kpezeshki/esp32-s31-sdr/em/lines/Z0_REPORT.md

# RF trace Z0 vs coplanar ground gap (Sonnet)

| case | Z0 (ohm) | loss @ 6 GHz (dB/mm) |
|---|---|---|
| w0.19_ginf | 50.8 | 0.028 |
| w0.19_g0.4 | 50.7 | 0.028 |
| w0.19_g0.3 | 50.6 | 0.028 |
| w0.19_g0.2 | 50.4 | 0.028 |
| w0.17_g0.2 | 57.6 | 0.041 |
| w0.16_g0.2 | 57.6 | 0.041 |
| w0.19_g0.15 | 49.8 | 0.028 |
| w0.17_g0.15 | 57.1 | 0.040 |
| w0.16_g0.15 | 57.1 | 0.040 |
