kpezeshki/esp32-s31-sdr/analysis/export/cascade_tables.md

# Cascade tables (auto-generated by analysis/cascade.py)

Assumptions: kT = -174.0 dBm/Hz, capture BW = 40 MHz complex, 8-bit I/Q, ESP32 NF = 5.0 dB.  
Pout columns = signal level at the *output* of each stage for the given antenna power (small-signal, ignores compression).  
'Noise out' = thermal + added noise density at each node.  ESP32 row = level at the ESP32 RF pin (before its internal gain).

## Summary

| Case | Gain to ESP32 pin | NF | IIP3 in | P1dB in | Noise dBm/40MHz | MDS 1 kHz | ADC clip @ant. | SFDR 10 kHz |
|---|---|---|---|---|---|---|---|---|
| LB 100 MHz | +12.2 | 2.46 | 1.7 | -9.1 | -95.5 | -141.5 | -52 |  89 |
| LB 1090 MHz | +6.2 | 4.46 | 7.7 | -3.1 | -93.5 | -139.5 | -50 |  91 |
| LB 1600 MHz | +2.9 | 6.44 | 11.0 | 0.2 | -91.5 | -137.6 | -48 |  92 |
| HB 3500 MHz | +3.7 | 6.34 | 4.5 | -5.6 | -91.6 | -137.7 | -48 |  88 |
| HB 5800 MHz | -1.5 | 10.20 | 5.7 | -5.0 | -87.8 | -133.8 | -44 |  86 |
| LB 1090 MHz + optional IF LNA | +20.2 | 3.72 | 2.7 | -7.6 | -94.3 | -140.3 | -50 |  89 |
| HB 5800 MHz + optional IF LNA | +12.5 | 8.94 | 4.8 | -5.0 | -89.0 | -135.1 | -45 |  87 |
| LB 100 MHz + gain block | +28.2 | 1.56 |  -14.6 |  -25.1 | -96.4 | -142.4 | -53 |  79 |
| LB 1090 MHz + gain block | +21.7 | 1.73 | -8.2 |  -18.6 | -96.2 | -142.3 | -52 |  83 |
| LB 1600 MHz + gain block | +18.1 | 2.02 | -4.7 |  -15.0 | -96.0 | -142.0 | -52 |  85 |
| HB 3500 MHz + gain block | +17.5 | 2.94 | -8.2 |  -19.4 | -95.0 | -141.1 | -51 |  82 |
| HB 5800 MHz + gain block | +10.6 | 4.46 | -5.9 |  -17.1 | -93.5 | -139.5 | -50 |  82 |
| Native ESP32 path 2441 MHz | -0.7 | 5.70 |  --  |  --  | -92.3 | -138.3 | -48 |  --  |

## Node tables

### LB 100 MHz

| # | Stage | G | NF | IIP3 (stage) | Cum G | Cum NF | Cum IIP3 (in-ref) | Noise out dBm/Hz | Noise out dBm/40MHz | Pout @ Pin=-100 | Pout @ Pin=-60 | Pout @ Pin=-30 |
|---|---|---|---|---|---|---|---|---|---|---|---|---|
| 1 | SMA + ESD + trace | -0.3 | 0.3 |  --  | -0.3 | 0.30 |  --  | -174.0 | -98.0 | -100.3 | -60.3 | -30.3 |
| 2 | SPDT_in (band select) | -0.4 | 0.4 | 60.0 | -0.7 | 0.70 | 60.3 | -174.0 | -98.0 | -100.7 | -60.7 | -30.7 |
| 3 | LNA_LB (SPF5189Z-cl.) | +23.0 | 0.8 | 15.5 | +22.3 | 1.50 | 16.2 | -150.2 | -74.2 | -77.7 | -37.7 | -7.7 |
| 4 | Post-LNA LPF 1.75G | -0.8 | 0.8 |  --  | +21.5 | 1.50 | 16.2 | -151.0 | -75.0 | -78.5 | -38.5 | -8.5 |
| 5 | SPDT_out | -0.4 | 0.4 | 60.0 | +21.1 | 1.51 | 16.2 | -151.4 | -75.4 | -78.9 | -38.9 | -8.9 |
| 6 | Input balun 1:2 | -1.0 | 1.0 |  --  | +20.1 | 1.51 | 16.2 | -152.4 | -76.4 | -79.9 | -39.9 | -9.9 |
| 7 | RFFC507x mixer + 4:1 balun | -5.0 | 13.0 | 22.0 | +15.1 | 2.05 | 1.7 | -156.9 | -80.8 | -84.9 | -44.9 | -14.9 |
| 8 | IF SAW/BAW 2.44G | -2.5 | 2.5 | 45.0 | +12.6 | 2.11 | 1.7 | -159.3 | -83.3 | -87.4 | -47.4 | -17.4 |
| 9 | 0R tee + ESP32 match | -0.4 | 0.4 |  --  | +12.2 | 2.12 | 1.7 | -159.7 | -83.7 | -87.8 | -47.8 | -17.8 |
| 10 | ESP32-S31 RX | +0.0 | 5.0 |  --  | +12.2 | 2.46 | 1.7 | -159.3 | -83.3 | -87.8 | -47.8 | -17.8 |

Gain to ESP32 pin **+12.2 dB**, system NF (incl. ESP32 5 dB) **2.46 dB**, front-end input IIP3 **+1.7 dBm**, first-stage input P1dB **-9.1 dBm** (analog, excl. ESP32/ADC).  
Noise floor at antenna: -171.5 dBm/Hz = -95.5 dBm in 40 MHz; MDS(1 kHz, SNR 0 dB) -141.5 dBm; 8-bit ADC instantaneous DR ~44 dB in 40 MHz -> in-band clip ~**-52 dBm** at the antenna (ESP32 gain set so noise sits 6 dB over quantization); SFDR(analog, 10 kHz) 89 dB.

### LB 1090 MHz

| # | Stage | G | NF | IIP3 (stage) | Cum G | Cum NF | Cum IIP3 (in-ref) | Noise out dBm/Hz | Noise out dBm/40MHz | Pout @ Pin=-100 | Pout @ Pin=-60 | Pout @ Pin=-30 |
|---|---|---|---|---|---|---|---|---|---|---|---|---|
| 1 | SMA + ESD + trace | -0.3 | 0.3 |  --  | -0.3 | 0.30 |  --  | -174.0 | -98.0 | -100.3 | -60.3 | -30.3 |
| 2 | SPDT_in (band select) | -0.4 | 0.4 | 60.0 | -0.7 | 0.70 | 60.3 | -174.0 | -98.0 | -100.7 | -60.7 | -30.7 |
| 3 | LNA_LB (SPF5189Z-cl.) | +17.4 | 0.8 | 21.1 | +16.7 | 1.48 | 21.8 | -155.8 | -79.8 | -83.3 | -43.3 | -13.3 |
| 4 | Post-LNA LPF 1.75G | -1.2 | 1.2 |  --  | +15.5 | 1.51 | 21.8 | -157.0 | -81.0 | -84.5 | -44.5 | -14.5 |
| 5 | SPDT_out | -0.4 | 0.4 | 60.0 | +15.1 | 1.51 | 21.8 | -157.4 | -81.4 | -84.9 | -44.9 | -14.9 |
| 6 | Input balun 1:2 | -1.0 | 1.0 |  --  | +14.1 | 1.54 | 21.8 | -158.4 | -82.3 | -85.9 | -45.9 | -15.9 |
| 7 | RFFC507x mixer + 4:1 balun | -5.0 | 13.0 | 22.0 | +9.1 | 3.35 | 7.7 | -161.5 | -85.5 | -90.9 | -50.9 | -20.9 |
| 8 | IF SAW/BAW 2.44G | -2.5 | 2.5 | 45.0 | +6.6 | 3.53 | 7.7 | -163.9 | -87.8 | -93.4 | -53.4 | -23.4 |
| 9 | 0R tee + ESP32 match | -0.4 | 0.4 |  --  | +6.2 | 3.57 | 7.7 | -164.2 | -88.2 | -93.8 | -53.8 | -23.8 |
| 10 | ESP32-S31 RX | +0.0 | 5.0 |  --  | +6.2 | 4.46 | 7.7 | -163.3 | -87.3 | -93.8 | -53.8 | -23.8 |

Gain to ESP32 pin **+6.2 dB**, system NF (incl. ESP32 5 dB) **4.46 dB**, front-end input IIP3 **+7.7 dBm**, first-stage input P1dB **-3.1 dBm** (analog, excl. ESP32/ADC).  
Noise floor at antenna: -169.5 dBm/Hz = -93.5 dBm in 40 MHz; MDS(1 kHz, SNR 0 dB) -139.5 dBm; 8-bit ADC instantaneous DR ~44 dB in 40 MHz -> in-band clip ~**-50 dBm** at the antenna (ESP32 gain set so noise sits 6 dB over quantization); SFDR(analog, 10 kHz) 91 dB.

### LB 1600 MHz

| # | Stage | G | NF | IIP3 (stage) | Cum G | Cum NF | Cum IIP3 (in-ref) | Noise out dBm/Hz | Noise out dBm/40MHz | Pout @ Pin=-100 | Pout @ Pin=-60 | Pout @ Pin=-30 |
|---|---|---|---|---|---|---|---|---|---|---|---|---|
| 1 | SMA + ESD + trace | -0.3 | 0.3 |  --  | -0.3 | 0.30 |  --  | -174.0 | -98.0 | -100.3 | -60.3 | -30.3 |
| 2 | SPDT_in (band select) | -0.4 | 0.4 | 60.0 | -0.7 | 0.70 | 60.3 | -174.0 | -98.0 | -100.7 | -60.7 | -30.7 |
| 3 | LNA_LB (SPF5189Z-cl.) | +14.4 | 0.8 | 24.1 | +13.7 | 1.46 | 24.8 | -158.9 | -82.8 | -86.3 | -46.3 | -16.3 |
| 4 | Post-LNA LPF 1.75G | -1.5 | 1.5 |  --  | +12.2 | 1.51 | 24.8 | -160.3 | -84.3 | -87.8 | -47.8 | -17.8 |
| 5 | SPDT_out | -0.4 | 0.4 | 60.0 | +11.8 | 1.53 | 24.8 | -160.7 | -84.7 | -88.2 | -48.2 | -18.2 |
| 6 | Input balun 1:2 | -1.0 | 1.0 |  --  | +10.8 | 1.58 | 24.8 | -161.7 | -85.6 | -89.2 | -49.2 | -19.2 |
| 7 | RFFC507x mixer + 4:1 balun | -5.0 | 13.0 | 22.0 | +5.8 | 4.82 | 11.1 | -163.4 | -87.4 | -94.2 | -54.2 | -24.2 |
| 8 | IF SAW/BAW 2.44G | -2.5 | 2.5 | 45.0 | +3.3 | 5.10 | 11.0 | -165.6 | -89.6 | -96.7 | -56.7 | -26.7 |
| 9 | 0R tee + ESP32 match | -0.4 | 0.4 |  --  | +2.9 | 5.16 | 11.0 | -166.0 | -90.0 | -97.1 | -57.1 | -27.1 |
| 10 | ESP32-S31 RX | +0.0 | 5.0 |  --  | +2.9 | 6.44 | 11.0 | -164.7 | -88.7 | -97.1 | -57.1 | -27.1 |

Gain to ESP32 pin **+2.9 dB**, system NF (incl. ESP32 5 dB) **6.44 dB**, front-end input IIP3 **+11.0 dBm**, first-stage input P1dB **+0.2 dBm** (analog, excl. ESP32/ADC).  
Noise floor at antenna: -167.6 dBm/Hz = -91.5 dBm in 40 MHz; MDS(1 kHz, SNR 0 dB) -137.6 dBm; 8-bit ADC instantaneous DR ~44 dB in 40 MHz -> in-band clip ~**-48 dBm** at the antenna (ESP32 gain set so noise sits 6 dB over quantization); SFDR(analog, 10 kHz) 92 dB.

### HB 3500 MHz

| # | Stage | G | NF | IIP3 (stage) | Cum G | Cum NF | Cum IIP3 (in-ref) | Noise out dBm/Hz | Noise out dBm/40MHz | Pout @ Pin=-100 | Pout @ Pin=-60 | Pout @ Pin=-30 |
|---|---|---|---|---|---|---|---|---|---|---|---|---|
| 1 | SMA + ESD + trace | -0.4 | 0.4 |  --  | -0.4 | 0.43 |  --  | -174.0 | -98.0 | -100.4 | -60.4 | -30.4 |
| 2 | SPDT_in (band select) | -0.7 | 0.7 | 60.0 | -1.1 | 1.08 | 60.4 | -174.0 | -98.0 | -101.1 | -61.1 | -31.1 |
| 3 | Pre-LNA HPF 2nd order | -0.3 | 0.3 |  --  | -1.4 | 1.38 | 60.4 | -174.0 | -98.0 | -101.4 | -61.4 | -31.4 |
| 4 | LNA_HB (0.5-6G MMIC) | +17.5 | 1.2 | 7.5 | +16.1 | 2.55 | 8.9 | -155.3 | -79.3 | -83.9 | -43.9 | -13.9 |
| 5 | Post-LNA HPF 2.95G | -1.3 | 1.3 |  --  | +14.9 | 2.57 | 8.9 | -156.6 | -80.6 | -85.2 | -45.1 | -15.1 |
| 6 | SPDT_out | -0.7 | 0.7 | 60.0 | +14.2 | 2.58 | 8.9 | -157.2 | -81.2 | -85.8 | -45.8 | -15.8 |
| 7 | Input balun 1:2 | -1.3 | 1.3 |  --  | +12.9 | 2.61 | 8.9 | -158.5 | -82.5 | -87.1 | -47.1 | -17.1 |
| 8 | RFFC507x mixer + 4:1 balun | -6.3 | 14.3 | 19.3 | +6.6 | 5.00 | 4.5 | -162.4 | -86.4 | -93.4 | -53.4 | -23.4 |
| 9 | IF SAW/BAW 2.44G | -2.5 | 2.5 | 45.0 | +4.1 | 5.23 | 4.5 | -164.7 | -88.7 | -95.9 | -55.9 | -25.9 |
| 10 | 0R tee + ESP32 match | -0.4 | 0.4 |  --  | +3.7 | 5.28 | 4.5 | -165.1 | -89.0 | -96.3 | -56.3 | -26.3 |
| 11 | ESP32-S31 RX | +0.0 | 5.0 |  --  | +3.7 | 6.34 | 4.5 | -164.0 | -88.0 | -96.3 | -56.3 | -26.3 |

Gain to ESP32 pin **+3.7 dB**, system NF (incl. ESP32 5 dB) **6.34 dB**, front-end input IIP3 **+4.5 dBm**, first-stage input P1dB **-5.6 dBm** (analog, excl. ESP32/ADC).  
Noise floor at antenna: -167.7 dBm/Hz = -91.6 dBm in 40 MHz; MDS(1 kHz, SNR 0 dB) -137.7 dBm; 8-bit ADC instantaneous DR ~44 dB in 40 MHz -> in-band clip ~**-48 dBm** at the antenna (ESP32 gain set so noise sits 6 dB over quantization); SFDR(analog, 10 kHz) 88 dB.

### HB 5800 MHz

| # | Stage | G | NF | IIP3 (stage) | Cum G | Cum NF | Cum IIP3 (in-ref) | Noise out dBm/Hz | Noise out dBm/40MHz | Pout @ Pin=-100 | Pout @ Pin=-60 | Pout @ Pin=-30 |
|---|---|---|---|---|---|---|---|---|---|---|---|---|
| 1 | SMA + ESD + trace | -0.6 | 0.6 |  --  | -0.6 | 0.59 |  --  | -174.0 | -98.0 | -100.6 | -60.6 | -30.6 |
| 2 | SPDT_in (band select) | -0.9 | 0.9 | 60.0 | -1.5 | 1.47 | 60.6 | -174.0 | -98.0 | -101.5 | -61.5 | -31.5 |
| 3 | Pre-LNA HPF 2nd order | -0.3 | 0.3 |  --  | -1.8 | 1.77 | 60.6 | -174.0 | -98.0 | -101.8 | -61.8 | -31.8 |
| 4 | LNA_HB (0.5-6G MMIC) | +15.2 | 1.5 | 9.8 | +13.4 | 3.24 | 11.6 | -157.3 | -81.3 | -86.6 | -46.6 | -16.6 |
| 5 | Post-LNA HPF 2.95G | -1.6 | 1.6 |  --  | +11.9 | 3.28 | 11.6 | -158.9 | -82.8 | -88.1 | -48.1 | -18.1 |
| 6 | SPDT_out | -0.9 | 0.9 | 60.0 | +11.0 | 3.31 | 11.6 | -159.7 | -83.7 | -89.0 | -49.0 | -19.0 |
| 7 | Input balun 1:2 | -1.8 | 1.8 |  --  | +9.2 | 3.39 | 11.6 | -161.4 | -85.4 | -90.8 | -50.8 | -20.8 |
| 8 | RFFC507x mixer + 4:1 balun | -7.9 | 15.9 | 16.3 | +1.4 | 8.25 | 5.7 | -164.4 | -88.4 | -98.6 | -58.6 | -28.6 |
| 9 | IF SAW/BAW 2.44G | -2.5 | 2.5 | 45.0 | -1.1 | 8.61 | 5.7 | -166.5 | -90.5 | -101.1 | -61.1 | -31.1 |
| 10 | 0R tee + ESP32 match | -0.4 | 0.4 |  --  | -1.5 | 8.68 | 5.7 | -166.9 | -90.8 | -101.5 | -61.5 | -31.5 |
| 11 | ESP32-S31 RX | +0.0 | 5.0 |  --  | -1.5 | 10.20 | 5.7 | -165.3 | -89.3 | -101.5 | -61.5 | -31.5 |

Gain to ESP32 pin **-1.5 dB**, system NF (incl. ESP32 5 dB) **10.20 dB**, front-end input IIP3 **+5.7 dBm**, first-stage input P1dB **-5.0 dBm** (analog, excl. ESP32/ADC).  
Noise floor at antenna: -163.8 dBm/Hz = -87.8 dBm in 40 MHz; MDS(1 kHz, SNR 0 dB) -133.8 dBm; 8-bit ADC instantaneous DR ~44 dB in 40 MHz -> in-band clip ~**-44 dBm** at the antenna (ESP32 gain set so noise sits 6 dB over quantization); SFDR(analog, 10 kHz) 86 dB.

### LB 1090 MHz + optional IF LNA

| # | Stage | G | NF | IIP3 (stage) | Cum G | Cum NF | Cum IIP3 (in-ref) | Noise out dBm/Hz | Noise out dBm/40MHz | Pout @ Pin=-100 | Pout @ Pin=-60 | Pout @ Pin=-30 |
|---|---|---|---|---|---|---|---|---|---|---|---|---|
| 1 | SMA + ESD + trace | -0.3 | 0.3 |  --  | -0.3 | 0.30 |  --  | -174.0 | -98.0 | -100.3 | -60.3 | -30.3 |
| 2 | SPDT_in (band select) | -0.4 | 0.4 | 60.0 | -0.7 | 0.70 | 60.3 | -174.0 | -98.0 | -100.7 | -60.7 | -30.7 |
| 3 | LNA_LB (SPF5189Z-cl.) | +17.4 | 0.8 | 21.1 | +16.7 | 1.48 | 21.8 | -155.8 | -79.8 | -83.3 | -43.3 | -13.3 |
| 4 | Post-LNA LPF 1.75G | -1.2 | 1.2 |  --  | +15.5 | 1.51 | 21.8 | -157.0 | -81.0 | -84.5 | -44.5 | -14.5 |
| 5 | SPDT_out | -0.4 | 0.4 | 60.0 | +15.1 | 1.51 | 21.8 | -157.4 | -81.4 | -84.9 | -44.9 | -14.9 |
| 6 | Input balun 1:2 | -1.0 | 1.0 |  --  | +14.1 | 1.54 | 21.8 | -158.4 | -82.3 | -85.9 | -45.9 | -15.9 |
| 7 | RFFC507x mixer + 4:1 balun | -5.0 | 13.0 | 22.0 | +9.1 | 3.35 | 7.7 | -161.5 | -85.5 | -90.9 | -50.9 | -20.9 |
| 8 | IF SAW/BAW 2.44G | -2.5 | 2.5 | 45.0 | +6.6 | 3.53 | 7.7 | -163.9 | -87.8 | -93.4 | -53.4 | -23.4 |
| 9 | IF LNA 2.4G (opt.) | +14.0 | 1.3 | 11.0 | +20.6 | 3.68 | 2.7 | -149.7 | -73.7 | -79.4 | -39.4 | -9.4 |
| 10 | 0R tee + ESP32 match | -0.4 | 0.4 |  --  | +20.2 | 3.68 | 2.7 | -150.1 | -74.1 | -79.8 | -39.8 | -9.8 |
| 11 | ESP32-S31 RX | +0.0 | 5.0 |  --  | +20.2 | 3.72 | 2.7 | -150.1 | -74.1 | -79.8 | -39.8 | -9.8 |

Gain to ESP32 pin **+20.2 dB**, system NF (incl. ESP32 5 dB) **3.72 dB**, front-end input IIP3 **+2.7 dBm**, first-stage input P1dB **-7.6 dBm** (analog, excl. ESP32/ADC).  
Noise floor at antenna: -170.3 dBm/Hz = -94.3 dBm in 40 MHz; MDS(1 kHz, SNR 0 dB) -140.3 dBm; 8-bit ADC instantaneous DR ~44 dB in 40 MHz -> in-band clip ~**-50 dBm** at the antenna (ESP32 gain set so noise sits 6 dB over quantization); SFDR(analog, 10 kHz) 89 dB.

### HB 5800 MHz + optional IF LNA

| # | Stage | G | NF | IIP3 (stage) | Cum G | Cum NF | Cum IIP3 (in-ref) | Noise out dBm/Hz | Noise out dBm/40MHz | Pout @ Pin=-100 | Pout @ Pin=-60 | Pout @ Pin=-30 |
|---|---|---|---|---|---|---|---|---|---|---|---|---|
| 1 | SMA + ESD + trace | -0.6 | 0.6 |  --  | -0.6 | 0.59 |  --  | -174.0 | -98.0 | -100.6 | -60.6 | -30.6 |
| 2 | SPDT_in (band select) | -0.9 | 0.9 | 60.0 | -1.5 | 1.47 | 60.6 | -174.0 | -98.0 | -101.5 | -61.5 | -31.5 |
| 3 | Pre-LNA HPF 2nd order | -0.3 | 0.3 |  --  | -1.8 | 1.77 | 60.6 | -174.0 | -98.0 | -101.8 | -61.8 | -31.8 |
| 4 | LNA_HB (0.5-6G MMIC) | +15.2 | 1.5 | 9.8 | +13.4 | 3.24 | 11.6 | -157.3 | -81.3 | -86.6 | -46.6 | -16.6 |
| 5 | Post-LNA HPF 2.95G | -1.6 | 1.6 |  --  | +11.9 | 3.28 | 11.6 | -158.9 | -82.8 | -88.1 | -48.1 | -18.1 |
| 6 | SPDT_out | -0.9 | 0.9 | 60.0 | +11.0 | 3.31 | 11.6 | -159.7 | -83.7 | -89.0 | -49.0 | -19.0 |
| 7 | Input balun 1:2 | -1.8 | 1.8 |  --  | +9.2 | 3.39 | 11.6 | -161.4 | -85.4 | -90.8 | -50.8 | -20.8 |
| 8 | RFFC507x mixer + 4:1 balun | -7.9 | 15.9 | 16.3 | +1.4 | 8.25 | 5.7 | -164.4 | -88.4 | -98.6 | -58.6 | -28.6 |
| 9 | IF SAW/BAW 2.44G | -2.5 | 2.5 | 45.0 | -1.1 | 8.61 | 5.7 | -166.5 | -90.5 | -101.1 | -61.1 | -31.1 |
| 10 | IF LNA 2.4G (opt.) | +14.0 | 1.3 | 11.0 | +12.9 | 8.87 | 4.8 | -152.3 | -76.3 | -87.1 | -47.1 | -17.1 |
| 11 | 0R tee + ESP32 match | -0.4 | 0.4 |  --  | +12.5 | 8.87 | 4.8 | -152.7 | -76.7 | -87.5 | -47.5 | -17.5 |
| 12 | ESP32-S31 RX | +0.0 | 5.0 |  --  | +12.5 | 8.94 | 4.8 | -152.6 | -76.6 | -87.5 | -47.5 | -17.5 |

Gain to ESP32 pin **+12.5 dB**, system NF (incl. ESP32 5 dB) **8.94 dB**, front-end input IIP3 **+4.8 dBm**, first-stage input P1dB **-5.0 dBm** (analog, excl. ESP32/ADC).  
Noise floor at antenna: -165.1 dBm/Hz = -89.0 dBm in 40 MHz; MDS(1 kHz, SNR 0 dB) -135.1 dBm; 8-bit ADC instantaneous DR ~44 dB in 40 MHz -> in-band clip ~**-45 dBm** at the antenna (ESP32 gain set so noise sits 6 dB over quantization); SFDR(analog, 10 kHz) 87 dB.

### LB 100 MHz + gain block

| # | Stage | G | NF | IIP3 (stage) | Cum G | Cum NF | Cum IIP3 (in-ref) | Noise out dBm/Hz | Noise out dBm/40MHz | Pout @ Pin=-100 | Pout @ Pin=-60 | Pout @ Pin=-30 |
|---|---|---|---|---|---|---|---|---|---|---|---|---|
| 1 | SMA + ESD + trace | -0.3 | 0.3 |  --  | -0.3 | 0.30 |  --  | -174.0 | -98.0 | -100.3 | -60.3 | -30.3 |
| 2 | SPDT_in (band select) | -0.4 | 0.4 | 60.0 | -0.7 | 0.70 | 60.3 | -174.0 | -98.0 | -100.7 | -60.7 | -30.7 |
| 3 | LNA_LB (SPF5189Z-cl.) | +23.0 | 0.8 | 15.5 | +22.3 | 1.50 | 16.2 | -150.2 | -74.2 | -77.7 | -37.7 | -7.7 |
| 4 | Post-LNA LPF 1.75G | -0.8 | 0.8 |  --  | +21.5 | 1.50 | 16.2 | -151.0 | -75.0 | -78.5 | -38.5 | -8.5 |
| 5 | SPDT_out | -0.4 | 0.4 | 60.0 | +21.1 | 1.51 | 16.2 | -151.4 | -75.4 | -78.9 | -38.9 | -8.9 |
| 6 | Gain block (opt.) | +16.0 | 3.0 | 16.0 | +37.1 | 1.53 | -5.1 | -135.4 | -59.3 | -62.9 | -22.9 | 7.1 |
| 7 | Input balun 1:2 | -1.0 | 1.0 |  --  | +36.1 | 1.53 | -5.1 | -136.4 | -60.3 | -63.9 | -23.9 | 6.1 |
| 8 | RFFC507x mixer + 4:1 balun | -5.0 | 13.0 | 22.0 | +31.1 | 1.54 |  -14.6 | -141.4 | -65.3 | -68.9 | -28.9 | 1.1 |
| 9 | IF SAW/BAW 2.44G | -2.5 | 2.5 | 45.0 | +28.6 | 1.55 |  -14.6 | -143.9 | -67.8 | -71.4 | -31.4 | -1.4 |
| 10 | 0R tee + ESP32 match | -0.4 | 0.4 |  --  | +28.2 | 1.55 |  -14.6 | -144.3 | -68.2 | -71.8 | -31.8 | -1.8 |
| 11 | ESP32-S31 RX | +0.0 | 5.0 |  --  | +28.2 | 1.56 |  -14.6 | -144.2 | -68.2 | -71.8 | -31.8 | -1.8 |

Gain to ESP32 pin **+28.2 dB**, system NF (incl. ESP32 5 dB) **1.56 dB**, front-end input IIP3 **-14.6 dBm**, first-stage input P1dB **-25.1 dBm** (analog, excl. ESP32/ADC).  
Noise floor at antenna: -172.4 dBm/Hz = -96.4 dBm in 40 MHz; MDS(1 kHz, SNR 0 dB) -142.4 dBm; 8-bit ADC instantaneous DR ~44 dB in 40 MHz -> in-band clip ~**-53 dBm** at the antenna (ESP32 gain set so noise sits 6 dB over quantization); SFDR(analog, 10 kHz) 79 dB.

### LB 1090 MHz + gain block

| # | Stage | G | NF | IIP3 (stage) | Cum G | Cum NF | Cum IIP3 (in-ref) | Noise out dBm/Hz | Noise out dBm/40MHz | Pout @ Pin=-100 | Pout @ Pin=-60 | Pout @ Pin=-30 |
|---|---|---|---|---|---|---|---|---|---|---|---|---|
| 1 | SMA + ESD + trace | -0.3 | 0.3 |  --  | -0.3 | 0.30 |  --  | -174.0 | -98.0 | -100.3 | -60.3 | -30.3 |
| 2 | SPDT_in (band select) | -0.4 | 0.4 | 60.0 | -0.7 | 0.70 | 60.3 | -174.0 | -98.0 | -100.7 | -60.7 | -30.7 |
| 3 | LNA_LB (SPF5189Z-cl.) | +17.4 | 0.8 | 21.1 | +16.7 | 1.48 | 21.8 | -155.8 | -79.8 | -83.3 | -43.3 | -13.3 |
| 4 | Post-LNA LPF 1.75G | -1.2 | 1.2 |  --  | +15.5 | 1.51 | 21.8 | -157.0 | -81.0 | -84.5 | -44.5 | -14.5 |
| 5 | SPDT_out | -0.4 | 0.4 | 60.0 | +15.1 | 1.51 | 21.8 | -157.4 | -81.4 | -84.9 | -44.9 | -14.9 |
| 6 | Gain block (opt.) | +15.5 | 3.3 | 15.5 | +30.6 | 1.62 | 0.3 | -141.8 | -65.8 | -69.4 | -29.4 | 0.6 |
| 7 | Input balun 1:2 | -1.0 | 1.0 |  --  | +29.6 | 1.62 | 0.3 | -142.8 | -66.8 | -70.4 | -30.4 | -0.4 |
| 8 | RFFC507x mixer + 4:1 balun | -5.0 | 13.0 | 22.0 | +24.6 | 1.68 | -8.2 | -147.7 | -71.7 | -75.4 | -35.4 | -5.4 |
| 9 | IF SAW/BAW 2.44G | -2.5 | 2.5 | 45.0 | +22.1 | 1.69 | -8.2 | -150.2 | -74.2 | -77.9 | -37.9 | -7.9 |
| 10 | 0R tee + ESP32 match | -0.4 | 0.4 |  --  | +21.7 | 1.69 | -8.2 | -150.6 | -74.6 | -78.3 | -38.3 | -8.3 |
| 11 | ESP32-S31 RX | +0.0 | 5.0 |  --  | +21.7 | 1.73 | -8.2 | -150.6 | -74.6 | -78.3 | -38.3 | -8.3 |

Gain to ESP32 pin **+21.7 dB**, system NF (incl. ESP32 5 dB) **1.73 dB**, front-end input IIP3 **-8.2 dBm**, first-stage input P1dB **-18.6 dBm** (analog, excl. ESP32/ADC).  
Noise floor at antenna: -172.3 dBm/Hz = -96.2 dBm in 40 MHz; MDS(1 kHz, SNR 0 dB) -142.3 dBm; 8-bit ADC instantaneous DR ~44 dB in 40 MHz -> in-band clip ~**-52 dBm** at the antenna (ESP32 gain set so noise sits 6 dB over quantization); SFDR(analog, 10 kHz) 83 dB.

### LB 1600 MHz + gain block

| # | Stage | G | NF | IIP3 (stage) | Cum G | Cum NF | Cum IIP3 (in-ref) | Noise out dBm/Hz | Noise out dBm/40MHz | Pout @ Pin=-100 | Pout @ Pin=-60 | Pout @ Pin=-30 |
|---|---|---|---|---|---|---|---|---|---|---|---|---|
| 1 | SMA + ESD + trace | -0.3 | 0.3 |  --  | -0.3 | 0.30 |  --  | -174.0 | -98.0 | -100.3 | -60.3 | -30.3 |
| 2 | SPDT_in (band select) | -0.4 | 0.4 | 60.0 | -0.7 | 0.70 | 60.3 | -174.0 | -98.0 | -100.7 | -60.7 | -30.7 |
| 3 | LNA_LB (SPF5189Z-cl.) | +14.4 | 0.8 | 24.1 | +13.7 | 1.46 | 24.8 | -158.9 | -82.8 | -86.3 | -46.3 | -16.3 |
| 4 | Post-LNA LPF 1.75G | -1.5 | 1.5 |  --  | +12.2 | 1.51 | 24.8 | -160.3 | -84.3 | -87.8 | -47.8 | -17.8 |
| 5 | SPDT_out | -0.4 | 0.4 | 60.0 | +11.8 | 1.53 | 24.8 | -160.7 | -84.7 | -88.2 | -48.2 | -18.2 |
| 6 | Gain block (opt.) | +15.2 | 3.4 | 15.2 | +27.0 | 1.76 | 3.4 | -145.3 | -69.2 | -73.0 | -33.0 | -3.0 |
| 7 | Input balun 1:2 | -1.0 | 1.0 |  --  | +26.0 | 1.77 | 3.4 | -146.3 | -70.2 | -74.0 | -34.0 | -4.0 |
| 8 | RFFC507x mixer + 4:1 balun | -5.0 | 13.0 | 22.0 | +21.0 | 1.90 | -4.7 | -151.1 | -75.1 | -79.0 | -39.0 | -9.0 |
| 9 | IF SAW/BAW 2.44G | -2.5 | 2.5 | 45.0 | +18.5 | 1.92 | -4.7 | -153.6 | -77.6 | -81.5 | -41.5 | -11.5 |
| 10 | 0R tee + ESP32 match | -0.4 | 0.4 |  --  | +18.1 | 1.92 | -4.7 | -154.0 | -78.0 | -81.9 | -41.9 | -11.9 |
| 11 | ESP32-S31 RX | +0.0 | 5.0 |  --  | +18.1 | 2.02 | -4.7 | -153.9 | -77.9 | -81.9 | -41.9 | -11.9 |

Gain to ESP32 pin **+18.1 dB**, system NF (incl. ESP32 5 dB) **2.02 dB**, front-end input IIP3 **-4.7 dBm**, first-stage input P1dB **-15.0 dBm** (analog, excl. ESP32/ADC).  
Noise floor at antenna: -172.0 dBm/Hz = -96.0 dBm in 40 MHz; MDS(1 kHz, SNR 0 dB) -142.0 dBm; 8-bit ADC instantaneous DR ~44 dB in 40 MHz -> in-band clip ~**-52 dBm** at the antenna (ESP32 gain set so noise sits 6 dB over quantization); SFDR(analog, 10 kHz) 85 dB.

### HB 3500 MHz + gain block

| # | Stage | G | NF | IIP3 (stage) | Cum G | Cum NF | Cum IIP3 (in-ref) | Noise out dBm/Hz | Noise out dBm/40MHz | Pout @ Pin=-100 | Pout @ Pin=-60 | Pout @ Pin=-30 |
|---|---|---|---|---|---|---|---|---|---|---|---|---|
| 1 | SMA + ESD + trace | -0.4 | 0.4 |  --  | -0.4 | 0.43 |  --  | -174.0 | -98.0 | -100.4 | -60.4 | -30.4 |
| 2 | SPDT_in (band select) | -0.7 | 0.7 | 60.0 | -1.1 | 1.08 | 60.4 | -174.0 | -98.0 | -101.1 | -61.1 | -31.1 |
| 3 | Pre-LNA HPF 2nd order | -0.3 | 0.3 |  --  | -1.4 | 1.38 | 60.4 | -174.0 | -98.0 | -101.4 | -61.4 | -31.4 |
| 4 | LNA_HB (0.5-6G MMIC) | +17.5 | 1.2 | 7.5 | +16.1 | 2.55 | 8.9 | -155.3 | -79.3 | -83.9 | -43.9 | -13.9 |
| 5 | Post-LNA HPF 2.95G | -1.3 | 1.3 |  --  | +14.9 | 2.57 | 8.9 | -156.6 | -80.6 | -85.2 | -45.1 | -15.1 |
| 6 | SPDT_out | -0.7 | 0.7 | 60.0 | +14.2 | 2.58 | 8.9 | -157.2 | -81.2 | -85.8 | -45.8 | -15.8 |
| 7 | Gain block (opt.) | +13.9 | 3.9 | 14.2 | +28.1 | 2.71 | -0.5 | -143.2 | -67.2 | -71.9 | -31.9 | -1.9 |
| 8 | Input balun 1:2 | -1.3 | 1.3 |  --  | +26.8 | 2.71 | -0.5 | -144.5 | -68.5 | -73.2 | -33.2 | -3.2 |
| 9 | RFFC507x mixer + 4:1 balun | -6.3 | 14.3 | 19.3 | +20.4 | 2.84 | -8.2 | -150.7 | -74.7 | -79.6 | -39.6 | -9.6 |
| 10 | IF SAW/BAW 2.44G | -2.5 | 2.5 | 45.0 | +17.9 | 2.85 | -8.2 | -153.2 | -77.2 | -82.1 | -42.1 | -12.1 |
| 11 | 0R tee + ESP32 match | -0.4 | 0.4 |  --  | +17.5 | 2.86 | -8.2 | -153.6 | -77.6 | -82.5 | -42.5 | -12.5 |
| 12 | ESP32-S31 RX | +0.0 | 5.0 |  --  | +17.5 | 2.94 | -8.2 | -153.5 | -77.5 | -82.5 | -42.5 | -12.5 |

Gain to ESP32 pin **+17.5 dB**, system NF (incl. ESP32 5 dB) **2.94 dB**, front-end input IIP3 **-8.2 dBm**, first-stage input P1dB **-19.4 dBm** (analog, excl. ESP32/ADC).  
Noise floor at antenna: -171.1 dBm/Hz = -95.0 dBm in 40 MHz; MDS(1 kHz, SNR 0 dB) -141.1 dBm; 8-bit ADC instantaneous DR ~44 dB in 40 MHz -> in-band clip ~**-51 dBm** at the antenna (ESP32 gain set so noise sits 6 dB over quantization); SFDR(analog, 10 kHz) 82 dB.

### HB 5800 MHz + gain block

| # | Stage | G | NF | IIP3 (stage) | Cum G | Cum NF | Cum IIP3 (in-ref) | Noise out dBm/Hz | Noise out dBm/40MHz | Pout @ Pin=-100 | Pout @ Pin=-60 | Pout @ Pin=-30 |
|---|---|---|---|---|---|---|---|---|---|---|---|---|
| 1 | SMA + ESD + trace | -0.6 | 0.6 |  --  | -0.6 | 0.59 |  --  | -174.0 | -98.0 | -100.6 | -60.6 | -30.6 |
| 2 | SPDT_in (band select) | -0.9 | 0.9 | 60.0 | -1.5 | 1.47 | 60.6 | -174.0 | -98.0 | -101.5 | -61.5 | -31.5 |
| 3 | Pre-LNA HPF 2nd order | -0.3 | 0.3 |  --  | -1.8 | 1.77 | 60.6 | -174.0 | -98.0 | -101.8 | -61.8 | -31.8 |
| 4 | LNA_HB (0.5-6G MMIC) | +15.2 | 1.5 | 9.8 | +13.4 | 3.24 | 11.6 | -157.3 | -81.3 | -86.6 | -46.6 | -16.6 |
| 5 | Post-LNA HPF 2.95G | -1.6 | 1.6 |  --  | +11.9 | 3.28 | 11.6 | -158.9 | -82.8 | -88.1 | -48.1 | -18.1 |
| 6 | SPDT_out | -0.9 | 0.9 | 60.0 | +11.0 | 3.31 | 11.6 | -159.7 | -83.7 | -89.0 | -49.0 | -19.0 |
| 7 | Gain block (opt.) | +12.2 | 4.5 | 13.1 | +23.1 | 3.59 | 1.7 | -147.3 | -71.3 | -76.9 | -36.9 | -6.9 |
| 8 | Input balun 1:2 | -1.8 | 1.8 |  --  | +21.4 | 3.59 | 1.7 | -149.0 | -73.0 | -78.6 | -38.6 | -8.6 |
| 9 | RFFC507x mixer + 4:1 balun | -7.9 | 15.9 | 16.3 | +13.5 | 4.09 | -5.9 | -156.4 | -80.4 | -86.5 | -46.5 | -16.5 |
| 10 | IF SAW/BAW 2.44G | -2.5 | 2.5 | 45.0 | +11.0 | 4.14 | -5.9 | -158.9 | -82.8 | -89.0 | -49.0 | -19.0 |
| 11 | 0R tee + ESP32 match | -0.4 | 0.4 |  --  | +10.6 | 4.16 | -5.9 | -159.2 | -83.2 | -89.4 | -49.4 | -19.4 |
| 12 | ESP32-S31 RX | +0.0 | 5.0 |  --  | +10.6 | 4.46 | -5.9 | -158.9 | -82.9 | -89.4 | -49.4 | -19.4 |

Gain to ESP32 pin **+10.6 dB**, system NF (incl. ESP32 5 dB) **4.46 dB**, front-end input IIP3 **-5.9 dBm**, first-stage input P1dB **-17.1 dBm** (analog, excl. ESP32/ADC).  
Noise floor at antenna: -169.5 dBm/Hz = -93.5 dBm in 40 MHz; MDS(1 kHz, SNR 0 dB) -139.5 dBm; 8-bit ADC instantaneous DR ~44 dB in 40 MHz -> in-band clip ~**-50 dBm** at the antenna (ESP32 gain set so noise sits 6 dB over quantization); SFDR(analog, 10 kHz) 82 dB.

### Native ESP32 path 2441 MHz

| # | Stage | G | NF | IIP3 (stage) | Cum G | Cum NF | Cum IIP3 (in-ref) | Noise out dBm/Hz | Noise out dBm/40MHz | Pout @ Pin=-100 | Pout @ Pin=-60 | Pout @ Pin=-30 |
|---|---|---|---|---|---|---|---|---|---|---|---|---|
| 1 | SMA + ESD + trace | -0.3 | 0.3 |  --  | -0.3 | 0.30 |  --  | -174.0 | -98.0 | -100.3 | -60.3 | -30.3 |
| 2 | 0R tee + ESP32 match | -0.4 | 0.4 |  --  | -0.7 | 0.70 |  --  | -174.0 | -98.0 | -100.7 | -60.7 | -30.7 |
| 3 | ESP32-S31 RX | +0.0 | 5.0 |  --  | -0.7 | 5.70 |  --  | -169.0 | -93.0 | -100.7 | -60.7 | -30.7 |

Gain to ESP32 pin **-0.7 dB**, system NF (incl. ESP32 5 dB) **5.70 dB**, front-end input IIP3 **+99.0 dBm**, first-stage input P1dB **+99.0 dBm** (analog, excl. ESP32/ADC).  
Noise floor at antenna: -168.3 dBm/Hz = -92.3 dBm in 40 MHz; MDS(1 kHz, SNR 0 dB) -138.3 dBm; 8-bit ADC instantaneous DR ~44 dB in 40 MHz -> in-band clip ~**-48 dBm** at the antenna (ESP32 gain set so noise sits 6 dB over quantization); SFDR(analog, 10 kHz) 99 dB.

## Sensitivity of system NF to the (unknown) ESP32 NF

| ESP32 NF | LB 1090 | LB 1090 +IF LNA | LB 1090 +gain blk | HB 5800 | HB 5800 +IF LNA | HB 5800 +gain blk | Native |
|---|---|---|---|---|---|---|---|
| 3 dB | 4.01 | 3.70 | 1.71 | 9.44 | 8.90 | 4.30 | 3.70 |
| 5 dB | 4.46 | 3.72 | 1.73 | 10.20 | 8.94 | 4.46 | 5.70 |
| 8 dB | 5.50 | 3.77 | 1.80 | 11.75 | 9.04 | 4.87 | 8.70 |
| 10 dB | 6.47 | 3.84 | 1.87 | 13.06 | 9.15 | 5.30 | 10.70 |
