kpezeshki/esp32-s31-sdr/analysis/export/filter_HB_HPF.md

# Filter HB_HPF (auto-generated by analysis/filters.py)

Topology (from LNA side): s:C - p:LCs - s:C - p:LCs - s:C - p:L - s:C  (s = series, p = shunt to ground via 0.25 nH)

Parasitics: L Q=35, Cp=0.07 pF; C ESL=0.30 nH, ESR=0.15 ohm; node pad 0.05 pF (assumptions).

| # | Branch | Element | Continuous | Snapped | **Palette-reduced (build)** |
|---|---|---|---|---|---|
| 1 | 1 series C | C | 1.02 pF | 1 pF | **1.2 pF** |
| 2 | 2 shunt LCs | L | 2.20 nH | 2.2 nH | **2.2 nH** |
| 3 | 2 shunt LCs | C | 2.34 pF | 2.3 pF | **2.3 pF** |
| 4 | 3 series C | C | 0.71 pF | 0.7 pF | **0.7 pF** |
| 5 | 4 shunt LCs | L | 2.68 nH | 2.8 nH | **2.8 nH** |
| 6 | 4 shunt LCs | C | 1.25 pF | 1.2 pF | **1.2 pF** |
| 7 | 5 series C | C | 0.60 pF | 0.6 pF | **0.6 pF** |
| 8 | 6 shunt L | L | 1.64 nH | 1.6 nH | **1.6 nH** |
| 9 | 7 series C | C | 0.74 pF | 0.7 pF | **0.7 pF** |

Unique values (JLC part types): snapped 8, palette-reduced **7**.

| Metric | Continuous | Snapped | Reduced | Reduced, MC 1000 (5th pct worst) |
|---|---|---|---|---|
| IL max 3.10-6.00 GHz (spec <= 1.6) | 1.63 | 1.75 | 1.73 | 2.11 |
| RL min 3.10-6.00 GHz (spec >= 13.0) | 12.99 | 12.70 | 12.52 | 10.91 |
| Rej min 2.40-2.48 GHz (spec >= 47) | 47.08 | 47.99 | 47.10 | 39.08 |
| Rej min 0.03-1.90 GHz (spec >= 52) | 51.98 | 52.41 | 51.27 | 49.94 |
