kpezeshki/esp32-s31-sdr/analysis/export/filter_HB_PRE.md

# Filter HB_PRE (auto-generated by analysis/filters.py)

Topology (from LNA side): s:C - p:L - s:C  (s = series, p = shunt to ground via 0.25 nH)

Parasitics: L Q=35, Cp=0.07 pF; C ESL=0.30 nH, ESR=0.15 ohm; node pad 0.05 pF (assumptions).

| # | Branch | Element | Continuous | Snapped | **Palette-reduced (build)** |
|---|---|---|---|---|---|
| 1 | 1 series C | C | 1.38 pF | 1.4 pF | **1.6 pF** |
| 2 | 2 shunt L | L | 1.97 nH | 2 nH | **2 nH** |
| 3 | 3 series C | C | 1.58 pF | 1.6 pF | **1.6 pF** |

Unique values (JLC part types): snapped 3, palette-reduced **2**.

| Metric | Continuous | Snapped | Reduced | Reduced, MC 1000 (5th pct worst) |
|---|---|---|---|---|
| IL max 3.10-6.00 GHz (spec <= 0.35) | 0.26 | 0.25 | 0.26 | 0.30 |
| RL min 3.10-6.00 GHz (spec >= 15.0) | 18.70 | 19.19 | 18.31 | 16.41 |
| Rej min 0.03-1.00 GHz (spec >= 15) | 17.84 | 17.52 | 16.48 | 15.92 |
