kpezeshki/esp32-s31-sdr/analysis/export/filter_LB_LPF_s1.md

# Filter LB_LPF (auto-generated by analysis/filters.py)

Topology (from LNA side): s:L - p:C - s:L - p:LCs - s:L - p:LCs - s:L  (s = series, p = shunt to ground via 0.25 nH)

Parasitics: L Q=35, Cp=0.07 pF; C ESL=0.30 nH, ESR=0.15 ohm; node pad 0.05 pF (assumptions).

| # | Branch | Element | Continuous | Snapped | **Palette-reduced (build)** |
|---|---|---|---|---|---|
| 1 | 1 series L | L | 2.49 nH | 2.3 nH | **3.3 nH** |
| 2 | 2 shunt C | C | 1.64 pF | 1.8 pF | **1.8 pF** |
| 3 | 3 series L | L | 4.97 nH | 5.6 nH | **4.3 nH** |
| 4 | 4 shunt LCs | L | 3.71 nH | 3.3 nH | **3.3 nH** |
| 5 | 4 shunt LCs | C | 1.06 pF | 1.1 pF | **1.1 pF** |
| 6 | 5 series L | L | 5.06 nH | 5.1 nH | **4.3 nH** |
| 7 | 6 shunt LCs | L | 4.35 nH | 4.3 nH | **3.3 nH** |
| 8 | 6 shunt LCs | C | 0.80 pF | 0.8 pF | **1.1 pF** |
| 9 | 7 series L | L | 1.66 nH | 1.7 nH | **2.3 nH** |

Unique values (JLC part types): snapped 9, palette-reduced **5**.

| Metric | Continuous | Snapped | Reduced | Reduced, MC 1000 (5th pct worst) |
|---|---|---|---|---|
| IL max 0.03-1.75 GHz (spec <= 1.0) | 0.99 | 0.92 | 0.96 | 1.05 |
| RL min 0.03-1.75 GHz (spec >= 14.0) | 15.19 | 14.02 | 17.27 | 15.00 |
| Rej min 2.40-2.48 GHz (spec >= 42) | 44.08 | 55.02 | 46.96 | 41.87 |
| Rej min 2.48-4.80 GHz (spec >= 30) | 30.04 | 33.93 | 33.81 | 32.81 |
| Rej min 4.80-7.60 GHz (spec >= 47) | 49.77 | 52.08 | 52.50 | 51.79 |
