kpezeshki/esp32-s31-sdr/analysis/export/filter_MB_HP.md

# Filter MB_HP (auto-generated by analysis/filters.py)

Topology (from LNA side): s:C - p:LCs - s:C - p:LCs - s:C - p:L - s:C  (s = series, p = shunt to ground via 0.25 nH)

Parasitics: L Q=35, Cp=0.07 pF; C ESL=0.30 nH, ESR=0.15 ohm; node pad 0.05 pF (assumptions).

| # | Branch | Element | Continuous | Snapped | **Palette-reduced (build)** |
|---|---|---|---|---|---|
| 1 | 1 series C | C | 1.96 pF | 1.9 pF | **1.7 pF** |
| 2 | 2 shunt LCs | L | 7.26 nH | 7.5 nH | **7.5 nH** |
| 3 | 2 shunt LCs | C | 1.68 pF | 1.7 pF | **1.7 pF** |
| 4 | 3 series C | C | 1.27 pF | 1.2 pF | **1.2 pF** |
| 5 | 4 shunt LCs | L | 10.66 nH | 11 nH | **11 nH** |
| 6 | 4 shunt LCs | C | 0.90 pF | 0.9 pF | **0.9 pF** |
| 7 | 5 series C | C | 0.85 pF | 0.8 pF | **0.9 pF** |
| 8 | 6 shunt L | L | 3.99 nH | 3.9 nH | **3.9 nH** |
| 9 | 7 series C | C | 1.04 pF | 1 pF | **1.2 pF** |

Unique values (JLC part types): snapped 9, palette-reduced **6**.

| Metric | Continuous | Snapped | Reduced | Reduced, MC 1000 (5th pct worst) |
|---|---|---|---|---|
| IL max 1.75-2.50 GHz (spec <= 0.9) | 2.23 | 2.25 | 1.92 | 2.38 |
| RL min 1.75-2.50 GHz (spec >= 15.0) | 14.89 | 14.11 | 12.56 | 11.44 |
| Rej min 0.03-1.55 GHz (spec >= 38) | 33.30 | 27.18 | 24.64 | 16.47 |
