kpezeshki/esp32-s31-sdr/analysis/export/filter_MB_LP.md

# Filter MB_LP (auto-generated by analysis/filters.py)

Topology (from LNA side): s:L - p:LCs - s:L - p:LCs - s:L - p:LCs - s:L  (s = series, p = shunt to ground via 0.25 nH)

Parasitics: L Q=35, Cp=0.07 pF; C ESL=0.30 nH, ESR=0.15 ohm; node pad 0.05 pF (assumptions).

| # | Branch | Element | Continuous | Snapped | **Palette-reduced (build)** |
|---|---|---|---|---|---|
| 1 | 1 series L | L | 4.06 nH | 3.9 nH | **3.3 nH** |
| 2 | 2 shunt LCs | L | 1.02 nH | 1.1 nH | **1.1 nH** |
| 3 | 2 shunt LCs | C | 1.36 pF | 1.4 pF | **1.4 pF** |
| 4 | 3 series L | L | 5.13 nH | 5.1 nH | **4.7 nH** |
| 5 | 4 shunt LCs | L | 4.35 nH | 4.7 nH | **3.9 nH** |
| 6 | 4 shunt LCs | C | 0.83 pF | 0.8 pF | **0.9 pF** |
| 7 | 5 series L | L | 4.34 nH | 4.7 nH | **4.7 nH** |
| 8 | 6 shunt LCs | L | 3.28 nH | 3.3 nH | **3.3 nH** |
| 9 | 6 shunt LCs | C | 0.91 pF | 0.9 pF | **0.9 pF** |
| 10 | 7 series L | L | 3.03 nH | 3.6 nH | **3.3 nH** |

Unique values (JLC part types): snapped 9, palette-reduced **6**.

| Metric | Continuous | Snapped | Reduced | Reduced, MC 1000 (5th pct worst) |
|---|---|---|---|---|
| IL max 1.00-2.15 GHz (spec <= 1.0) | 3.88 | 5.73 | 4.12 | 6.94 |
| RL min 1.00-2.15 GHz (spec >= 15.0) | 13.75 | 9.14 | 13.92 | 7.15 |
| Rej min 2.40-2.48 GHz (spec >= 48) | 44.27 | 45.49 | 42.46 | 33.19 |
| Rej min 2.70-3.15 GHz (spec >= 48) | 47.29 | 50.37 | 49.88 | 46.76 |
| Rej min 3.15-4.60 GHz (spec >= 43) | 41.80 | 41.39 | 39.96 | 38.92 |
| Rej min 4.60-7.00 GHz (spec >= 33) | 41.02 | 40.83 | 39.31 | 38.38 |
