kpezeshki/esp32-s31-sdr/docs/report/index.html

# ESP32-S31 SDR: two-board design report

Receive-only SDR: wideband front end, RFFC5072 mixer, 2.44 GHz IF into the ESP32-S31 raw I/Q stream over gigabit Ethernet. Status 2026-11-11: both boards placed, routed and DRC-clean to JLC basic 4-layer rules, with fab outputs generated. Not ordered, because of stock.

Noise figure, low band

1.4–2.1 dB

50–1750 MHz

Noise figure, mid band

2.5–3.1 dB

1750–2150 MHz

Noise figure, high band

2.2–3.0 dB

3.1–6 GHz

Instantaneous DR

≈44 dB

40 MHz, 8-bit ADC limited

Cost per system @5

$87.35

A $17.08 + B $63.27 + ship

Cost per system @10

$67.65

A $14.50 + B $49.65 + ship

## Architecture

Board B (RF): SMA ─ ESD ─ SP3T ─┬─ LB: PSA4-5043+ ─ LPF 1.75 GHz ─┐ ├─ MB: PSA4-5043+ ─ BPF 1.75–2.15 ─┤─ SP3T ─ GVA-62+ ─ balun ─ RFFC5072 ─ 2.44 GHz SAW ─ 3 dB pad ─ U.FL └─ HB: HPF ─ QPL9503 ─ HPF 3.1 GHz ┘ (40 MHz TCXO ref; LO 290 MHz–4.2 GHz) Board A (base): U.FL ─ ESP32-S31-WROOM-1U (raw I/Q, 40 MS/s) ─ RGMII ─ YT8531 ─ RJ45 (GbE); USB-C power; 2×10 header → Board B control + 5 V

Tuning: LB 50–1750 MHz (LO = IF+RF), MB 1750–2150 MHz (LO = IF−RF), HB 3.1–6 GHz (LO = RF−IF), plus native ESP32 2.15–2.8 GHz on Board A alone (antenna on the module's U.FL). There is a gap at 2.8–3.1 GHz. The IF is 61 × 40 MHz, which parks the reference harmonic on the DC spike.

## Boards

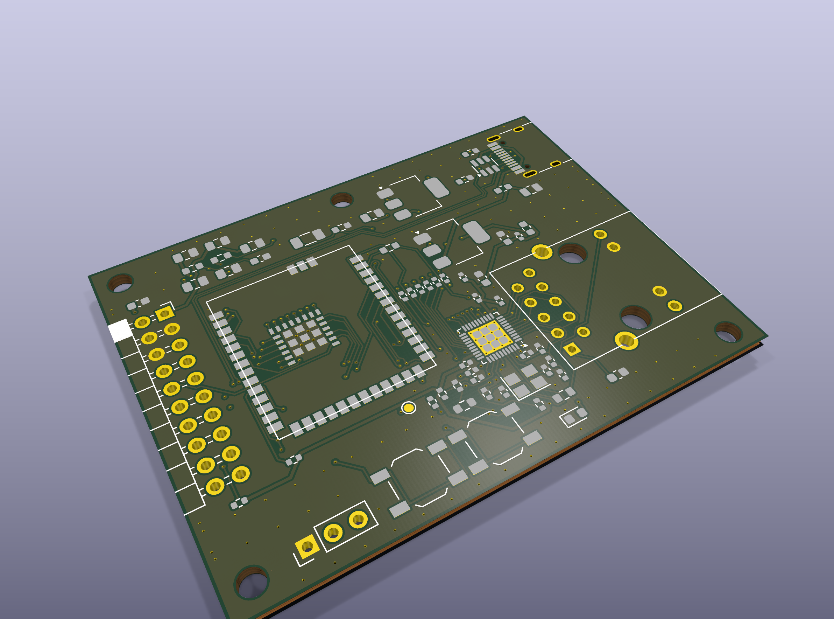
[picture p1: docs/report/img/a_render_iso.png]
Board A 3D render


Board A, base board, 62×46 mm. WROOM-1U (left), YT8531 PHY + magjack (right), USB-C (top right), 2×10 socket to Board B (left edge). 67 parts, all assembled in house (stencil + hotplate for module/PHY). The 3D models aren't installed, so parts show as pads.

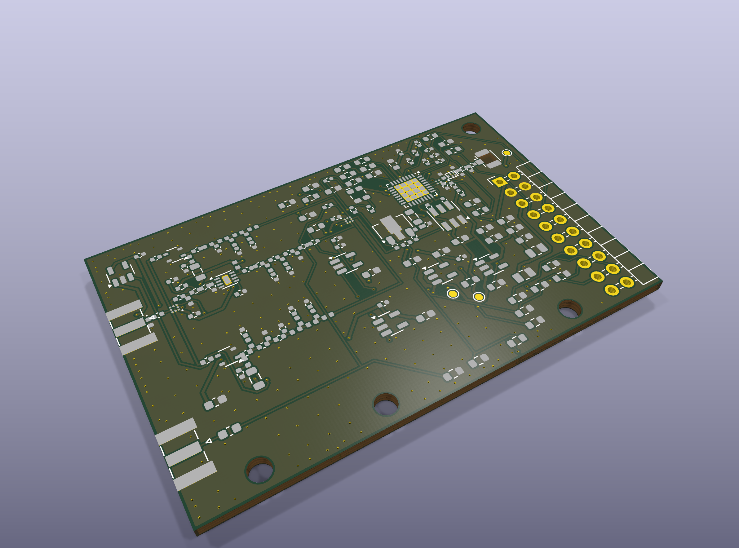
[picture p2: docs/report/img/b_render_iso.png]
Board B 3D render


Board B, RF front end, 62×40 mm. RF input SMA (left), three band chains + filters (centre/left), RFFC5072 mixer (top right), IF U.FL (right), header to Board A (right edge). 160 parts, 95 placed by JLC.

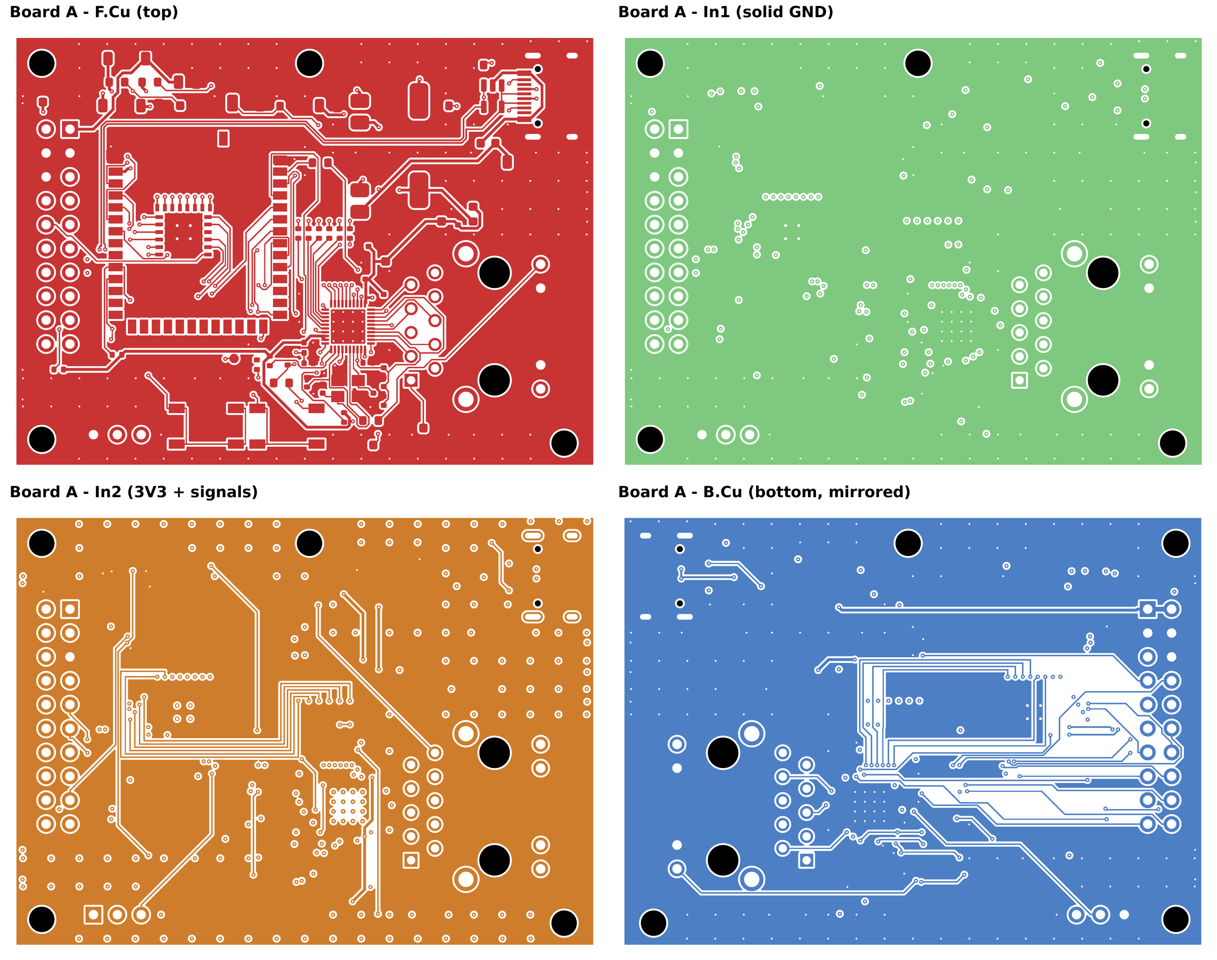
[picture p3: docs/report/img/a_copper_all.png]
Board A copper layers


Board A copper. In1 is solid GND with no routing. RGMII is scripted: TX lanes on B.Cu, RX lanes on In2 (3V3 pour). 127 GND stitching vias.

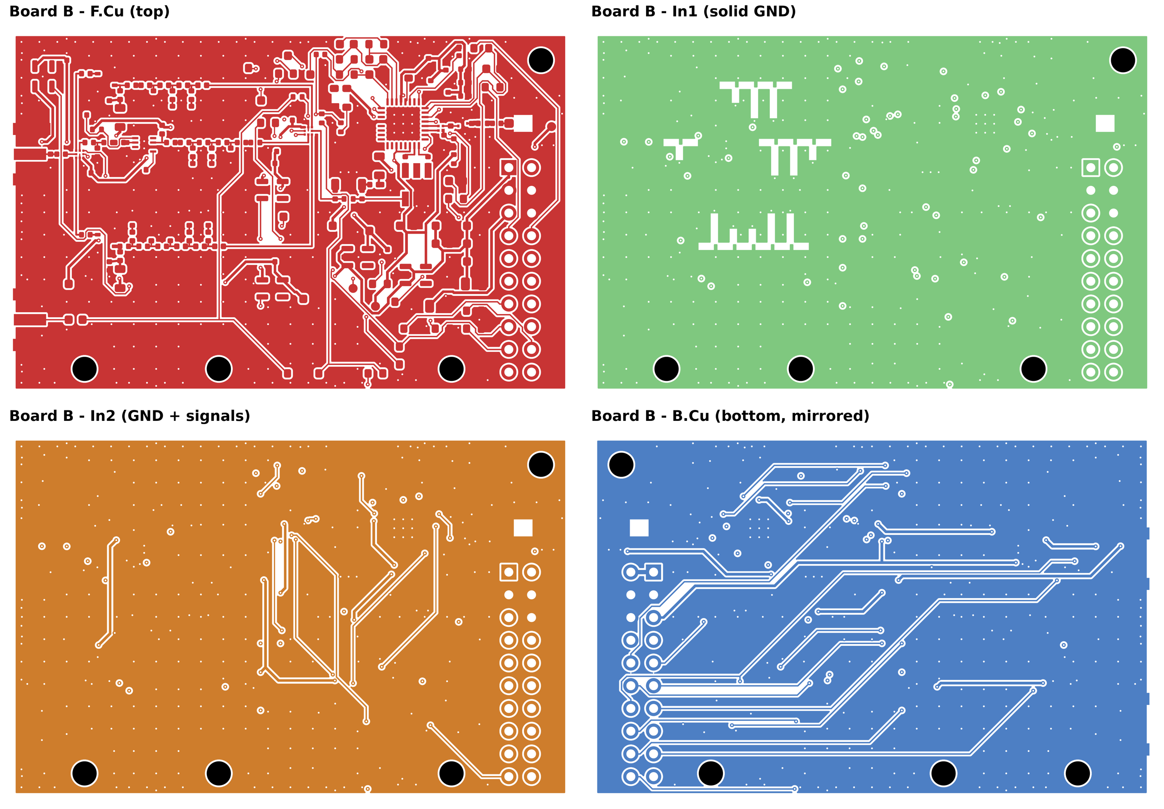
[picture p4: docs/report/img/b_copper_all.png]
Board B copper layers


Board B copper. The RF chain is on F.Cu over solid In1 GND. The white combs on In1 are the EM-designed voids under the filter 0402 pads. 234 stitching vias plus a 2 mm edge fence.

Top / bottom renders

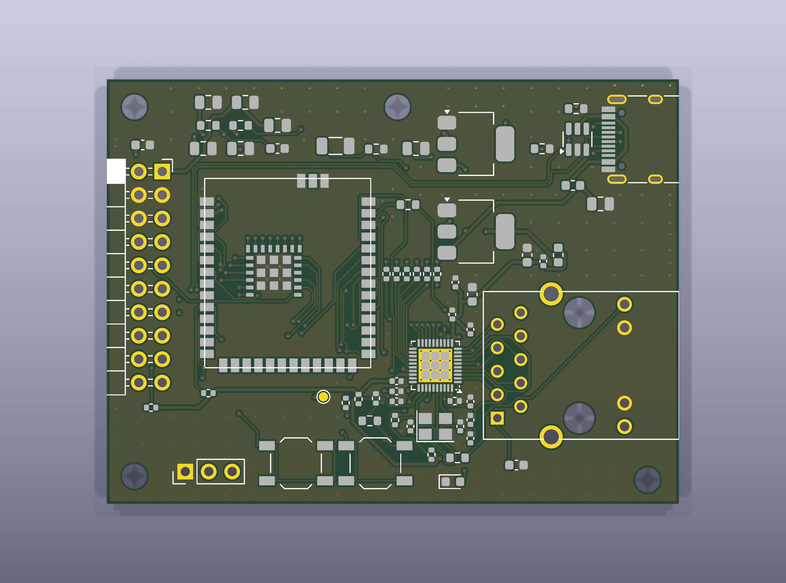
[picture p5: docs/report/img/a_render_top.png]


Board A top

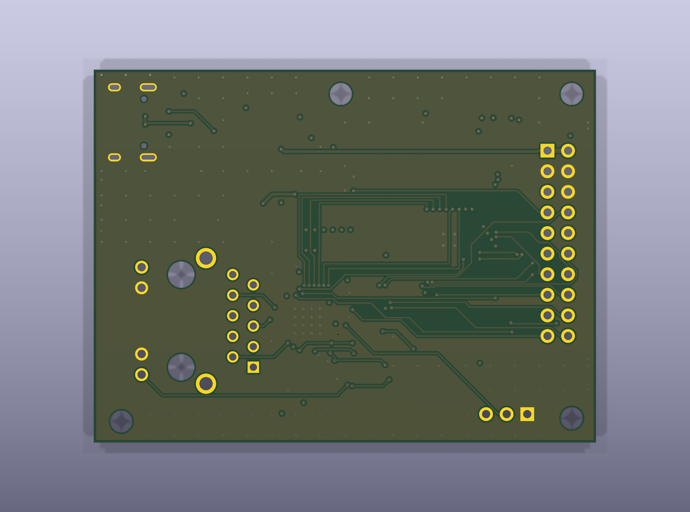
[picture p6: docs/report/img/a_render_bottom.png]


Board A bottom

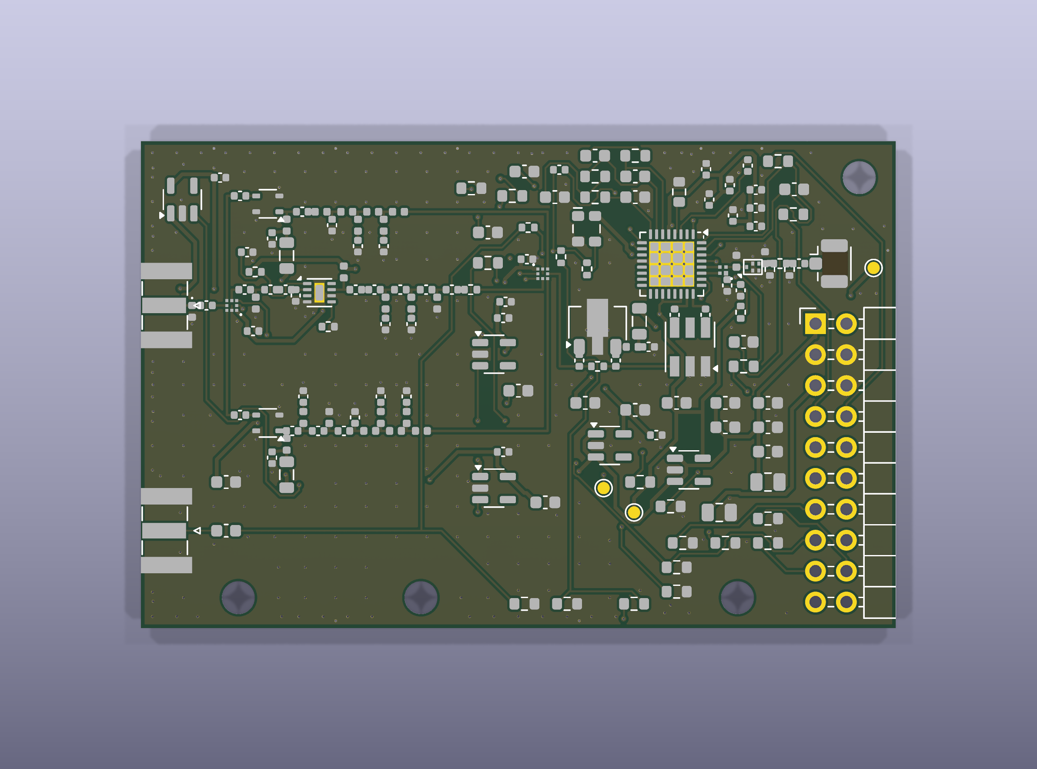
[picture p7: docs/report/img/b_render_top.png]


Board B top

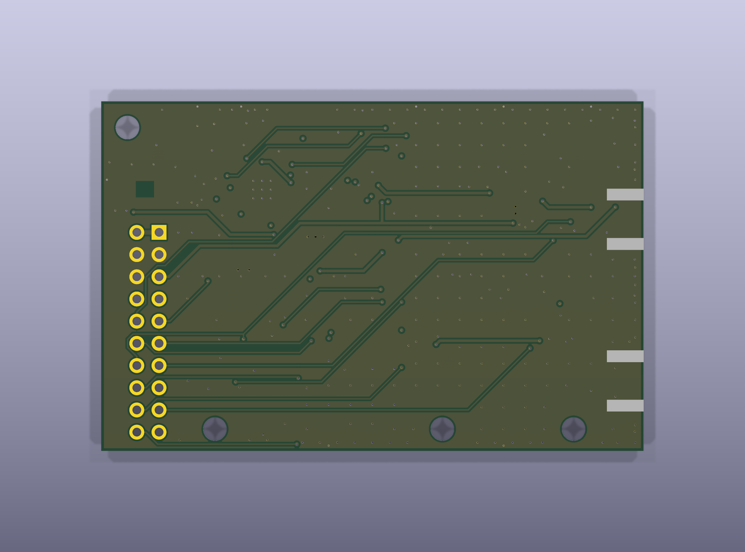
[picture p8: docs/report/img/b_render_bottom.png]


Board B bottom

## Simulated RF performance

### Band filtering

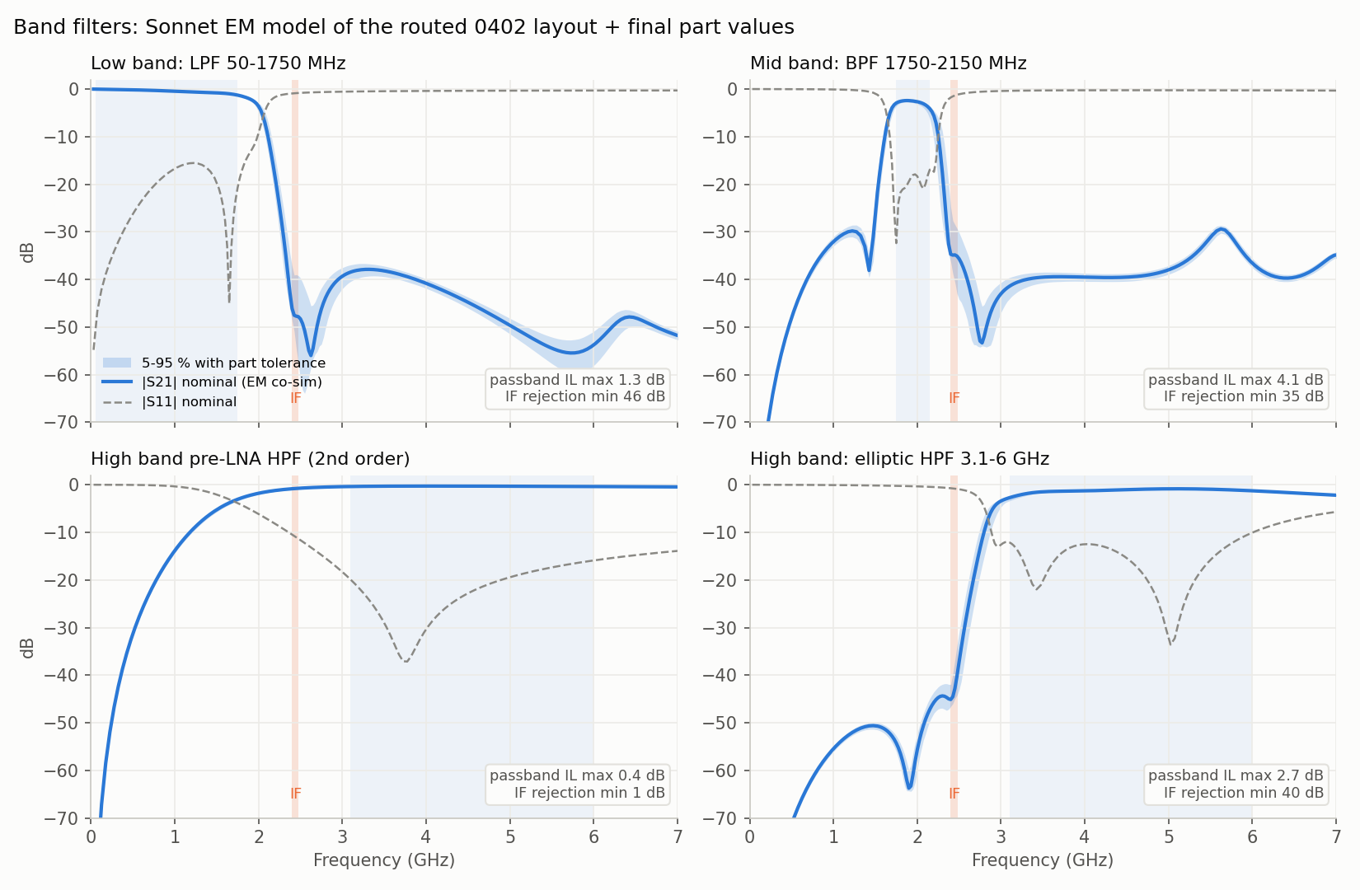
[picture p9: docs/report/img/rf_filters.png]
Filter responses


Sonnet EM model of the as-routed 0402 filter layouts (pads, lines, In1 voids, vias), co-simulated with the final part values and part parasitic models. The shaded band is the 5–95 % spread over 300 Monte-Carlo draws (C ±0.05 pF W-grade, L ±0.1 nH B-grade). The orange stripe is the 2.40–2.48 GHz IF, which every mixer band must reject to stop direct IF feed-through. The 2nd-order HB pre-filter only protects the HB LNA from strong low-band signals; the elliptic HB HPF provides the IF rejection.

Filter | Passband IL max (dB) | IF rejection min (dB)
LB_LPF | 1.3 | 46
MB_BPF2 | 4.1 | 35
HB_PRE | 0.4 | 1
HB_HPF | 2.7 | 40

### Noise figure and gain

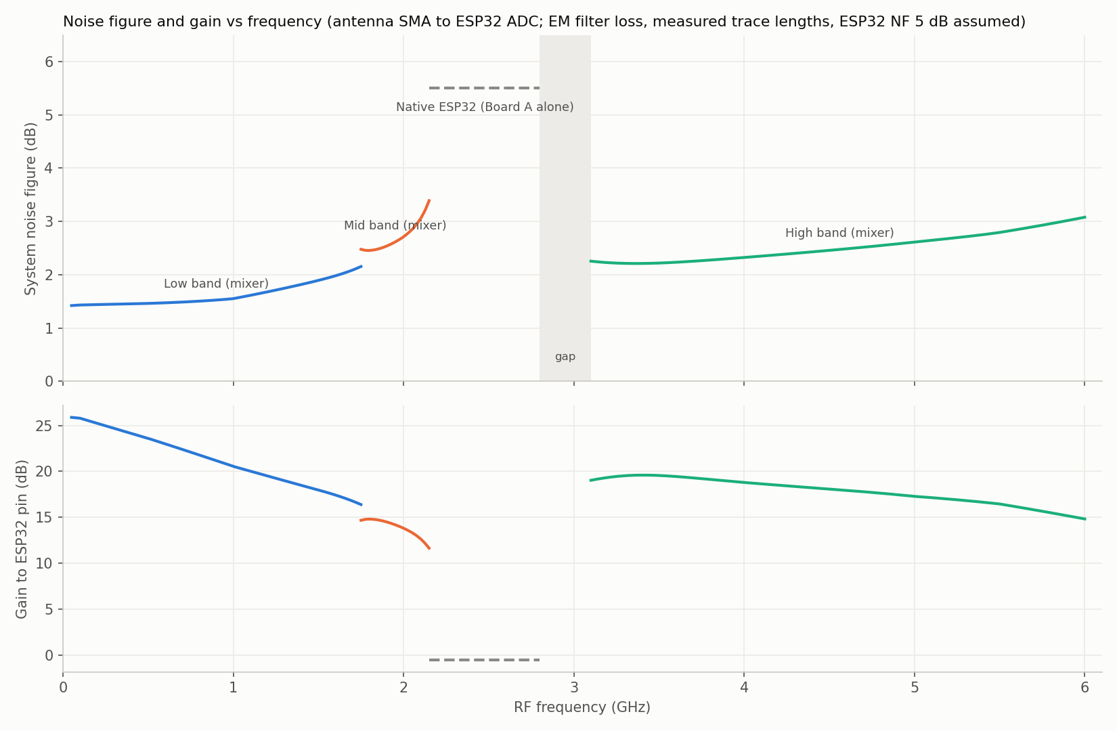
[picture p10: docs/report/img/rf_nf_gain.png]
NF and gain


Cascade from the antenna SMA to the ESP32 ADC. Stage models are datasheet values (SP3T BGS13SN8, PSA4-5043+, QPL9503, GVA-62+, H3-TCM2-63WX+, RFFC5072, SAW). Filter loss comes from the EM co-simulation above. Trace loss uses the measured RF trace lengths on Board B times Sonnet's line loss (0.028 dB/mm at 6 GHz). The IF tail is the 3 dB pad and the U.FL cable. ESP32-S31 NF is assumed to be 5 dB; it isn't published. Pre-LNA trace adds only ~0.15–0.2 dB.

### Dynamic range

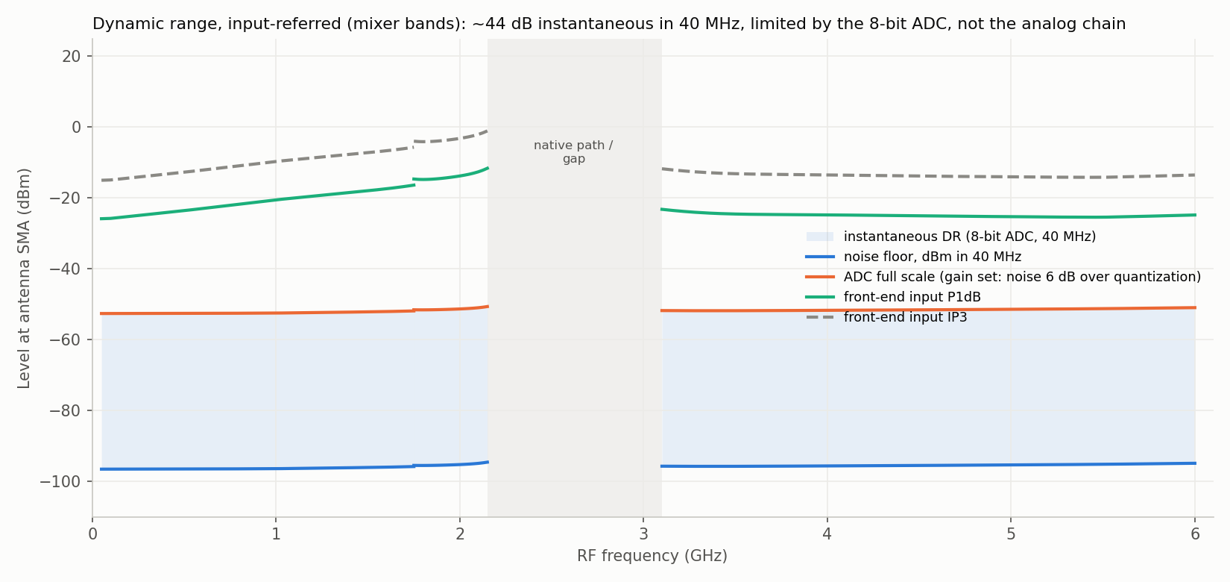
[picture p11: docs/report/img/rf_dynamic_range.png]
Dynamic range


Input-referred levels. With the ESP32 gain set so that analog noise sits 6 dB above the 8-bit quantization floor, full scale is ≈ −52 dBm at the antenna and the instantaneous dynamic range is ≈44 dB in 40 MHz. Narrowband signals gain processing gain on top of that, e.g. +46 dB in 1 kHz. The analog chain compresses ~27 dB above ADC full scale, so lowering the ESP32 gain index trades sensitivity for strong-signal headroom without analog compression. The ESP32's AGC does not protect the ADC, so gain must be set manually.

Point | NF (dB) | Gain (dB) | Noise (dBm/40 MHz) | ADC FS @ant (dBm) | P1dB in (dBm) | IIP3 (dBm)
LB 100 MHz | 1.4 | +25.8 | -96.5 | -52.6 | -25.8 | -14.9
LB 433 MHz | 1.5 | +24.0 | -96.5 | -52.6 | -24.0 | -13.1
LB 1090 MHz | 1.6 | +20.1 | -96.4 | -52.5 | -20.1 | -9.3
LB 1700 MHz | 2.1 | +16.8 | -95.9 | -52.0 | -16.8 | -6.1
MB 1900 MHz | 2.5 | +14.5 | -95.4 | -51.5 | -14.5 | -3.9
MB 2100 MHz | 3.1 | +12.7 | -94.9 | -51.0 | -12.7 | -2.1
NAT 2440 MHz | 5.5 | -0.5 | -92.5 | -48.6 | — | —
HB 3500 MHz | 2.2 | +19.6 | -95.8 | -51.8 | -24.6 | -13.2
HB 5000 MHz | 2.6 | +17.3 | -95.4 | -51.4 | -25.3 | -14.0
HB 5800 MHz | 3.0 | +15.5 | -95.0 | -51.1 | -25.1 | -13.8

Known RF limitations (from the frequency-plan analysis):

- In the HB, 1×3 / 1×5 mixer spurs fall in-band at 15–22 dBc for tuning around 3.5–4.1 GHz and 4.5–5.26 GHz. Software should flag those ranges.
- The MB BPF costs up to 4.1 dB, so the MB is the noisiest mixer band.
- Rates below 40 MS/s decimate without filtering in the current esp-sdr firmware (aliasing).

## Cost per board

Per board | qty 5 | qty 10
A: components (incl. module est.) | $12.48 | $11.70
A: PCB share | $3.00 | $2.00
A: stencil share | $1.60 | $0.80
Board A total | $17.08 | $14.50
B: JLC-placed components | $34.83 | $32.56
B: hand-solder kit | $2.64 | $2.55
B: PCB share | $3.00 | $2.00
B: JLC PCBA fees share | $22.80 | $12.54
Board B total | $63.27 | $49.65
Shipping share (JLC + LCSC) | $7.00 | $3.50
System (A + B) | $87.35 | $67.65

### Largest line items (B)

Ref | Part | $/board | LCSC stock
U3 | RFFC5072 | $14.61 | 66
U23 | QPL9503 | $5.75 | 760
U21,U22 | PSA4-5043+ | $3.82 | 2,755
T1 | H3-TCM2-63WX+ | $3.13 | 1,084
U25 | GVA-62+ | $2.88 | 206
U10,U11,U12,U9 | TPS7A2045PDBVR | $0.93 | 7,264
T2 | BD2425N50200AHF | $0.89 | 25
U20,U24 | BGS13SN8 | $0.60 | 790

### Largest line items (A)

Ref | Part | $/board | LCSC stock
U1 | ESP32-S31-WROOM-1U-N16R16V | $6.00
J201 | RJ45 1000BASE-T magjack, integrated magn | $2.86 | 7,747
U201 | YT8531DC-CA | $1.49 | 3,406
J6 | To RF board | $0.51 | 1,068
C101,C401,C601,C603 | 22uF | $0.42 | 3,790,862
U6,U7 | AMS1117-3.3 | $0.39 | 1,510,584

Prices: JLC/LCSC parts API by LCSC number on 2026-11-11, bought at max(need, first price break). JLC Standard PCBA fees for B: $25.56 setup, $8.21 stencil, $1.53 × 45 part types, X-ray billed per board, per-joint charge. Assumptions: PCB $15 per design per order (5 pcs) or $20 (10 pcs), not yet a live quote; Board A stencil $8; shipping $35 per order; WROOM-1U $6 estimate (not on LCSC, 0 stock). Board B's RFFC5072 alone is $14.61, about 23 % of the board.

### Bill of materials

Board A: in-house kit (31 lines)

Designators | Value / part | LCSC | Qty | Unit @5 | $/board @5 | Note
U1 | ESP32-S31-WROOM-1U-N16R16V | | 1 | $6.00 | $6.00 | estimate (not on LCSC)
C101, C401, C601, C603 | 22uF | C45783 | 4 | $0.11 | $0.42 | basic, stock 3,790,862
C102 | 100nF | C14663 | 1 | $0.01 | $0.01 | basic, stock 35,897,006
C103, C602, C604 | 10uF | C15850 | 3 | $0.03 | $0.09 | basic, stock 8,323,277
R101, R102 | 10k | C25804 | 2 | $0.00 | $0.00 | basic, stock 44,309,927
C104 | 1uF | C15849 | 1 | $0.01 | $0.01 | basic, stock 12,254,842
SW1 | RESET | C318884 | 1 | $0.02 | $0.02 | basic, stock 840,073
SW2 | BOOT | C318884 | 1 | $0.02 | $0.02 | basic, stock 840,073
J5 | UART | C49257 | 1 | $0.03 | $0.03 | extended, stock 255,094
R103 | 1k | C21190 | 1 | $0.00 | $0.00 | basic, stock 26,364,899
D101 | LED | C72043 | 1 | $0.02 | $0.02 | extended, stock 0
TP1 | GPIO60 | | 1
J4 | USB-C | C165948 | 1 | $0.19 | $0.19 | extended, stock 274,363
R401, R402 | 5.1k | C23186 | 2 | $0.00 | $0.00 | basic, stock 19,852,596
U5 | USBLC6-2SC6 | C7519 | 1 | $0.16 | $0.16 | extended, stock 27,239
FB401 | 120R@100MHz | C1015 | 1 | $0.03 | $0.03 | basic, stock 2,325,337
U6, U7 | AMS1117-3.3 | C6186 | 2 | $0.19 | $0.39 | basic, stock 1,510,584
J6 | To RF board | C239361 | 1 | $0.51 | $0.51 | extended, stock 1,068
U201 | YT8531DC-CA | C47544379 | 1 | $1.49 | $1.49 | extended, stock 3,406
Y201 | 25 MHz, CL 12 pF, +/-10 ppm | C9006 | 1 | $0.10 | $0.10 | basic, stock 372,929
C201, C202 | 15 pF 50V C0G | C1548 | 2 | $0.00 | $0.01 | basic, stock 1,114,632
R201 | 2.49k 1% | C25884 | 1 | $0.00 | $0.00 | extended, stock 877,110
C203, C204, C205, C206, C207, C209, C211, C212, C213, C214 | 100 nF 16V | C1525 | 10 | $0.00 | $0.03 | basic, stock 31,644,411
C208, C210 | 10 uF 10V | C19702 | 2 | $0.02 | $0.05 | basic, stock 9,574,828
FB201 | 120 ohm @100 MHz, 2 A | C14709 | 1 | $0.01 | $0.01 | basic, stock 1,816,063
R208, R209, R210, R211, R212, R213 | 33R 1% | C25105 | 6 | $0.00 | $0.01 | basic, stock 3,568,008
R214, R215, R216, R217, R218, R219 | 4.7k 1% | C25900 | 6 | $0.00 | $0.01 | basic, stock 15,123,035
R220, R221 | 330R 1% | C23138 | 2 | $0.00 | $0.00 | basic, stock 2,555,520
C215 | 100 nF 50V | C14663 | 1 | $0.01 | $0.01 | basic, stock 35,897,006
J201 | RJ45 1000BASE-T magjack, integrated magnetics + Bob Smith, G/Y LEDs | C50933 | 1 | $2.86 | $2.86 | extended, stock 7,747
R222 | 0R | C21189 | 1 | $0.00 | $0.00 | basic, stock 18,195,368
Total parts per board (qty 5 build, MOQ-rounded) | | | | | $12.48

Board B: JLC-placed (45 part types)

Designators | Value / part | LCSC | Qty | Unit @5 | $/board @5 | Note
Y1 | TG2520SMN 40MHz | C3007519 | 1 | $0.43 | $0.43 | extended, stock 5,288
C302, C312, C332, C360, C363, C373, C375, C377, C384, C391, C701 | 100nF | C1525 | 11 | $0.00 | $0.03 | basic, stock 31,644,411
R352, R390, R701 | 0 | C17168 | 3 | $0.00 | $0.00 | basic, stock 16,196,988
D301 | KLXES15AAA1 | C2892490 | 1 | $0.02 | $0.02 | extended, stock 74,090
C301, C310, C313, C330, C361, C364, C370, C371 | 1nF | C1523 | 8 | $0.00 | $0.03 | basic, stock 1,987,090
U20, U24 | BGS13SN8 | C3312946 | 2 | $0.30 | $0.60 | extended, stock 790
U21, U22 | PSA4-5043+ | C5240848 | 2 | $1.91 | $3.82 | extended, stock 2,755
L310, L330 | 33nH | C113114 | 2 | $0.04 | $0.09 | extended, stock 61,836
C311, C331, C352, C353, C362, C390 | 100pF | C1546 | 6 | $0.00 | $0.01 | basic, stock 3,516,470
FLB1, FLB4, FMB11, FMB8, L390, L391 | 3.9nH | C98062 | 6 | $0.06 | $0.37 | extended, stock 23,412
FHB1, FHP1, FLB2 | 2.4pF | C88889 | 3 | $0.04 | $0.12 | extended, stock 7,656
FLB3 | 4.7nH | C98064 | 1 | $0.07 | $0.07 | extended, stock 27,856
FLB5, FLB8, FMB3 | 1.1pF | C88879 | 3 | $0.05 | $0.15 | extended, stock 1,314
FLB6, FMB12, FMB14 | 3.3nH | C98061 | 3 | $0.06 | $0.19 | extended, stock 1,453
FLB7 | 2.7nH | C91239 | 1 | $0.04 | $0.04 | extended, stock 35,187
FLB9 | 1nH | C162538 | 1 | $0.03 | $0.03 | extended, stock 9,328
FHP3, FMB1, FMB7 | 1.8pF | C76903 | 3 | $0.08 | $0.24 | extended, stock 16,516
FMB2 | 10nH | C90642 | 1 | $0.05 | $0.05 | extended, stock 88,834
FMB10, FMB4 | 0.5pF | C76912 | 2 | $0.04 | $0.07 | extended, stock 127,537
FMB5 | 5.1nH | C113117 | 1 | $0.04 | $0.04 | extended, stock 8,497
FHB7, FMB13, FMB6 | 0.8pF | C88902 | 3 | $0.04 | $0.12 | extended, stock 212,563
FMB9 | 6.8nH | C82919 | 1 | $0.07 | $0.07 | extended, stock 15,080
FHB2, FHP2 | 2nH | C2986275 | 2 | $0.02 | $0.05 | extended, stock 44,358
C350 | 10pF | C85873 | 1 | $0.04 | $0.04 | extended, stock 11,827
U23 | QPL9503 | C470924 | 1 | $5.75 | $5.75 | extended, stock 760
R350 | 4.7k | C25900 | 1 | $0.00 | $0.00 | basic, stock 15,123,035
L350 | 18nH | C91622 | 1 | $0.05 | $0.05 | extended, stock 45,404
C354 | 1uF | C52923 | 1 | $0.01 | $0.01 | basic, stock 10,790,841
R351 | 22k | C25768 | 1 | $0.00 | $0.00 | basic, stock 926,605
C355 | 5.6pF | C161329 | 1 | $0.13 | $0.13 | extended, stock 55,500
FHB3 | 3pF | C88891 | 1 | $0.02 | $0.02 | extended, stock 208,400
FHB4, FHB9 | 1pF | C72134 | 2 | $0.05 | $0.09 | extended, stock 8,267
FHB5 | 1.5nH | C18221 | 1 | $0.05 | $0.05 | extended, stock 3,564
FHB6 | 4.7pF | C161327 | 1 | $0.02 | $0.02 | extended, stock 71,568
FHB8 | 1.3nH | C91238 | 1 | $0.07 | $0.07 | extended, stock 20,203
U25 | GVA-62+ | C5445184 | 1 | $2.88 | $2.88 | extended, stock 206
L360 | 22nH | C86129 | 1 | $0.05 | $0.05 | extended, stock 36,463
T1 | H3-TCM2-63WX+ | C22383437 | 1 | $3.13 | $3.13 | extended, stock 1,084
U3 | RFFC5072 | C3034742 | 1 | $14.61 | $14.61 | extended, stock 66
C372, C374, C376, C378, C392 | 33pF | C426031 | 5 | $0.02 | $0.08 | extended, stock 21,938
T2 | BD2425N50200AHF | C502748 | 1 | $0.89 | $0.89 | extended, stock 25
U4 | SAFEA2G45MC0F0AR00 | C910550 | 1 | $0.27 | $0.27 | extended, stock 9,378
R393, R395 | 300 | C25102 | 2 | $0.00 | $0.00 | extended, stock 577,032
R394 | 18 | C25113 | 1 | $0.00 | $0.00 | extended, stock 17,528
J8 | U.FL IF out | C5137195 | 1 | $0.04 | $0.04 | extended, stock 759,049
Total parts per board (qty 5 build, MOQ-rounded) | | | | | $34.83

Board B: hand-solder kit (22 lines, 0603+ / SOT / connectors)

Designators | Value / part | LCSC | Qty | Unit @5 | $/board @5 | Note
U10, U11, U12, U9 | TPS7A2045PDBVR | C2873627 | 4 | $0.23 | $0.93 | extended, stock 7,264
C605, C607, C609, C611, C613 | 1uF | C15849 | 5 | $0.01 | $0.06 | basic, stock 12,254,842
C606, C608, C610, C612, C614 | 4.7uF | C19666 | 5 | $0.01 | $0.07 | basic, stock 3,686,320
R601, R602, R603, R610, R611, R612, R613 | 100k | C25803 | 7 | $0.00 | $0.02 | basic, stock 15,423,423
U8 | TPS7A2030PDBVR | C963429 | 1 | $0.24 | $0.24 | extended, stock 17,203
C615 | 22uF | C45783 | 1 | $0.11 | $0.11 | basic, stock 3,790,862
C616 | 10uF | C15850 | 1 | $0.03 | $0.03 | basic, stock 8,323,277
J7 | To base board | C492438 | 1 | $0.18 | $0.18 | extended, stock 41,820
J1 | SMA_MIX | C496550 | 1 | $0.41 | $0.41 | extended, stock 92,770
L311, L331, L361 | 1uH | C440216 | 3 | $0.17 | $0.51 | extended, stock 2,997
R370 | 51k | C23196 | 1 | $0.00 | $0.00 | basic, stock 2,249,253
C380 | 8.2pF | C1685 | 1 | $0.00 | $0.00 | extended, stock 74,159
R380 | 22k | C31850 | 1 | $0.00 | $0.00 | basic, stock 2,571,810
C381 | 180pF | C124184 | 1 | $0.01 | $0.01 | extended, stock 24,227
R381, R382 | 470 | C23179 | 2 | $0.00 | $0.00 | basic, stock 3,792,925
C382, C383 | 330pF | C190577 | 2 | $0.01 | $0.01 | extended, stock 55,267
R383, R384, R385, R386, R387 | 1k | C21190 | 5 | $0.00 | $0.01 | basic, stock 26,364,899
C385, C386, C387, C388, C389 | 33pF | C91368 | 5 | $0.01 | $0.03 | extended, stock 206,901
R388, R389 | 4.7k | C23162 | 2 | $0.00 | $0.01 | basic, stock 15,078,325
TP1 | RFFC_LD | | 1
TP2 | 3V0_RF | | 1
TP3 | VGB | | 1
Total parts per board (qty 5 build, MOQ-rounded) | | | | | $2.64

## Layout and process

- Process (D22): JLC basic 4-layer, JLC04161H-3313 stack, no surcharge items. 0.45/0.2 mm vias, 0.1/0.1 mm track/space, 0.2 mm hole and edge clearance. Verified on the final boards: 0 tracks on In1, no via outside the no-surcharge range.
- RF lines: 0.19 mm microstrip over In1 GND (0.1 mm prepreg) = 50.8 Ω (Sonnet), ≈ ±10 % with JLC tolerance. The RF copper is locked exactly as in the EM model.
- DRC (KiCad, JLC rules): 0 unconnected / shorts / clearance / hole-clearance on both boards. Accepted flags:
  - edge-launch SMA copper at the board edge;
  - courtyard overlaps in the RF ladders at the EM-model spacing;
  - silk.
- Board A:
  - RGMII module-to-PHY lanes are scripted: intra-group skew ≈ 50 ps, far inside RGMII-ID tolerance.
  - The USB 2.0 HS pair is a scripted coupled pair (≈90 Ω) along the board's top edge over solid In1 GND, with DM/DP matched to 0.9 mm.
  - TX 33 Ω resistors were dropped (D21): the reference places them at the MAC, which is impossible under the module.
  - PHY decoupling sits at the pins.
- Board B:
  - The RFFC5072 loop filter is pinned next to the mixer; all LF nets are ≤13 mm on F.Cu.
  - The reference-clock option links sit at the TCXO, so there is no long stub on the 40 MHz reference.
  - Three scripted hand fixes.
- Autorouter: Freerouting, statically audited (not malicious) and run network-isolated in a memory-capped unit.

## Before ordering

1. JLC CPL/DFM preview: check part rotations, and that JLC accepts the 0402 RF ladders at the EM-model pad gaps.
2. Sourcing: WROOM-1U is not on LCSC; RFFC5072 has 66 in stock and the T2 IF balun 25 (as of 2026-11-11). Re-check stock first.
3. Get a live JLC quote with these Gerbers/BOM/CPL to replace the PCB and shipping assumptions.

Resolved since the first version of this report:

- USB HS pair: now a scripted, coupled 0.17/0.11 mm pair (≈90 Ω differential) over solid GND, with DM/DP matched to 0.9 mm (was 13.5 mm skew and 4 vias).
- USB-C pad ties: scripted.
- 40 MHz reference stub: the DNP option links now sit at the TCXO/C384, so REFCLK_RF is 13 mm in total (was 43 mm).
- PHY decoupling: three caps rotated so the supply pads face the PHY pins.

## Files

- claude_out:esp32_sdr/hw/board_a/fab/: Gerbers+drill zip, BOM_A_kit.csv, CPL_A.csv, layer PDFs
- claude_out:esp32_sdr/hw/board_b/fab/: Gerbers+drill zip, BOM_B_JLC.csv, CPL_B_JLC.csv, BOM_B_HAND_LCSC.csv, layer PDFs
- claude_out:esp32_sdr/hw/board_{a,b}/esp32sdr_{a,b}_routed.kicad_pcb: KiCad boards
- claude_out:esp32_sdr/hw/LAYOUT_STATUS_SPLIT.md, DECISIONS.md, em/EM_REPORT.md, SIGNAL_CHAIN_ANALYSIS.md
- claude_out:esp32_sdr/hw/report/: this report's generators (cost_boards.py, rf_perf.py, build_report.py)
