kpezeshki/esp32-s31-sdr/em/filters/FINAL_FILTERS.md

# Final filter values (EM-optimised, joint palette)

Unique values: 19: 0.5pF, 0.8pF, 1pF, 1.1pF, 1.8pF, 2.4pF, 3pF, 4.7pF, 1nH, 1.3nH, 1.5nH, 2nH, 2.7nH, 3.3nH, 3.9nH, 4.7nH, 5.1nH, 6.8nH, 10nH

## LB_LPF
L1=3.9, C2=2.4, L3=4.7, L4=3.9, C5=1.1, L6=3.3, L7=2.7, C8=1.1, L9=1

| Metric | EM nominal | MC median | MC 5th pct worst |
|---|---|---|---|
| IL max 0.03-1.75 GHz (<= 1.0) | 1.28 | 1.29 | 1.36 |
| RL min 0.03-1.75 GHz (>= 14.0) | 15.54 | 15.50 | 14.50 |
| Rej min 2.40-2.48 GHz (>= 42) | 46.08 | 43.18 | 38.22 |
| Rej min 2.48-4.80 GHz (>= 30) | 37.88 | 37.84 | 36.70 |
| Rej min 4.80-7.60 GHz (>= 47) | 47.86 | 47.61 | 46.11 |

## MB_BPF2
C1=1.8, L2=10, C3=1.1, C4=0.5, L5=5.1, C6=0.8, C7=1.8, L8=3.9, L9=6.8, C10=0.5, L11=3.9, L12=3.3, C13=0.8, L14=3.3

| Metric | EM nominal | MC median | MC 5th pct worst |
|---|---|---|---|
| IL max 1.75-2.15 GHz (<= 2.5) | 4.12 | 4.37 | 6.05 |
| RL min 1.75-2.15 GHz (>= 12.0) | 16.94 | 13.64 | 10.36 |
| Rej min 0.03-1.50 GHz (>= 32) | 29.80 | 29.35 | 26.83 |
| Rej min 2.40-2.48 GHz (>= 37) | 34.71 | 31.73 | 25.24 |
| Rej min 2.70-3.15 GHz (>= 42) | 40.94 | 40.84 | 39.22 |
| Rej min 3.15-4.60 GHz (>= 38) | 39.42 | 39.42 | 38.45 |
| Rej min 4.60-7.00 GHz (>= 30) | 29.39 | 29.52 | 28.73 |

## HB_HPF
C1=2.4, L2=2, C3=3, C4=1, L5=1.5, C6=4.7, C7=0.8, L8=1.3, C9=1

| Metric | EM nominal | MC median | MC 5th pct worst |
|---|---|---|---|
| IL max 3.10-6.00 GHz (<= 1.6) | 2.73 | 2.85 | 3.37 |
| RL min 3.10-6.00 GHz (>= 13.0) | 10.26 | 9.85 | 7.85 |
| Rej min 2.40-2.48 GHz (>= 47) | 40.18 | 40.04 | 33.98 |
| Rej min 0.03-1.90 GHz (>= 52) | 50.60 | 50.56 | 49.92 |

## HB_PRE
C1=2.4, L2=2, C3=1.8

| Metric | EM nominal | MC median | MC 5th pct worst |
|---|---|---|---|
| IL max 3.10-6.00 GHz (<= 0.35) | 0.37 | 0.38 | 0.41 |
| RL min 3.10-6.00 GHz (>= 15.0) | 15.97 | 15.97 | 15.30 |
| Rej min 0.03-1.00 GHz (>= 15) | 14.44 | 14.42 | 13.94 |
