kpezeshki/esp32-s31-sdr/analysis/export/auto_filter_HB_HPF.png

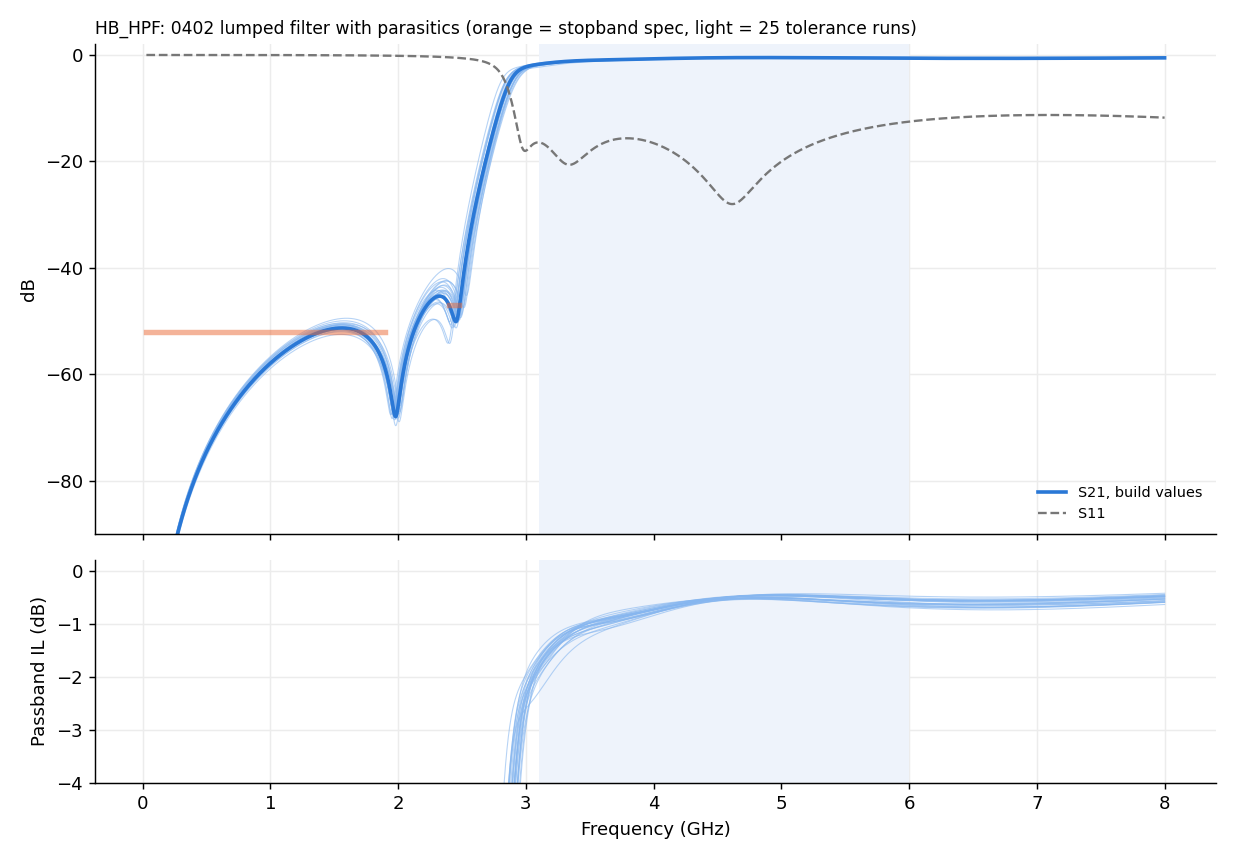
analysis/export/auto_filter_HB_HPF.png
