kpezeshki/esp32-s31-sdr/analysis/export/auto_filter_HB_PRE.png

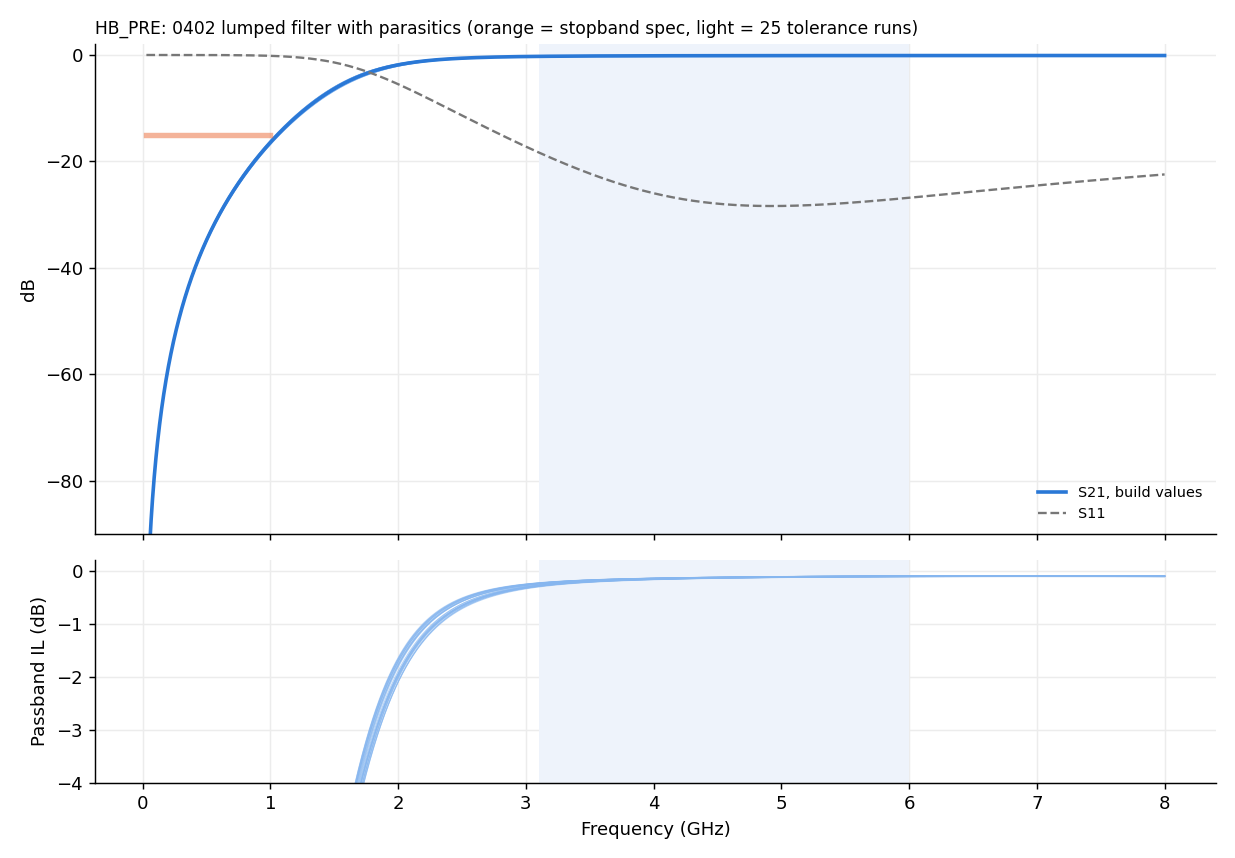
analysis/export/auto_filter_HB_PRE.png
