kpezeshki/esp32-s31-sdr/analysis/export/auto_filter_LB_LPF_s1.png

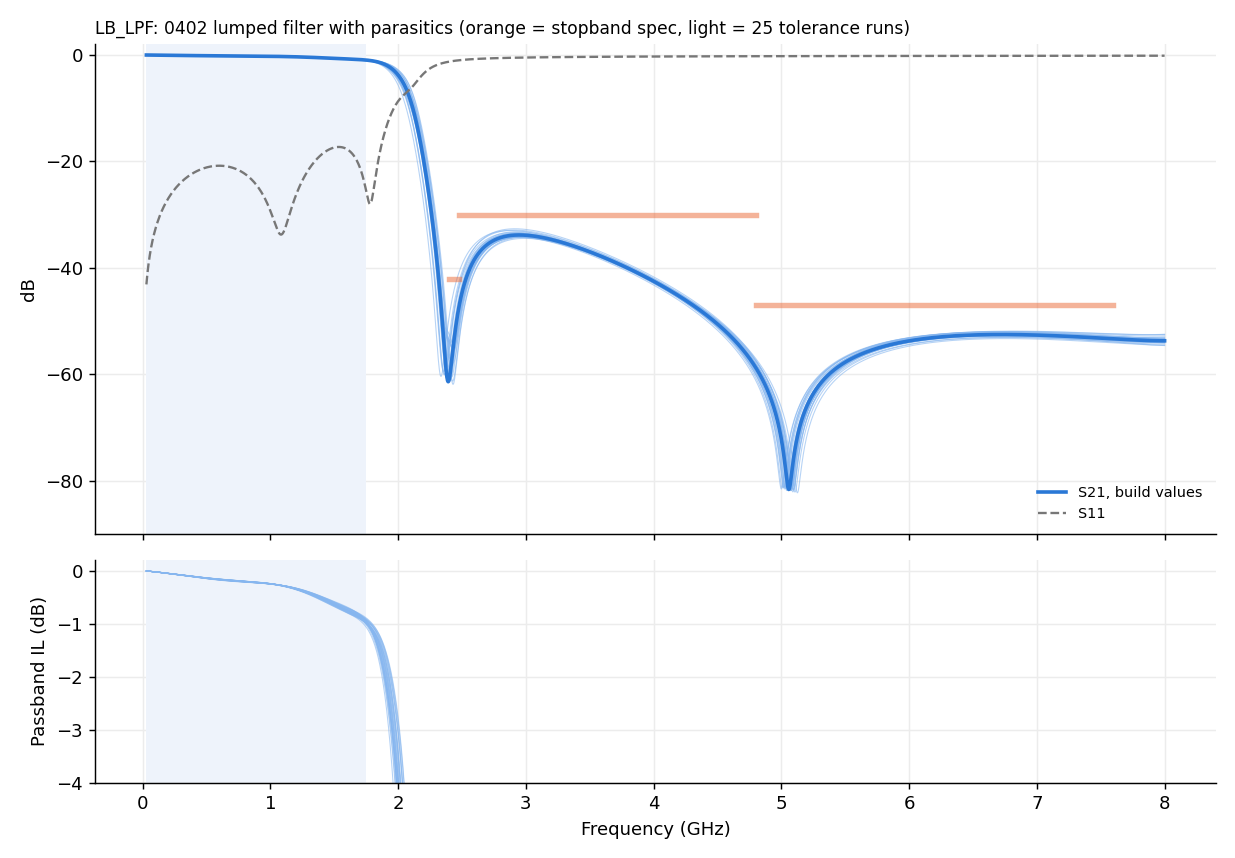
analysis/export/auto_filter_LB_LPF_s1.png
