kpezeshki/esp32-s31-sdr/analysis/export/auto_filter_MB_BPF2_s1.png

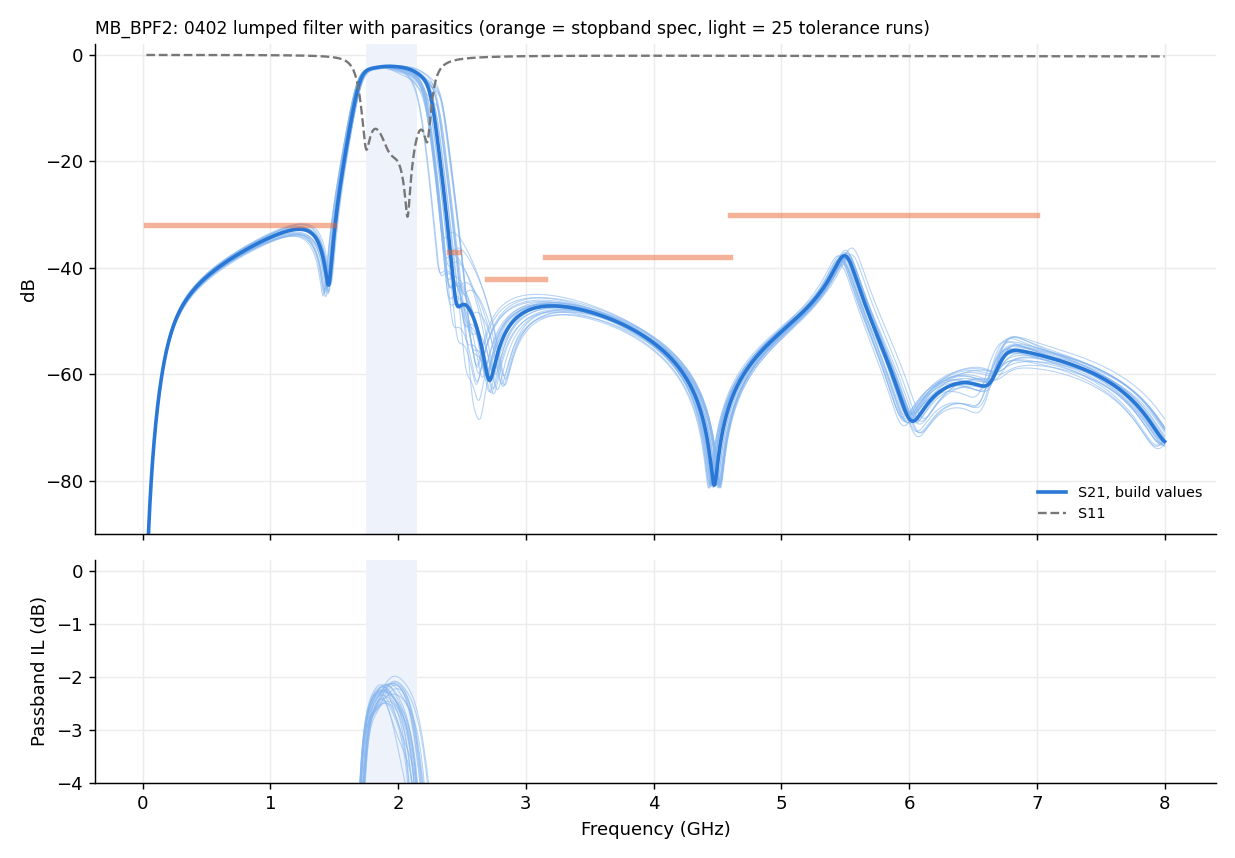
analysis/export/auto_filter_MB_BPF2_s1.png
