kpezeshki/esp32-s31-sdr/analysis/export/auto_filter_MB_HP.png

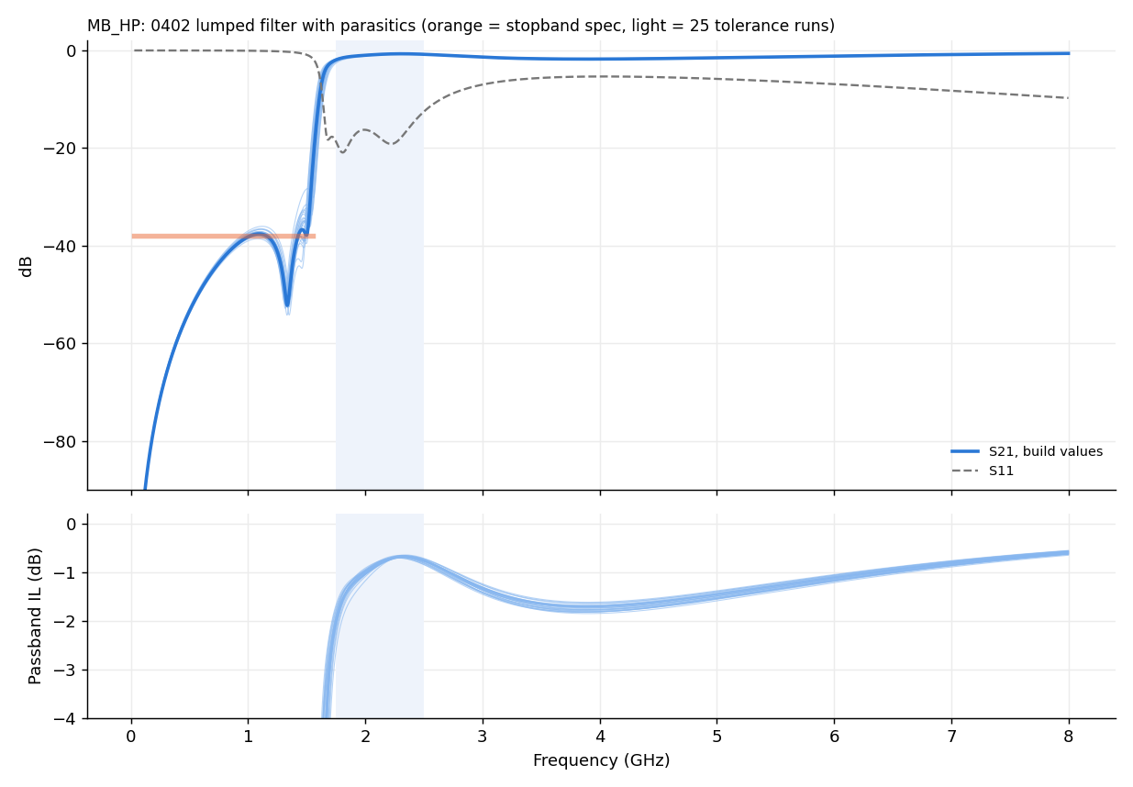
analysis/export/auto_filter_MB_HP.png
