kpezeshki/esp32-s31-sdr/analysis/export/auto_filter_MB_LP.png

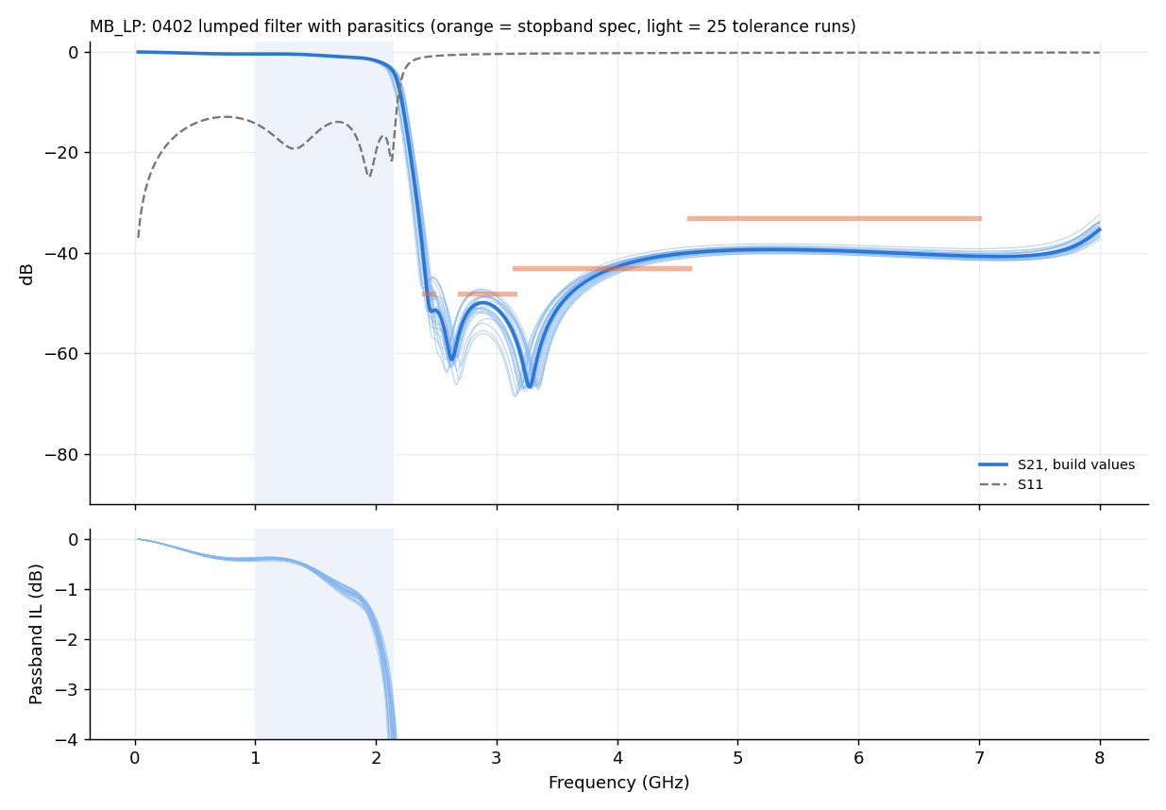
analysis/export/auto_filter_MB_LP.png
