kpezeshki/esp32-s31-sdr/analysis/export/auto_freqplan.png

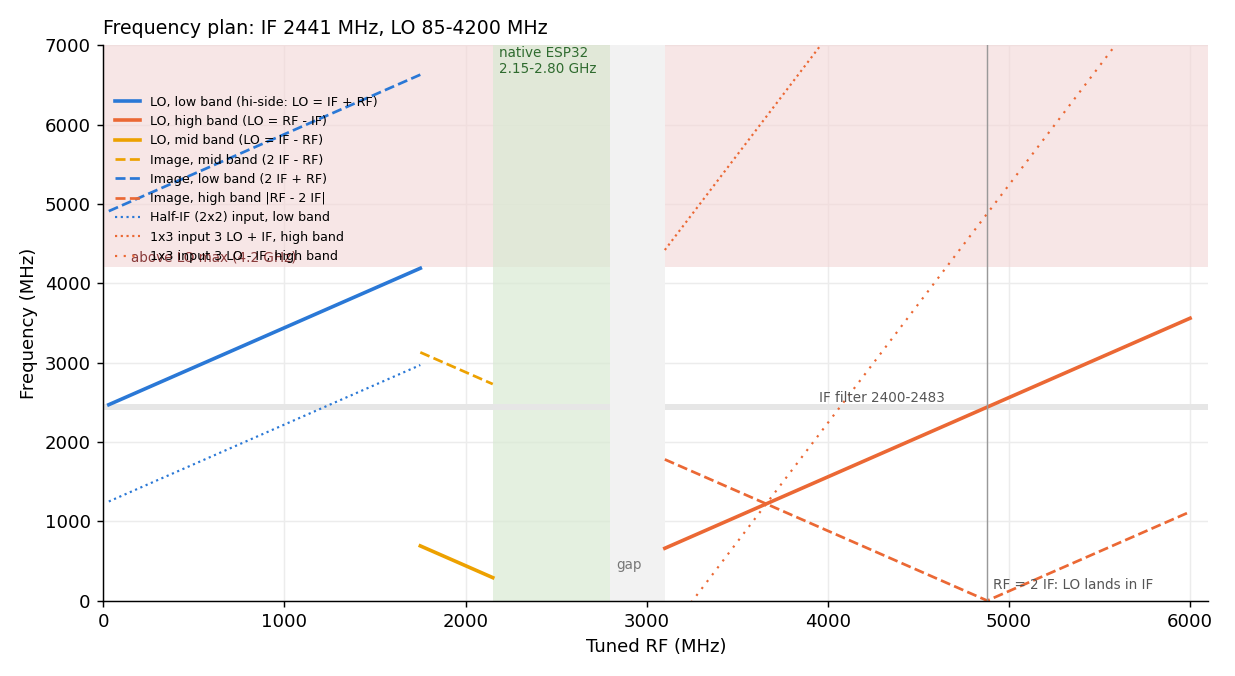
analysis/export/auto_freqplan.png
