kpezeshki/esp32-s31-sdr/analysis/export/auto_if_choice.png

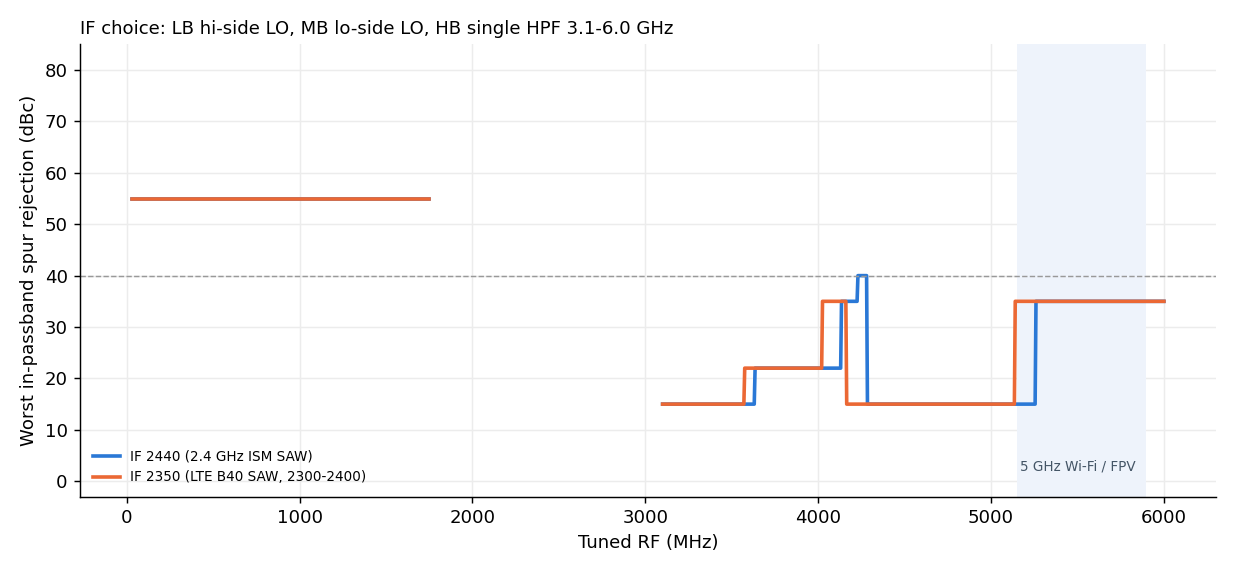
analysis/export/auto_if_choice.png
