kpezeshki/esp32-s31-sdr/analysis/export/auto_levels_hb5800.png

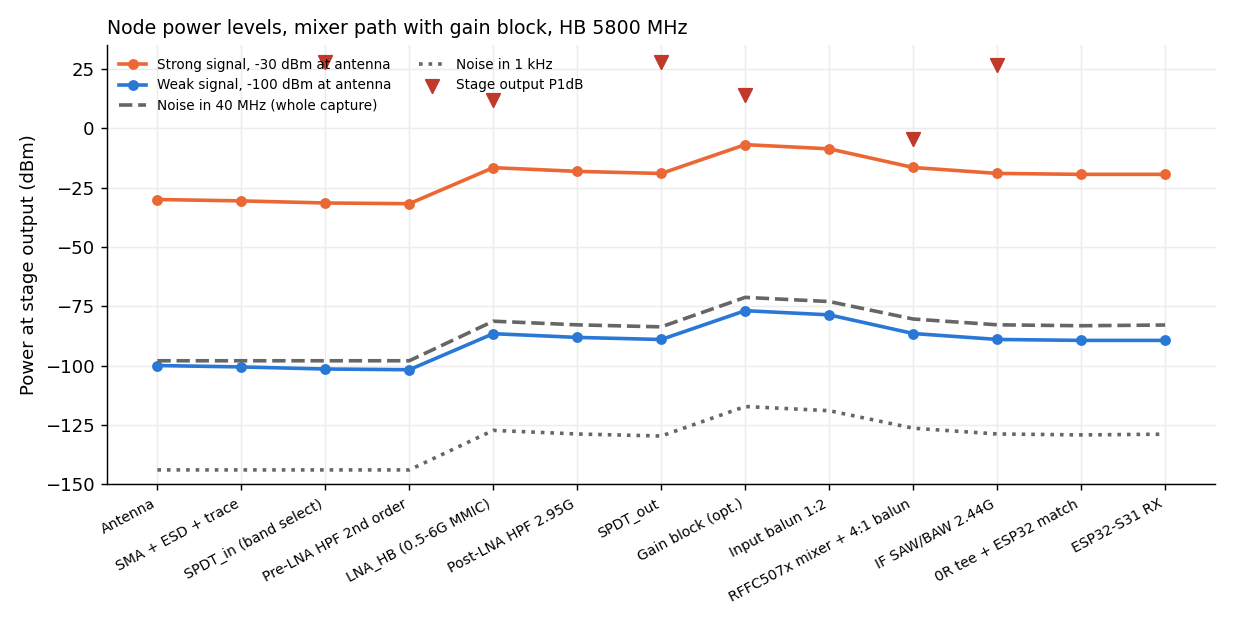
analysis/export/auto_levels_hb5800.png
