kpezeshki/esp32-s31-sdr/analysis/export/auto_levels_lb1090.png

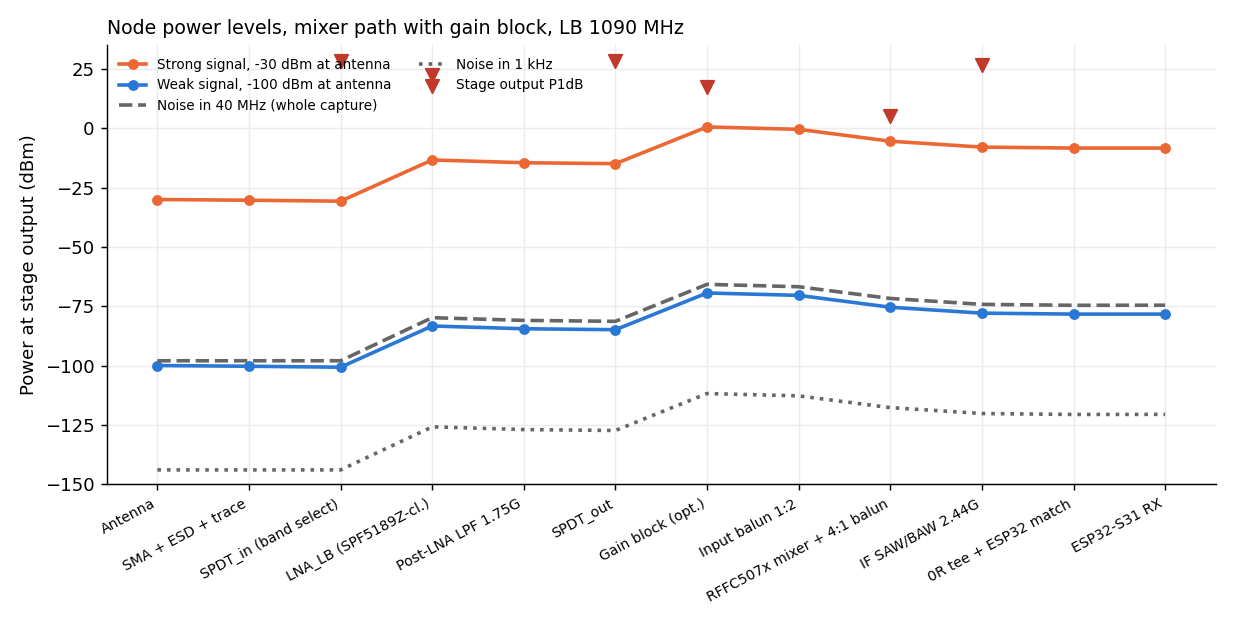
analysis/export/auto_levels_lb1090.png
