kpezeshki/esp32-s31-sdr/analysis/export/auto_nf_contrib.png

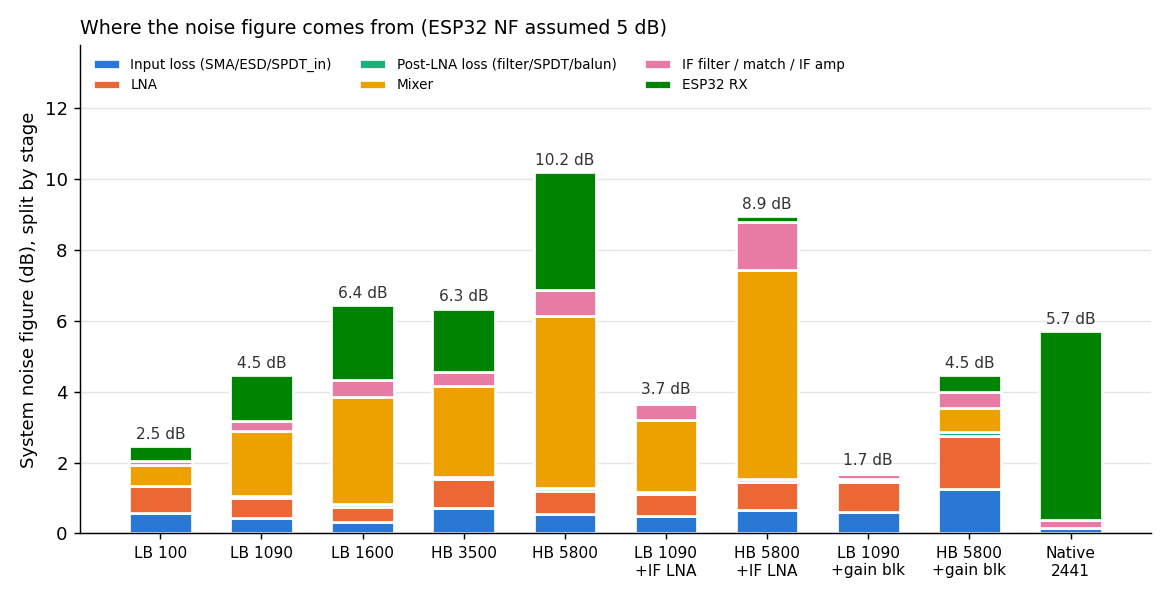
analysis/export/auto_nf_contrib.png
