kpezeshki/esp32-s31-sdr/analysis/export/auto_spurs.png

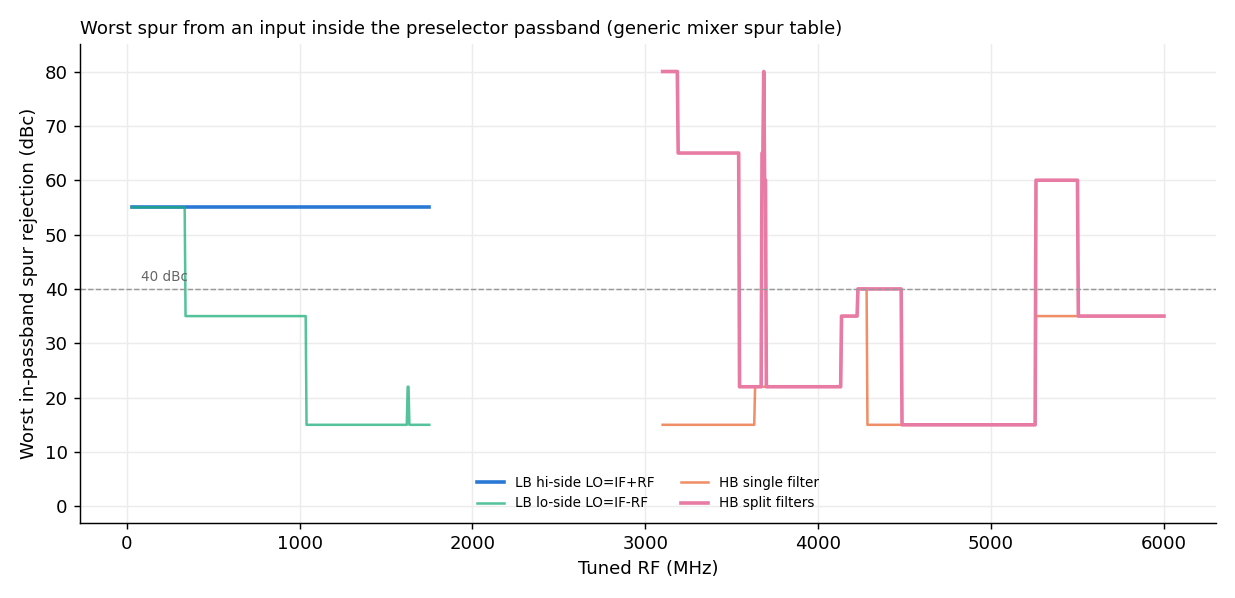
analysis/export/auto_spurs.png
