kpezeshki/esp32-s31-sdr/em/figs/filters_em.png

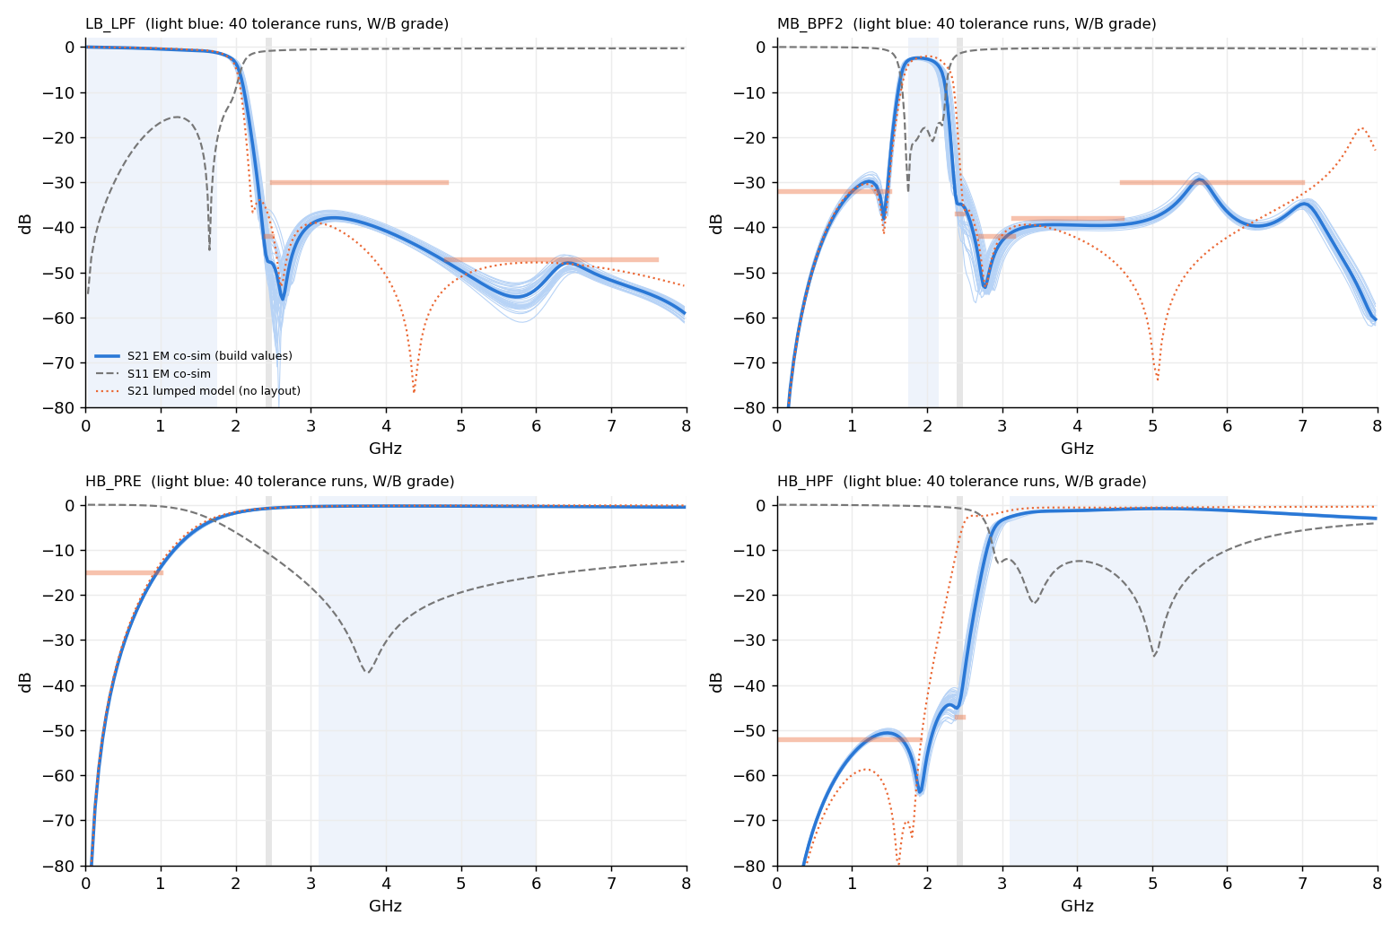
em/figs/filters_em.png
