kpezeshki/esp32-s31-sdr/hw/board_a/esp32sdr_a_routed.png

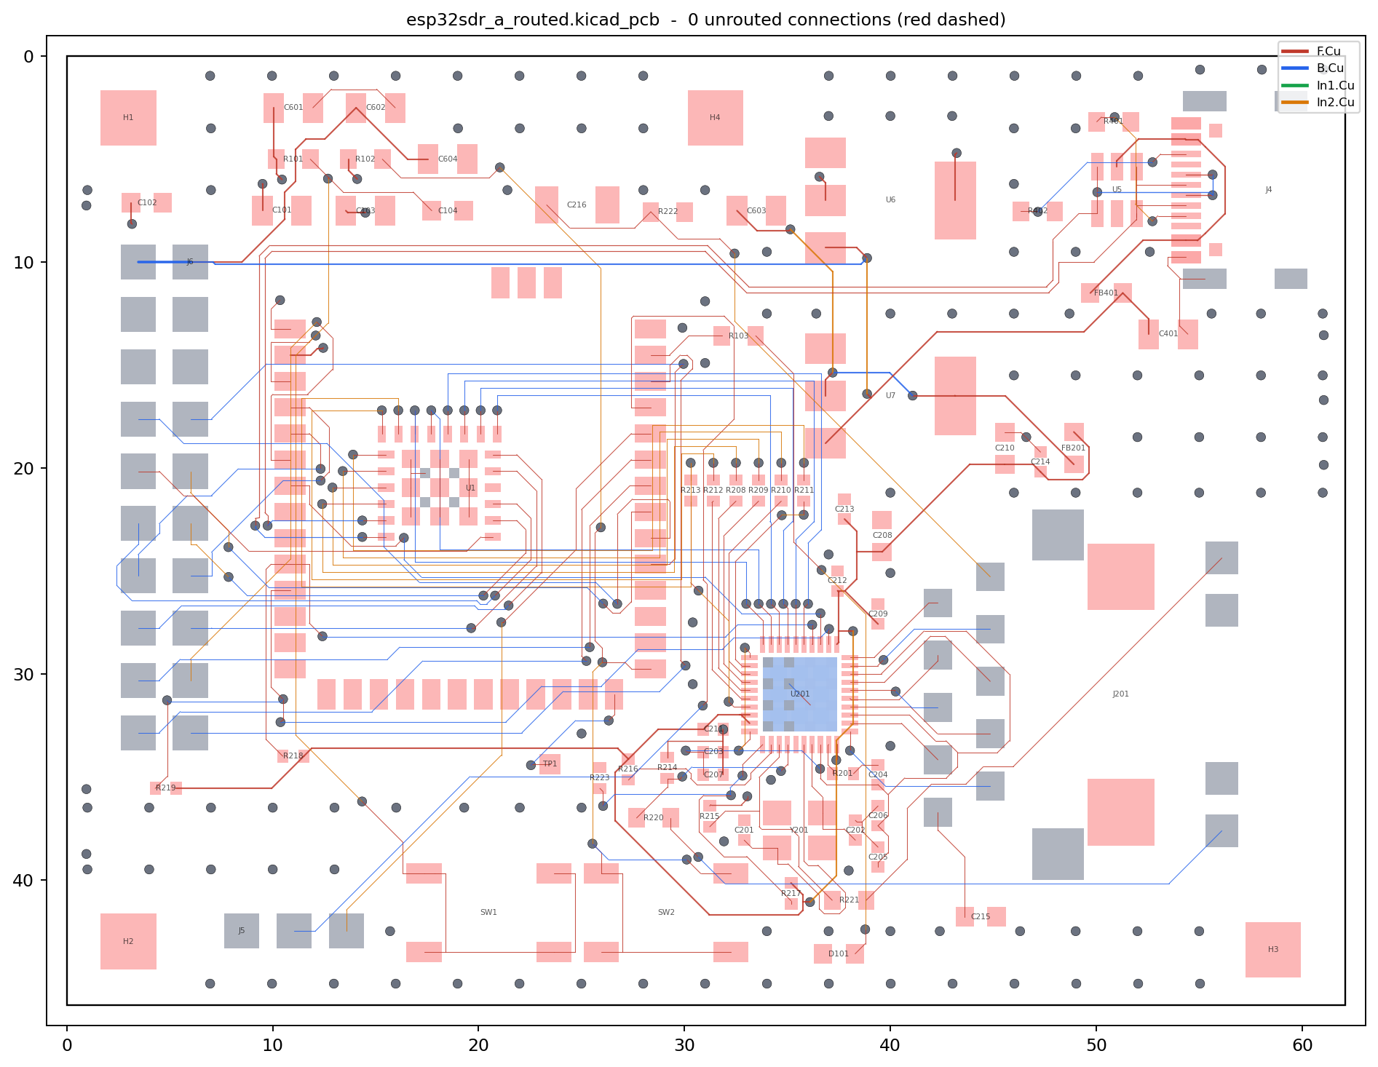
hw/board_a/esp32sdr_a_routed.png
