kpezeshki/esp32-s31-sdr/hw/board_a/place-1.png

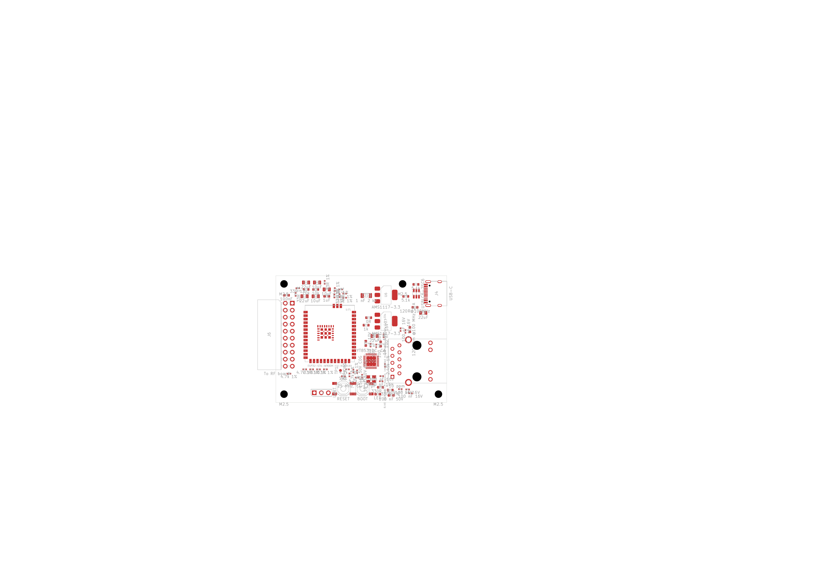
hw/board_a/place-1.png
