kpezeshki/esp32-s31-sdr/hw/board_a/place_view.png

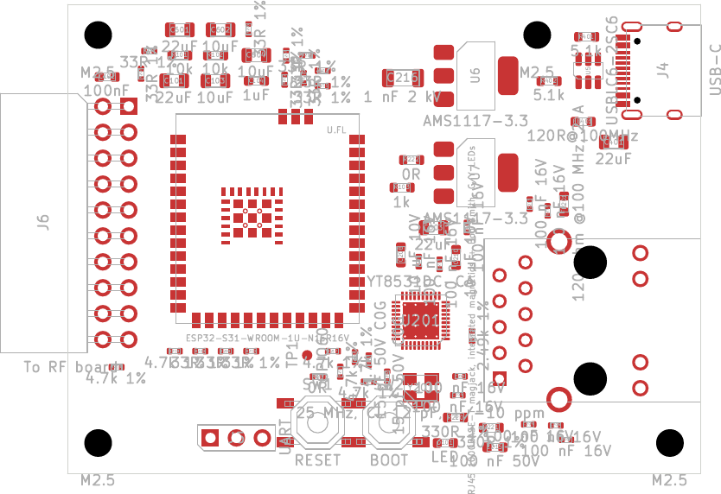
hw/board_a/place_view.png
