kpezeshki/esp32-s31-sdr/hw/board_a/shots/a_copper_B_Cu.png

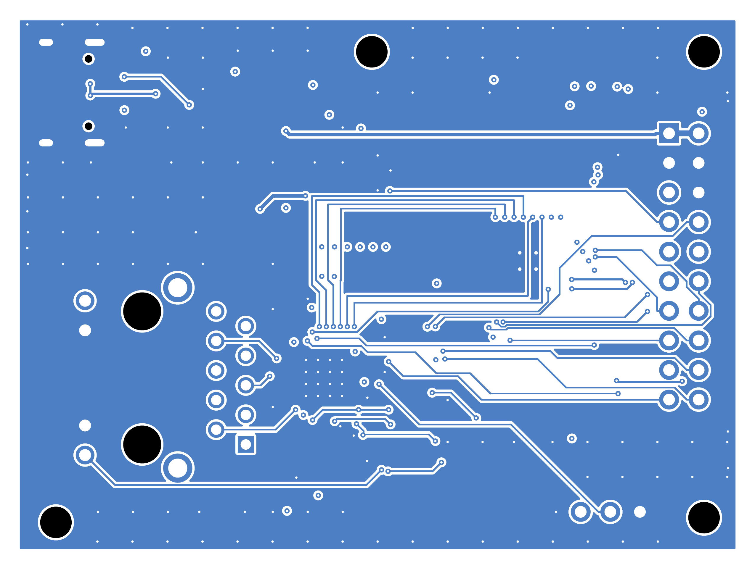
hw/board_a/shots/a_copper_B_Cu.png
