kpezeshki/esp32-s31-sdr/hw/board_a/shots/a_copper_F_Cu.png

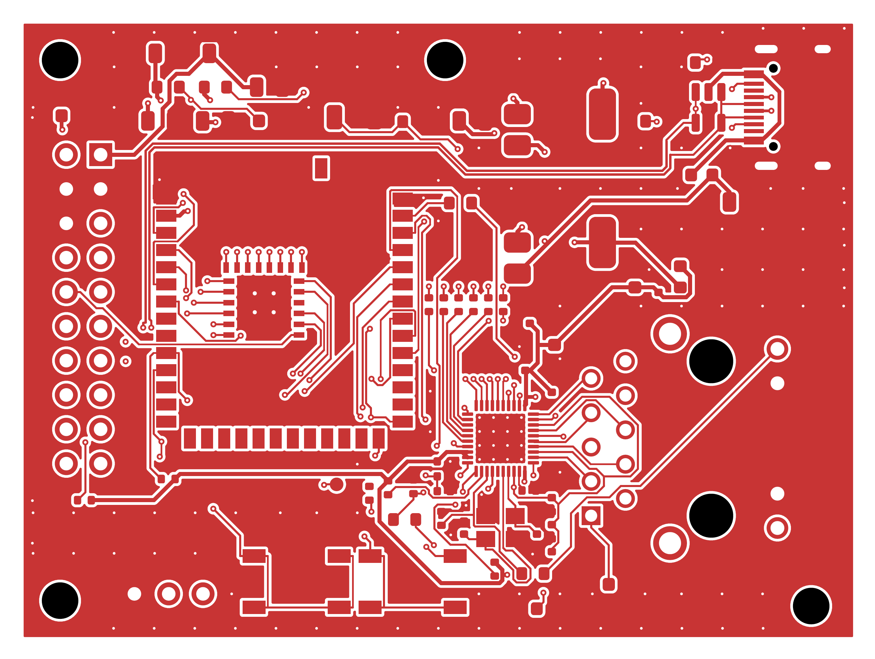
hw/board_a/shots/a_copper_F_Cu.png
