kpezeshki/esp32-s31-sdr/hw/board_b/esp32sdr_b_routed.png

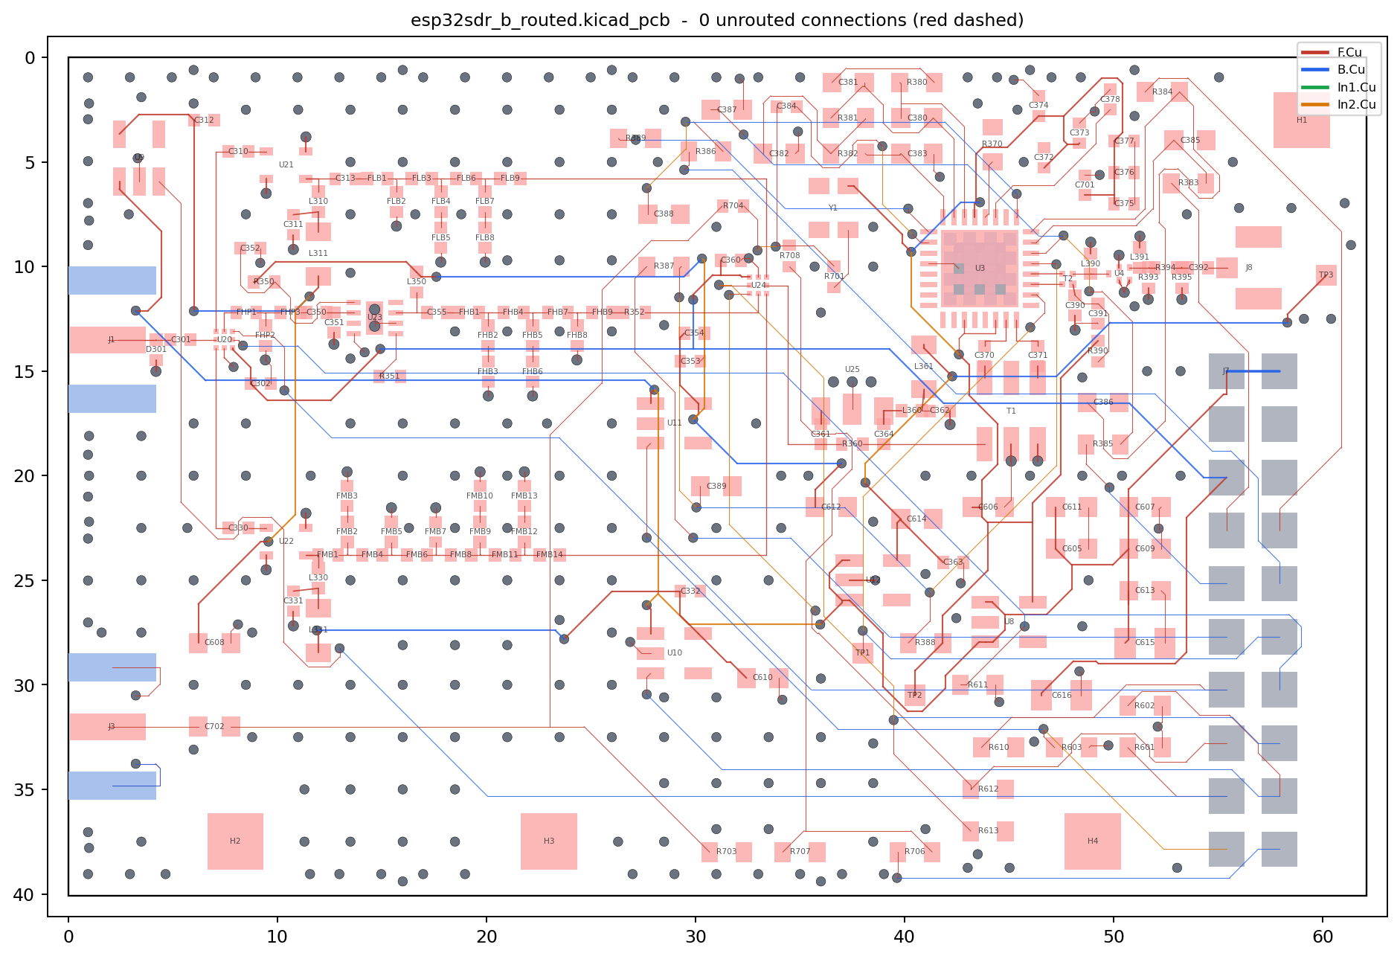
hw/board_b/esp32sdr_b_routed.png
