kpezeshki/esp32-s31-sdr/hw/board_b/place_view.png

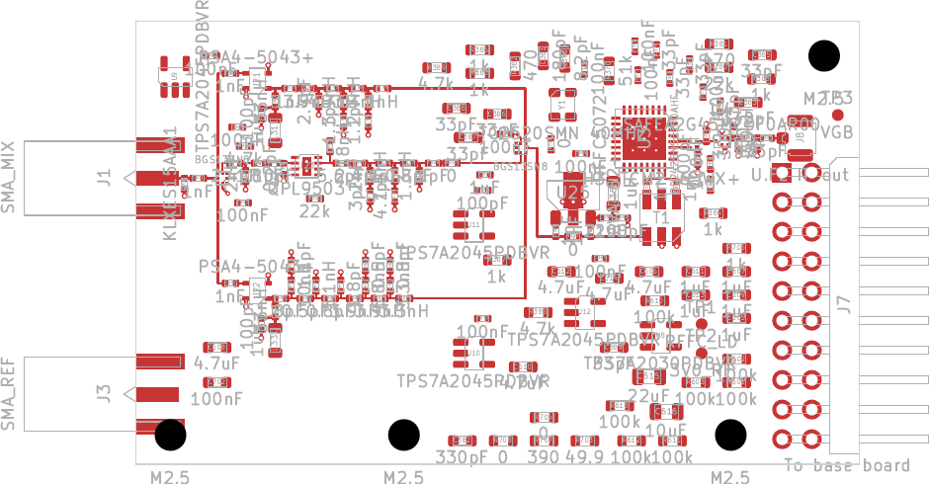
hw/board_b/place_view.png
