kpezeshki/esp32-s31-sdr/hw/board_b/shots/b_copper_In1_Cu.png

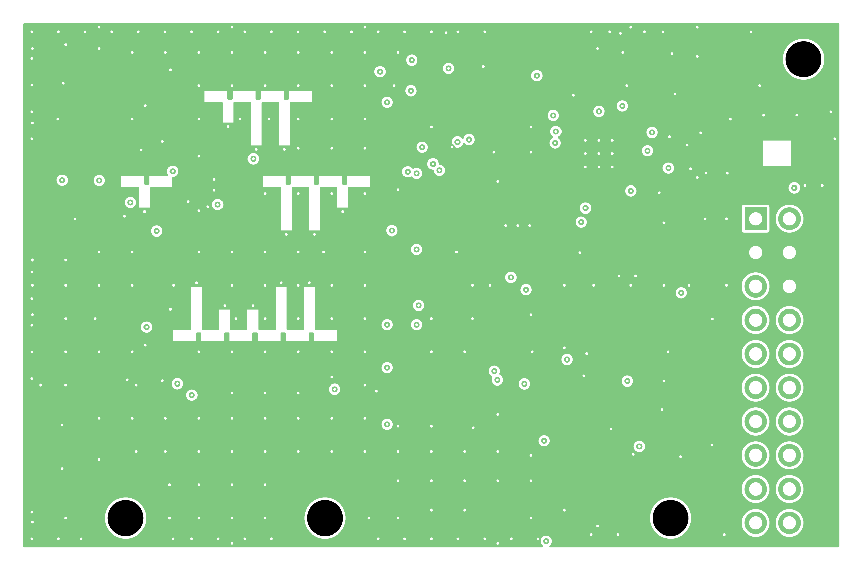
hw/board_b/shots/b_copper_In1_Cu.png
