kpezeshki/esp32-s31-sdr/hw/render/board_full.png

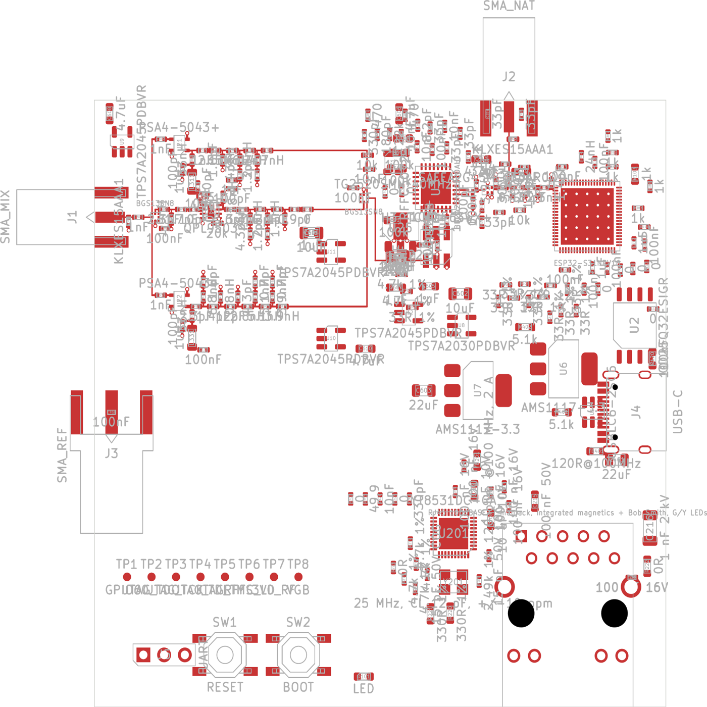
hw/render/board_full.png
