kpezeshki/esp32-s31-sdr/hw/render/board_top.png

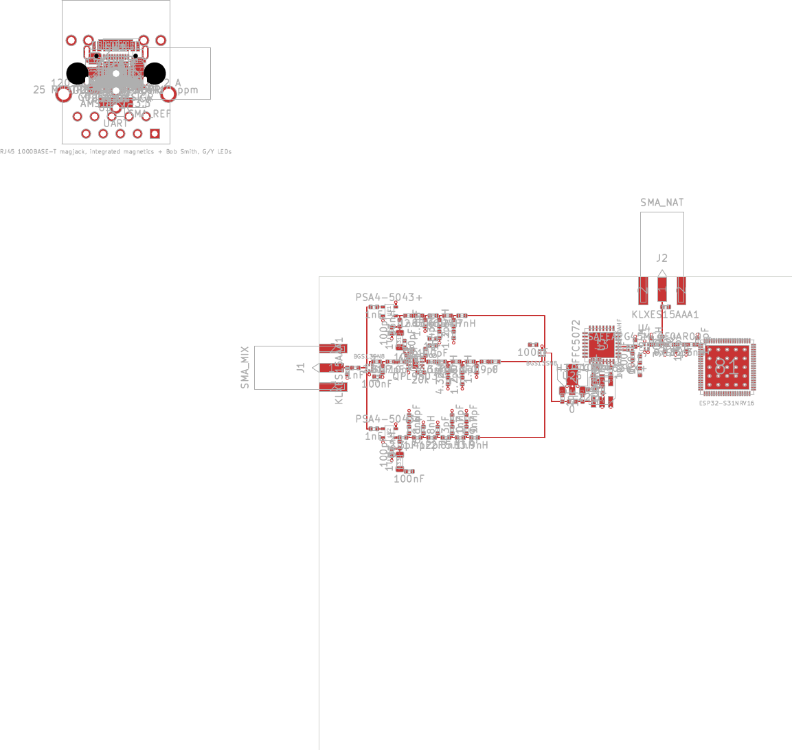
hw/render/board_top.png
