kpezeshki/esp32-s31-sdr/hw/render/rf_frontend.png

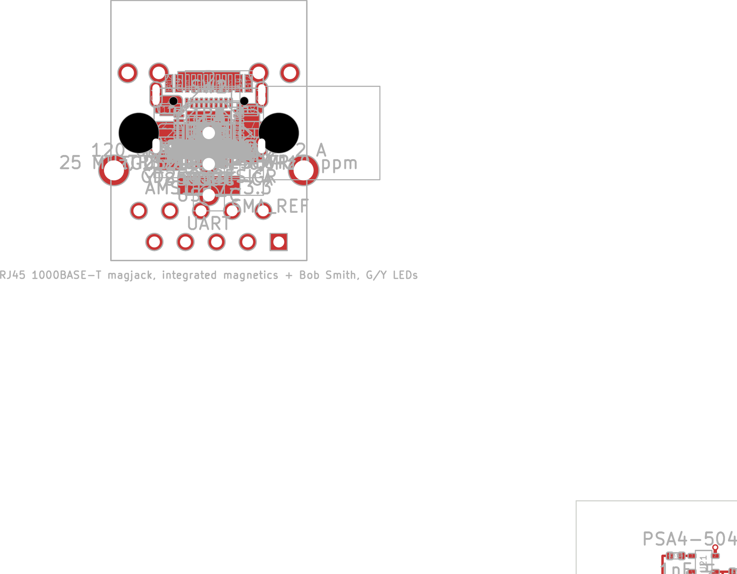
hw/render/rf_frontend.png
