kpezeshki/esp32-s31-sdr/hw/render/rf_left.png

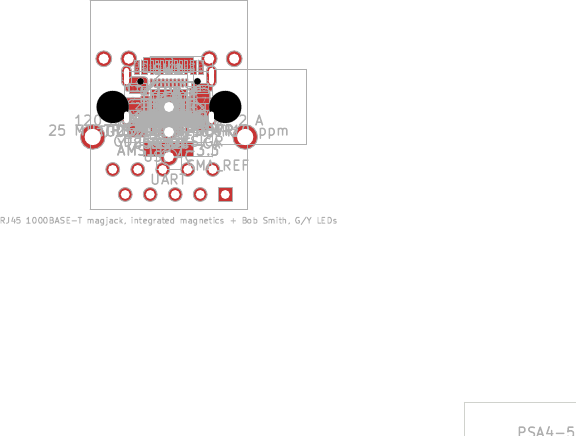
hw/render/rf_left.png
