kpezeshki/esp32-s31-sdr/hw/render/rf_mixer_if.png

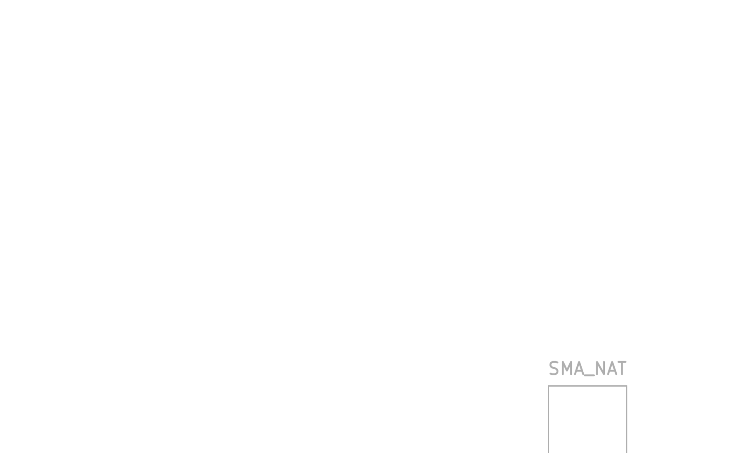
hw/render/rf_mixer_if.png
