kpezeshki/esp32-s31-sdr/hw/render/rf_right.png

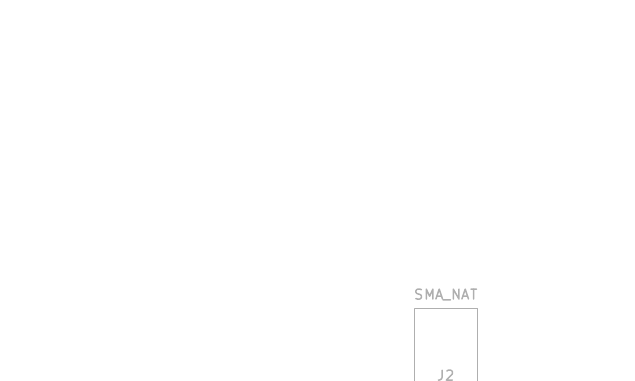
hw/render/rf_right.png
