kpezeshki/esp32-s31-sdr/hw/render/routed_esp.png

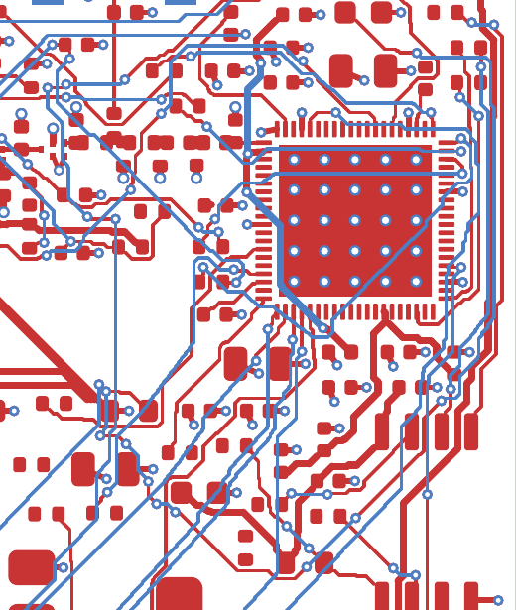
hw/render/routed_esp.png
