kpezeshki/esp32-s31-sdr/hw/render/routed_full.png

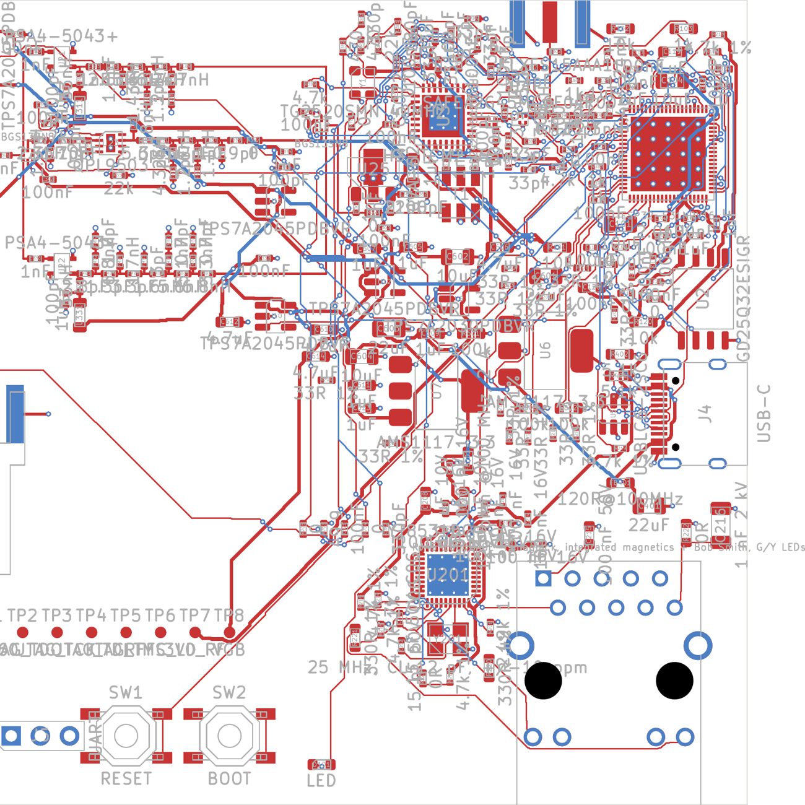
hw/render/routed_full.png
