kpezeshki/esp32-s31-sdr/hw/render/routed_phy.png

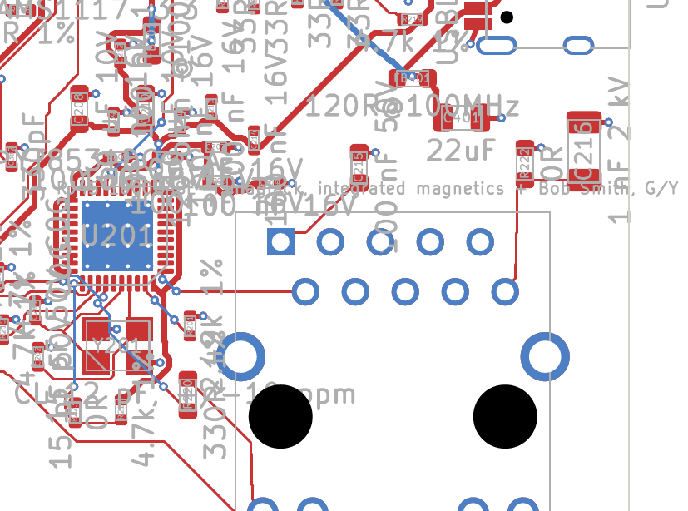
hw/render/routed_phy.png
