kpezeshki/esp32-s31-sdr/hw/render/rt-1.png

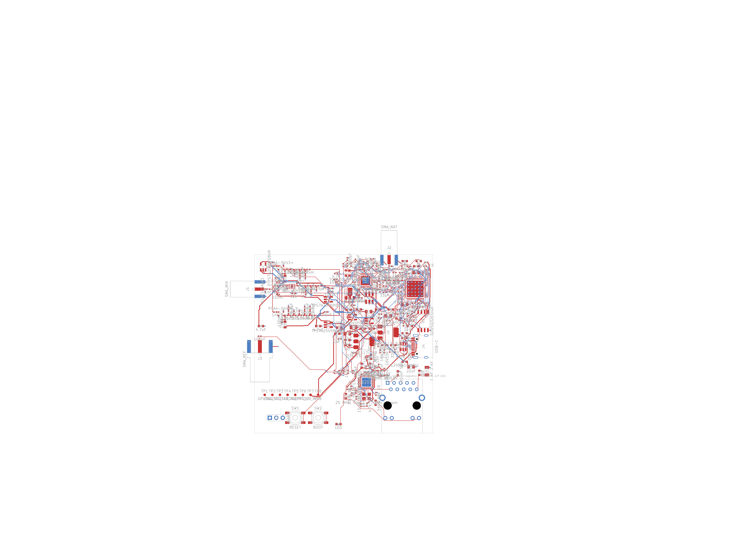
hw/render/rt-1.png
