kpezeshki/esp32-s31-sdr/analysis/export/cascade_parts.md

# Cascade with selected parts (cascade_parts.py)

| Case | Gain block | Gain to ESP32 pin | NF | IIP3 in | P1dB in | ADC clip @ant. |
|---|---|---|---|---|---|---|
| LB 100 | none | +9.0 | 2.91 | +1.7 | -8.9 | -51 |
| LB 1090 | none | +4.6 | 4.60 | +6.0 | -4.5 | -49 |
| LB 1700 | none | +2.0 | 6.24 | +8.6 | -1.9 | -48 |
| MB 1800 | none | +0.5 | 7.31 | +10.0 | -0.4 | -47 |
| MB 2100 | none | -0.6 | 8.22 | +11.1 | +0.7 | -46 |
| HB 3200 | none | +5.0 | 4.74 | +2.4 | -9.3 | -49 |
| HB 3500 | none | +4.9 | 4.85 | +2.0 | -9.8 | -49 |
| HB 5800 | none | +1.2 | 7.22 | +1.2 | -10.7 | -47 |
| LB 100 | gva62 | +25.4 | 1.51 | -14.5 | -25.3 | -53 |
| LB 1090 | gva62 | +20.2 | 1.59 | -9.3 | -20.1 | -52 |
| LB 1700 | gva62 | +17.5 | 1.95 | -6.7 | -17.4 | -52 |
| MB 1800 | gva62 | +16.0 | 2.20 | -5.2 | -15.9 | -52 |
| MB 2100 | gva62 | +14.7 | 2.49 | -4.1 | -14.6 | -52 |
| HB 3200 | gva62 | +20.2 | 2.13 | -13.1 | -24.5 | -52 |
| HB 3500 | gva62 | +20.0 | 2.21 | -13.5 | -24.9 | -52 |
| HB 5800 | gva62 | +15.7 | 2.99 | -13.9 | -25.2 | -51 |
| LB 100 | gva63 | +30.8 | 1.47 | -20.1 | -30.7 | -53 |
| LB 1090 | gva63 | +25.4 | 1.44 | -14.7 | -25.3 | -53 |
| LB 1700 | gva63 | +22.2 | 1.70 | -11.4 | -22.1 | -52 |
| MB 1800 | gva63 | +20.6 | 1.86 | -9.8 | -20.5 | -52 |
| MB 2100 | gva63 | +19.1 | 2.08 | -8.3 | -19.0 | -52 |
| HB 3200 | gva63 | +23.3 | 2.04 | -15.8 | -27.6 | -52 |
| HB 3500 | gva63 | +22.8 | 2.12 | -15.9 | -27.7 | -52 |
| HB 5800 | gva63 | +17.2 | 2.88 | -15.0 | -26.7 | -51 |
