kpezeshki/esp32-s31-sdr/hw/fab/BOM_FULL.csv

Assembly | Qty | Designators | Value | Footprint | LCSC Part #
jlc | 1 | U1 | ESP32-S31NRV16 | Espressif_ESP32-S31_QFN-80_8x8mm_P0.35mm_EP6.5mm | C55601453
hand | 4 | C101,C104,C602,C604 | 10uF | C_0805_2012Metric | C15850
jlc | 23 | C102,C106,C107,C108,C109,C110,C111,C112,C115,C116,C118,C121,C302,C312,C332,C360,C363,C373,C375,C377,C384,C391,C701 | 100nF | C_0402_1005Metric | C1525
jlc | 5 | C103,C105,C114,C117,C354 | 1uF | C_0402_1005Metric | C52923
jlc | 3 | FHB2,FHP2,L101 | 2nH | L_0402_1005Metric | C2986275
dnp | 2 | C113,C702 | 100nF | C_0402_1005Metric | C1525
hand | 2 | R101,R102 | 10k | R_0603_1608Metric | C25804
hand | 6 | C119,C605,C607,C609,C611,C613 | 1uF | C_0603_1608Metric | C15849
jlc | 11 | R110,R111,R112,R113,R114,R115,R352,R390,R391,R701,R702 | 0 | R_0402_1005Metric | C17168
hand | 1 | U2 | GD25Q32ESIGR | SOIC-8_5.23x5.23mm_P1.27mm | C2832998
dnp | 1 | R120 | 10k | R_0603_1608Metric | C25804
hand | 1 | C120 | 100nF | C_0603_1608Metric | C14663
jlc | 1 | L102 | 24nH | L_0402_1005Metric | C27229
hand | 1 | SW1 | RESET | SW_SPST_TL3342 | C318884
hand | 1 | SW2 | BOOT | SW_SPST_TL3342 | C318884
hand | 1 | J5 | UART | PinHeader_1x03_P2.54mm_Vertical | C49257
hand | 1 | R103 | 1k | R_0603_1608Metric | C21190
hand | 1 | D101 | LED | LED_0603_1608Metric | C72043
hand | 1 | J4 | USB-C | USB_C_Receptacle_HRO_TYPE-C-31-M-12 | C165948
hand | 2 | R401,R402 | 5.1k | R_0603_1608Metric | C23186
hand | 1 | U5 | USBLC6-2SC6 | SOT-23-6 | C7519
hand | 1 | FB401 | 120R@100MHz | L_0603_1608Metric | C1015
hand | 3 | C401,C601,C603 | 22uF | C_0805_2012Metric | C45783
hand | 2 | U6,U7 | AMS1117-3.3 | SOT-223-3_TabPin2 | C6186
hand | 1 | U8 | TPS7A2030PDBVR | SOT-23-5 | C963429
hand | 5 | C606,C608,C610,C612,C614 | 4.7uF | C_0603_1608Metric | C19666
hand | 4 | U10,U11,U12,U9 | TPS7A2045PDBVR | SOT-23-5 | C2873627
hand | 3 | R601,R602,R603 | 100k | R_0603_1608Metric | C25803
jlc | 1 | Y1 | TG2520SMN 40MHz | Oscillator_SMD_SeikoEpson_TG2520SMN-xxx-xxxxxx-4Pin_2.5x2.0mm | C3007519
dnp | 1 | J3 | SMA_REF | SMA_Amphenol_132289_EdgeMount
dnp | 1 | R703 | 49.9 | R_0402_1005Metric | C25120
dnp | 4 | R360,R392,R704,R705 | 0 | R_0402_1005Metric | C17168
jlc | 1 | U201 | YT8531DC-CA | QFN-40-1EP_5x5mm_P0.4mm_EP3.6x3.6mm_ThermalVias | C47544379
jlc | 1 | Y201 | 25 MHz, CL 12 pF, +/-10 ppm | Crystal_SMD_3225-4Pin_3.2x2.5mm | C9006
jlc | 2 | C201,C202 | 15 pF 50V C0G | C_0402_1005Metric | C1548
jlc | 1 | R201 | 2.49k 1% | R_0402_1005Metric | C25884
jlc | 10 | C203,C204,C205,C206,C207,C209,C211,C212,C213,C214 | 100 nF 16V | C_0402_1005Metric | C1525
hand | 2 | C208,C210 | 10 uF 10V | C_0603_1608Metric | C19702
hand | 1 | FB201 | 120 ohm @100 MHz, 2 A | L_0603_1608Metric | C14709
jlc | 12 | R202,R203,R204,R205,R206,R207,R208,R209,R210,R211,R212,R213 | 33R 1% | R_0402_1005Metric | C25105
jlc | 6 | R214,R215,R216,R217,R218,R219 | 4.7k 1% | R_0402_1005Metric | C25900
hand | 2 | R220,R221 | 330R 1% | R_0603_1608Metric | C23138
hand | 1 | C215 | 100 nF 50V | C_0603_1608Metric | C14663
hand | 1 | J201 | RJ45 1000BASE-T magjack, integrated magnetics + Bob Smith, G/Y LEDs | RJ45_HanRun_HR911130C | C50933
hand | 1 | R222 | 0R | R_0603_1608Metric | C21189
dnp | 1 | C216 | 1 nF 2 kV | C_1206_3216Metric | C9196
dnp | 1 | R223 | 0R | R_0402_1005Metric | C17168
hand | 1 | J1 | SMA_MIX | SMA_Samtec_SMA-J-P-X-ST-EM1_EdgeMount | C496550
jlc | 2 | D301,D302 | KLXES15AAA1 | D_0402_1005Metric | C2892490
jlc | 8 | C301,C310,C313,C330,C361,C364,C370,C371 | 1nF | C_0402_1005Metric | C1523
jlc | 2 | U20,U24 | BGS13SN8 | Infineon_PG-TSNP-8-1_1.1x1.1mm_P0.4mm | C3312946
jlc | 2 | U21,U22 | PSA4-5043+ | SOT-343_SC-70-4 | C5240848
jlc | 2 | L310,L330 | 33nH | L_0402_1005Metric | C113114
hand | 3 | L311,L331,L361 | 1uH | L_0805_2012Metric | C440216
jlc | 6 | C311,C331,C352,C353,C362,C390 | 100pF | C_0402_1005Metric | C1546
jlc | 6 | FLB1,FLB4,FMB11,FMB8,L390,L391 | 3.9nH | L_0402_1005Metric | C98062
jlc | 3 | FHB1,FHP1,FLB2 | 2.4pF | C_0402_1005Metric | C88889
jlc | 1 | FLB3 | 4.7nH | L_0402_1005Metric | C98064
jlc | 3 | FLB5,FLB8,FMB3 | 1.1pF | C_0402_1005Metric | C88879
jlc | 3 | FLB6,FMB12,FMB14 | 3.3nH | L_0402_1005Metric | C98061
jlc | 2 | FLB7,L392 | 2.7nH | L_0402_1005Metric | C91239
jlc | 1 | FLB9 | 1nH | L_0402_1005Metric | C162538
jlc | 5 | C393,C394,FHP3,FMB1,FMB7 | 1.8pF | C_0402_1005Metric | C76903
jlc | 1 | FMB2 | 10nH | L_0402_1005Metric | C90642
jlc | 2 | FMB10,FMB4 | 0.5pF | C_0402_1005Metric | C76912
jlc | 1 | FMB5 | 5.1nH | L_0402_1005Metric | C113117
jlc | 3 | FHB7,FMB13,FMB6 | 0.8pF | C_0402_1005Metric | C88902
jlc | 1 | FMB9 | 6.8nH | L_0402_1005Metric | C82919
jlc | 1 | C350 | 10pF | C_0402_1005Metric | C85873
dnp | 1 | C351 | 0.2pF | C_0402_1005Metric
jlc | 1 | U23 | QPL9503 | DFN-8-1EP_2x2mm_P0.5mm_EP0.8x1.6mm | C470924
jlc | 3 | R350,R388,R389 | 4.7k | R_0402_1005Metric | C25900
jlc | 1 | L350 | 18nH | L_0402_1005Metric | C91622
jlc | 2 | R351,R380 | 22k | R_0402_1005Metric | C25768
jlc | 1 | C355 | 5.6pF | C_0402_1005Metric | C161329
jlc | 1 | FHB3 | 3pF | C_0402_1005Metric | C88891
jlc | 2 | FHB4,FHB9 | 1pF | C_0402_1005Metric | C72134
jlc | 1 | FHB5 | 1.5nH | L_0402_1005Metric | C18221
jlc | 1 | FHB6 | 4.7pF | C_0402_1005Metric | C161327
jlc | 1 | FHB8 | 1.3nH | L_0402_1005Metric | C91238
jlc | 1 | U25 | GVA-62+ | SOT-89-3 | C5445184
jlc | 1 | L360 | 22nH | L_0402_1005Metric | C86129
jlc | 1 | T1 | H3-TCM2-63WX+ | Mini-Circuits_DB1627 | C22383437
jlc | 1 | U3 | RFFC5072 | QFN-32-1EP_5x5mm_P0.5mm_EP3.7x3.7mm_ThermalVias | C3034742
jlc | 1 | R370 | 51k | R_0402_1005Metric | C25794
jlc | 10 | C372,C374,C376,C378,C385,C386,C387,C388,C389,C392 | 33pF | C_0402_1005Metric | C426031
jlc | 1 | C380 | 8.2pF | C_0402_1005Metric | C1529
jlc | 1 | C381 | 180pF | C_0402_1005Metric | C1600
jlc | 2 | R381,R382 | 470 | R_0402_1005Metric | C25117
jlc | 2 | C382,C383 | 330pF | C_0402_1005Metric | C1664
jlc | 5 | R383,R384,R385,R386,R387 | 1k | R_0402_1005Metric | C11702
jlc | 1 | T2 | BD2425N50200AHF | Anaren_Xinger_0404_BD2425 | C502748
jlc | 1 | U4 | SAFEA2G45MC0F0AR00 | Filter_1411-5_1.4x1.1mm | C910550
hand | 1 | J2 | SMA_NAT | SMA_Samtec_SMA-J-P-X-ST-EM1_EdgeMount | C496550
jlc | 2 | R393,R395 | 300 | R_0402_1005Metric | C25102
jlc | 1 | R394 | 18 | R_0402_1005Metric | C25113
hand | 1 | TP1 | GPIO60 | TestPoint_Pad_D1.0mm
hand | 1 | TP2 | JTAG_TDO | TestPoint_Pad_D1.0mm
hand | 1 | TP3 | JTAG_TCK | TestPoint_Pad_D1.0mm
hand | 1 | TP4 | JTAG_TDI | TestPoint_Pad_D1.0mm
hand | 1 | TP5 | JTAG_TMS | TestPoint_Pad_D1.0mm
hand | 1 | TP6 | RFFC_LD | TestPoint_Pad_D1.0mm
hand | 1 | TP7 | 3V0_RF | TestPoint_Pad_D1.0mm
hand | 1 | TP8 | VGB | TestPoint_Pad_D1.0mm
