kpezeshki/esp32-s31-sdr/hw/fab/BOM_HAND_LCSC.csv

LCSC Part # | Qty per board | Designators | Value | Footprint
C15850 | 4 | C101,C104,C602,C604 | 10uF | C_0805_2012Metric
C25804 | 2 | R101,R102 | 10k | R_0603_1608Metric
C15849 | 6 | C119,C605,C607,C609,C611,C613 | 1uF | C_0603_1608Metric
C2832998 | 1 | U2 | GD25Q32ESIGR | SOIC-8_5.23x5.23mm_P1.27mm
C14663 | 1 | C120 | 100nF | C_0603_1608Metric
C318884 | 1 | SW1 | RESET | SW_SPST_TL3342
C318884 | 1 | SW2 | BOOT | SW_SPST_TL3342
C49257 | 1 | J5 | UART | PinHeader_1x03_P2.54mm_Vertical
C21190 | 1 | R103 | 1k | R_0603_1608Metric
C72043 | 1 | D101 | LED | LED_0603_1608Metric
C165948 | 1 | J4 | USB-C | USB_C_Receptacle_HRO_TYPE-C-31-M-12
C23186 | 2 | R401,R402 | 5.1k | R_0603_1608Metric
C7519 | 1 | U5 | USBLC6-2SC6 | SOT-23-6
C1015 | 1 | FB401 | 120R@100MHz | L_0603_1608Metric
C45783 | 3 | C401,C601,C603 | 22uF | C_0805_2012Metric
C6186 | 2 | U6,U7 | AMS1117-3.3 | SOT-223-3_TabPin2
C963429 | 1 | U8 | TPS7A2030PDBVR | SOT-23-5
C19666 | 5 | C606,C608,C610,C612,C614 | 4.7uF | C_0603_1608Metric
C2873627 | 4 | U10,U11,U12,U9 | TPS7A2045PDBVR | SOT-23-5
C25803 | 3 | R601,R602,R603 | 100k | R_0603_1608Metric
C19702 | 2 | C208,C210 | 10 uF 10V | C_0603_1608Metric
C14709 | 1 | FB201 | 120 ohm @100 MHz, 2 A | L_0603_1608Metric
C23138 | 2 | R220,R221 | 330R 1% | R_0603_1608Metric
C14663 | 1 | C215 | 100 nF 50V | C_0603_1608Metric
C50933 | 1 | J201 | RJ45 1000BASE-T magjack, integrated magnetics + Bob Smith, G/Y LEDs | RJ45_HanRun_HR911130C
C21189 | 1 | R222 | 0R | R_0603_1608Metric
C496550 | 1 | J1 | SMA_MIX | SMA_Samtec_SMA-J-P-X-ST-EM1_EdgeMount
C440216 | 3 | L311,L331,L361 | 1uH | L_0805_2012Metric
C496550 | 1 | J2 | SMA_NAT | SMA_Samtec_SMA-J-P-X-ST-EM1_EdgeMount
 | 1 | TP1 | GPIO60 | TestPoint_Pad_D1.0mm
 | 1 | TP2 | JTAG_TDO | TestPoint_Pad_D1.0mm
 | 1 | TP3 | JTAG_TCK | TestPoint_Pad_D1.0mm
 | 1 | TP4 | JTAG_TDI | TestPoint_Pad_D1.0mm
 | 1 | TP5 | JTAG_TMS | TestPoint_Pad_D1.0mm
 | 1 | TP6 | RFFC_LD | TestPoint_Pad_D1.0mm
 | 1 | TP7 | 3V0_RF | TestPoint_Pad_D1.0mm
 | 1 | TP8 | VGB | TestPoint_Pad_D1.0mm
