kpezeshki/esp32-s31-sdr/hw/board_b/fab/BOM_B_HAND_LCSC.csv

LCSC Part # | Qty per board | Designators | Value | Footprint
C2873627 | 4 | U10,U11,U12,U9 | TPS7A2045PDBVR | SOT-23-5
C15849 | 5 | C605,C607,C609,C611,C613 | 1uF | C_0603_1608Metric
C19666 | 5 | C606,C608,C610,C612,C614 | 4.7uF | C_0603_1608Metric
C25803 | 7 | R601,R602,R603,R610,R611,R612,R613 | 100k | R_0603_1608Metric
C963429 | 1 | U8 | TPS7A2030PDBVR | SOT-23-5
C45783 | 1 | C615 | 22uF | C_0805_2012Metric
C15850 | 1 | C616 | 10uF | C_0805_2012Metric
C492438 | 1 | J7 | To base board | PinHeader_2x10_P2.54mm_Horizontal
C496550 | 1 | J1 | SMA_MIX | SMA_Samtec_SMA-J-P-X-ST-EM1_EdgeMount
C440216 | 3 | L311,L331,L361 | 1uH | L_0805_2012Metric
C23196 | 1 | R370 | 51k | R_0603_1608Metric
C1685 | 1 | C380 | 8.2pF | C_0603_1608Metric
C31850 | 1 | R380 | 22k | R_0603_1608Metric
C124184 | 1 | C381 | 180pF | C_0603_1608Metric
C23179 | 2 | R381,R382 | 470 | R_0603_1608Metric
C190577 | 2 | C382,C383 | 330pF | C_0603_1608Metric
C21190 | 5 | R383,R384,R385,R386,R387 | 1k | R_0603_1608Metric
C91368 | 5 | C385,C386,C387,C388,C389 | 33pF | C_0603_1608Metric
C23162 | 2 | R388,R389 | 4.7k | R_0603_1608Metric
 | 1 | TP1 | RFFC_LD | TestPoint_Pad_D1.0mm
 | 1 | TP2 | 3V0_RF | TestPoint_Pad_D1.0mm
 | 1 | TP3 | VGB | TestPoint_Pad_D1.0mm
