kpezeshki/esp32-s31-sdr/hw/board_a/place.pdf

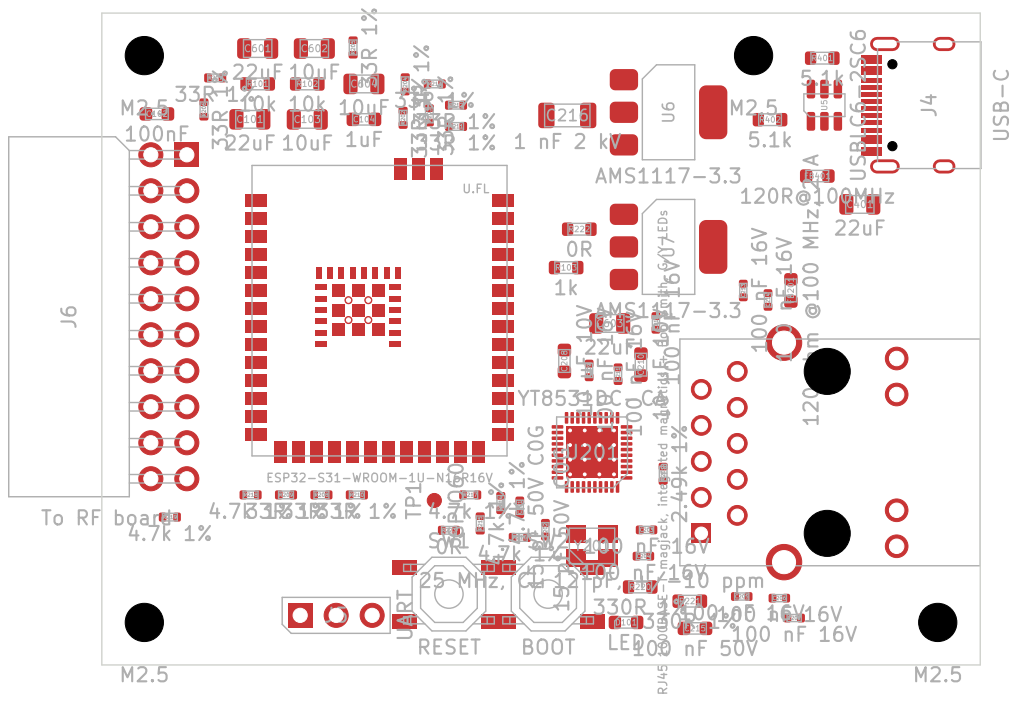
[picture p51: page 1]

C206 RJ45 1000BASE-T magjack, integrated magnetics + Bob Smith, G/Y LEDs 33R 1% R205 4.7k 1%
