kpezeshki/esp32-s31-sdr/hw/board_b/place.pdf

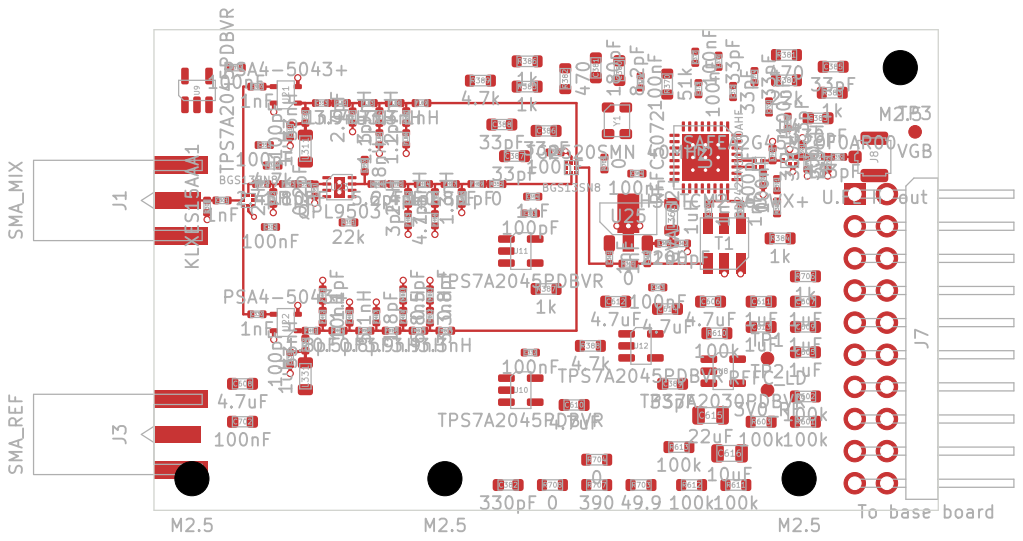
[picture p52: page 1]
