kpezeshki/esp32-s31-sdr/hw/render/routed.pdf

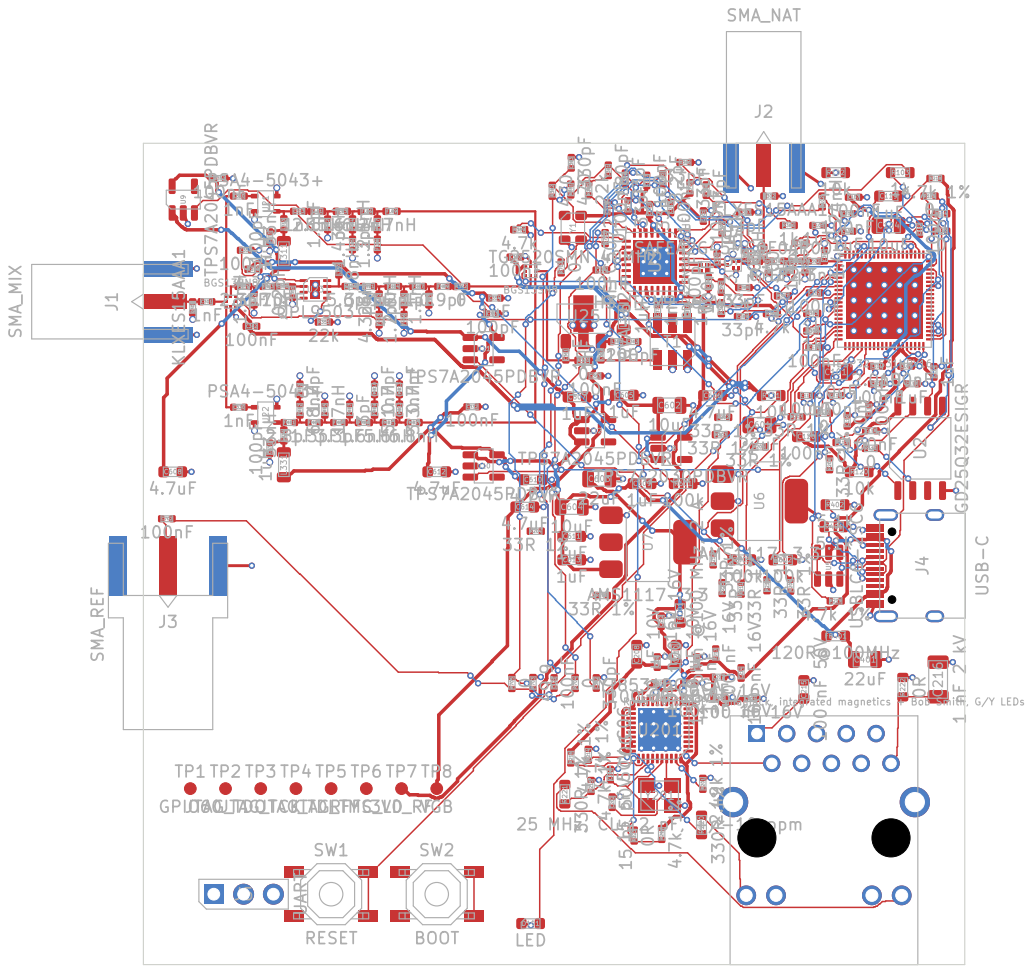
[picture p53: page 1]
