kpezeshki/esp32-s31-sdr/hw/render/top.pdf

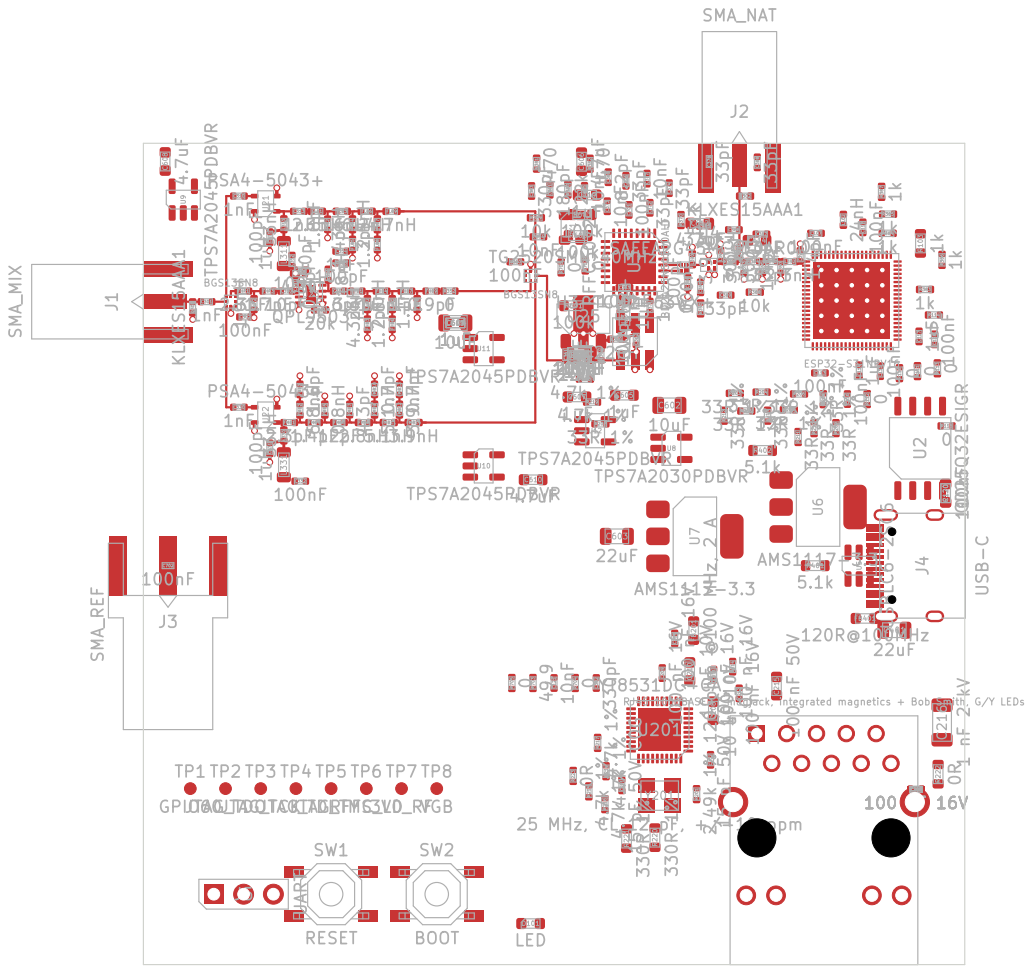
[picture p54: page 1]
