kpezeshki/esp32-s31-sdr/hw/board_a/fab/esp32sdr_a_routed-B_Cu.pdf

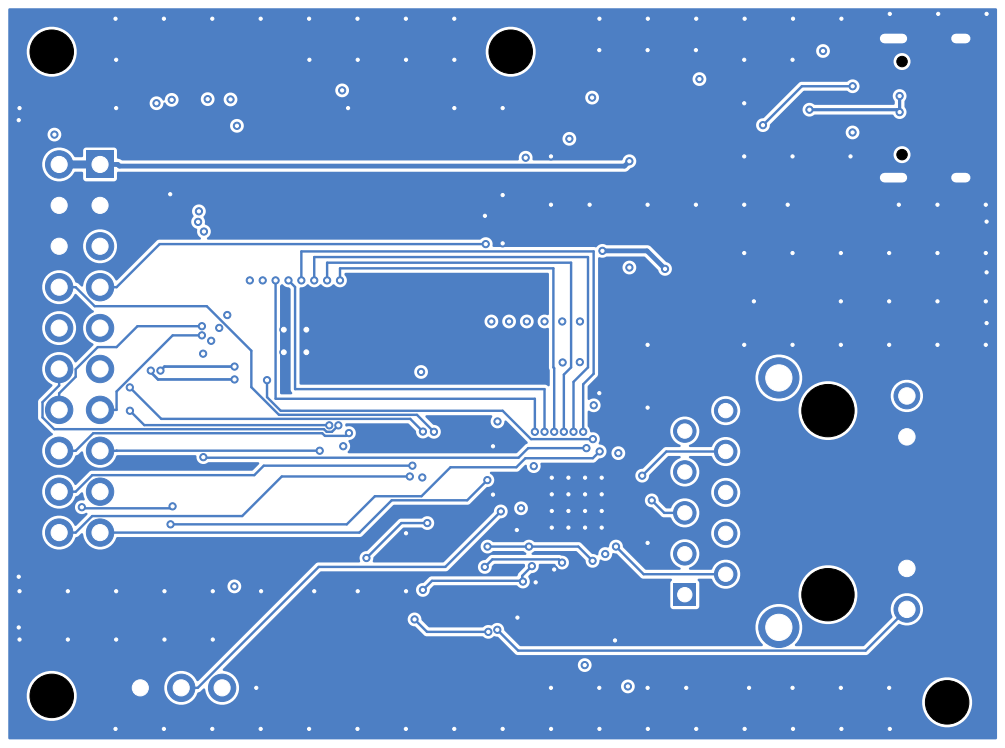
[picture p55: page 1]
