kpezeshki/esp32-s31-sdr/hw/board_a/fab/esp32sdr_a_routed-Edge_Cuts.pdf

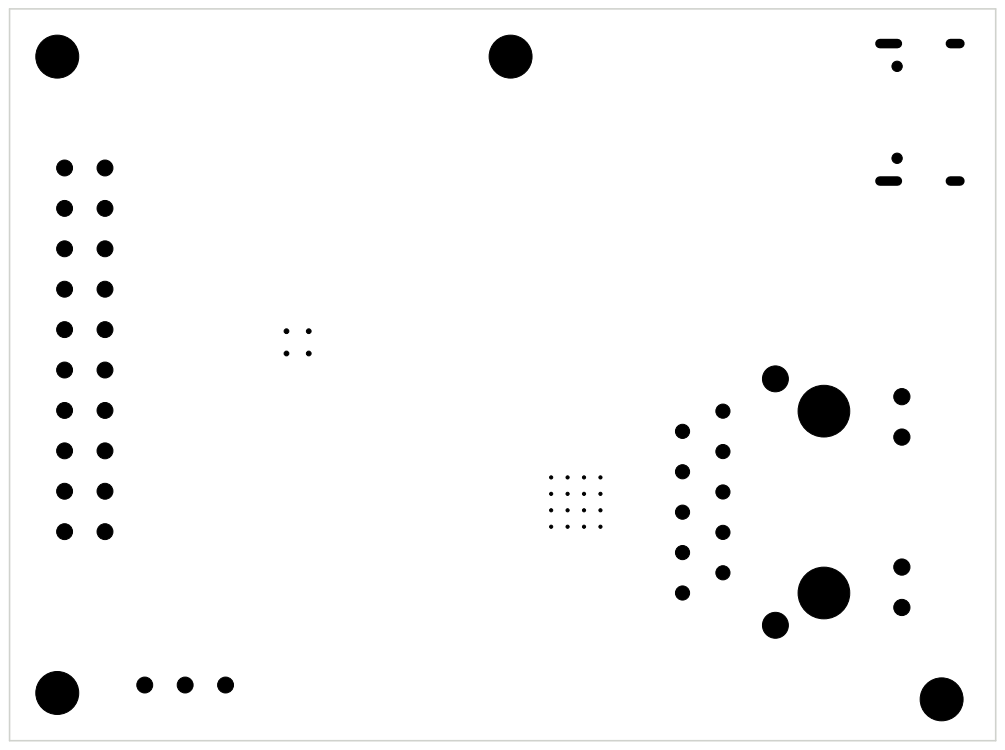
[picture p56: page 1]
