kpezeshki/esp32-s31-sdr/hw/board_a/fab/esp32sdr_a_routed-F_Cu.pdf

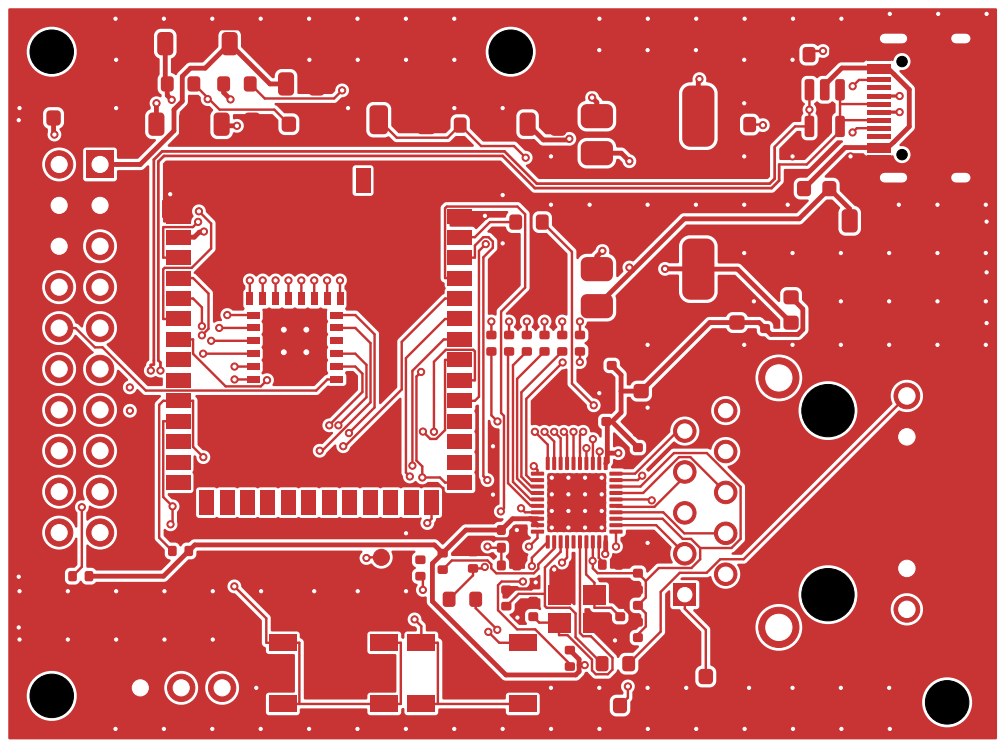
[picture p57: page 1]
