kpezeshki/esp32-s31-sdr/hw/board_a/fab/esp32sdr_a_routed-F_Silkscreen.pdf

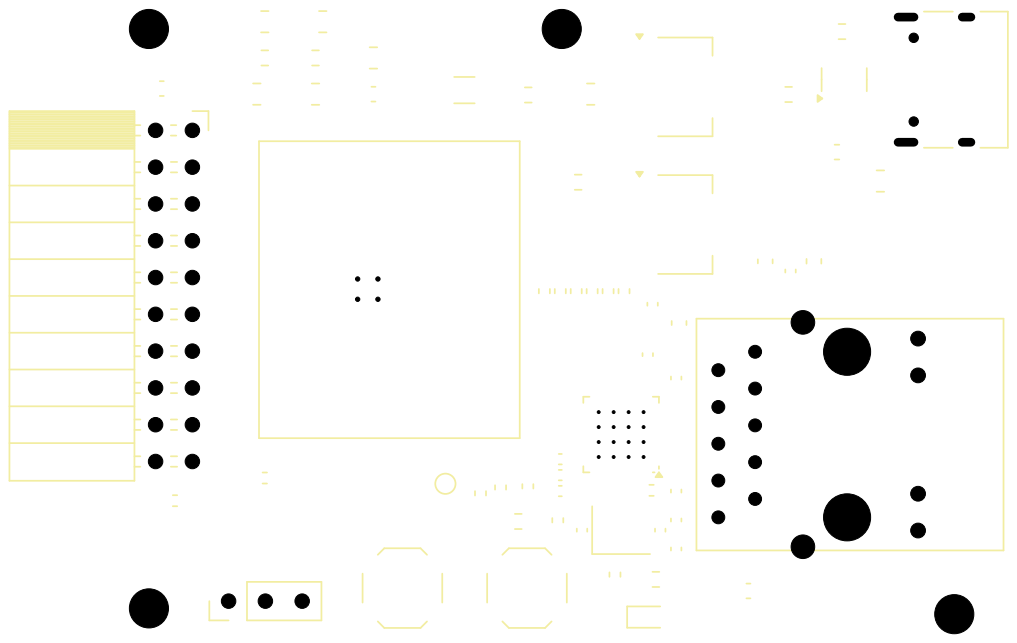
[picture p58: page 1]
