kpezeshki/esp32-s31-sdr/hw/board_a/fab/esp32sdr_a_routed-In1_Cu.pdf

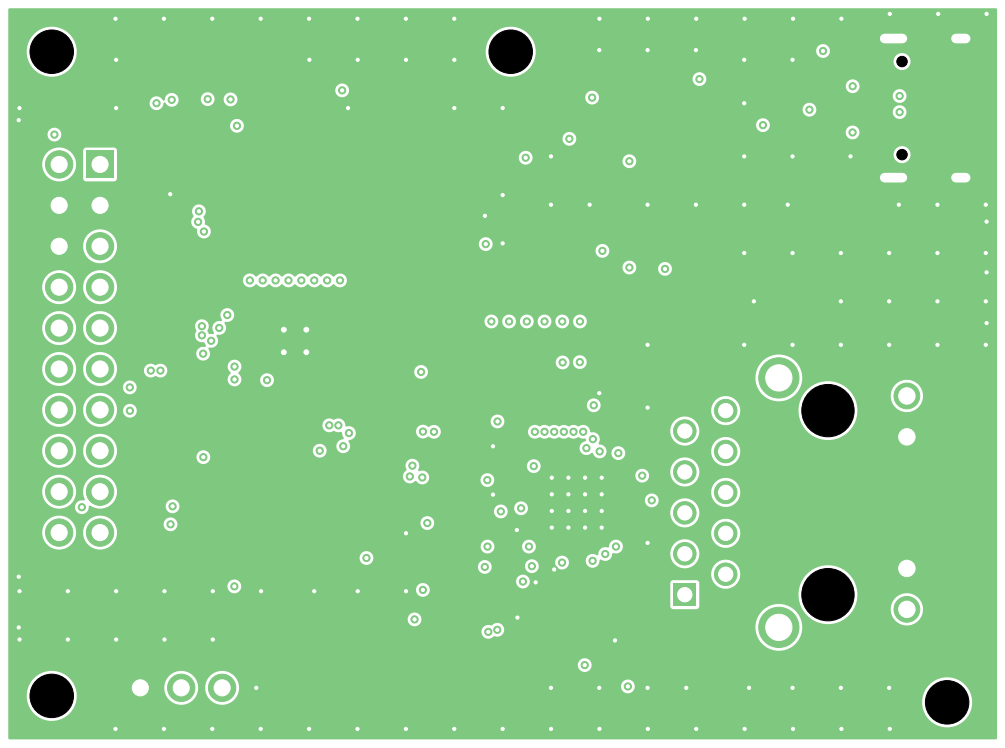
[picture p59: page 1]
