kpezeshki/esp32-s31-sdr/hw/board_a/fab/esp32sdr_a_routed-In2_Cu.pdf

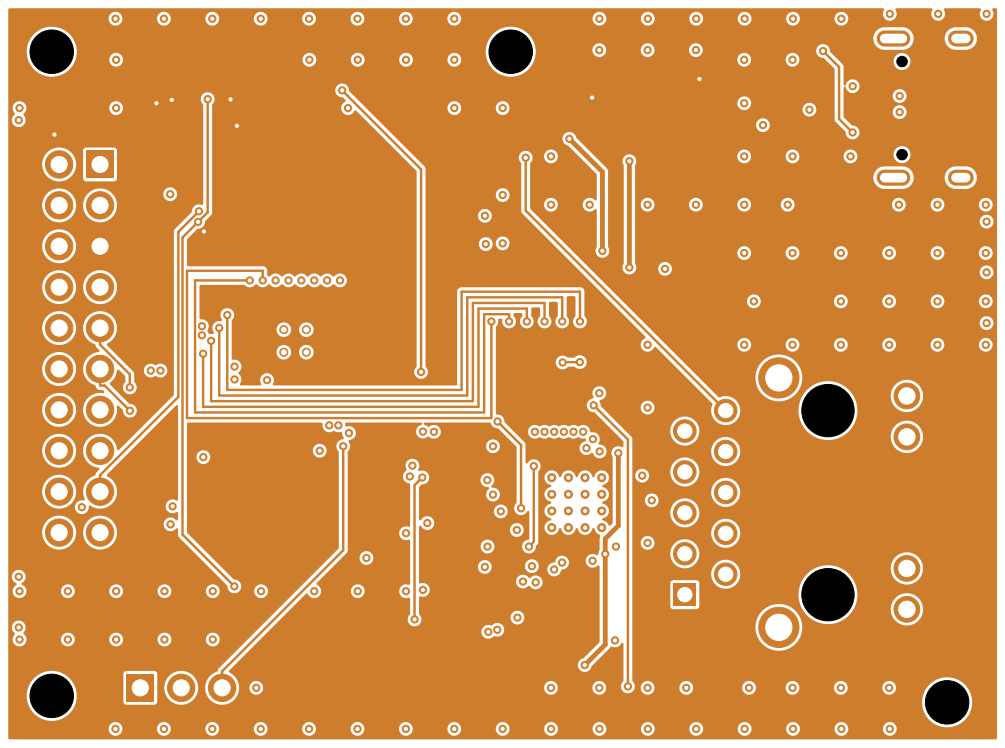
[picture p60: page 1]
