kpezeshki/esp32-s31-sdr/hw/board_b/fab/esp32sdr_b_routed-B_Cu.pdf

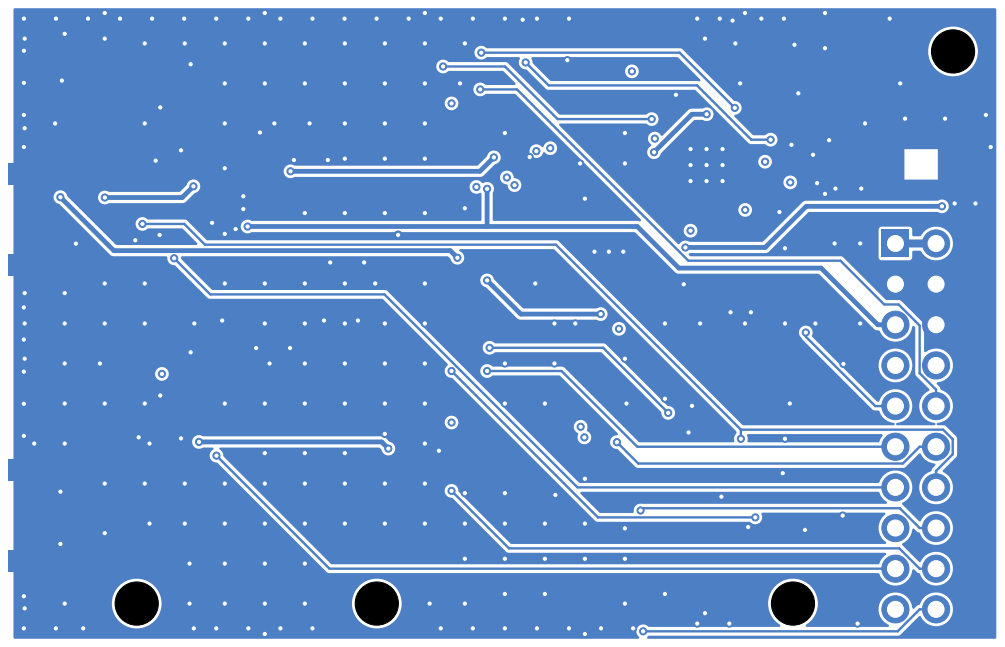
[picture p61: page 1]
