kpezeshki/esp32-s31-sdr/hw/board_b/fab/esp32sdr_b_routed-Edge_Cuts.pdf

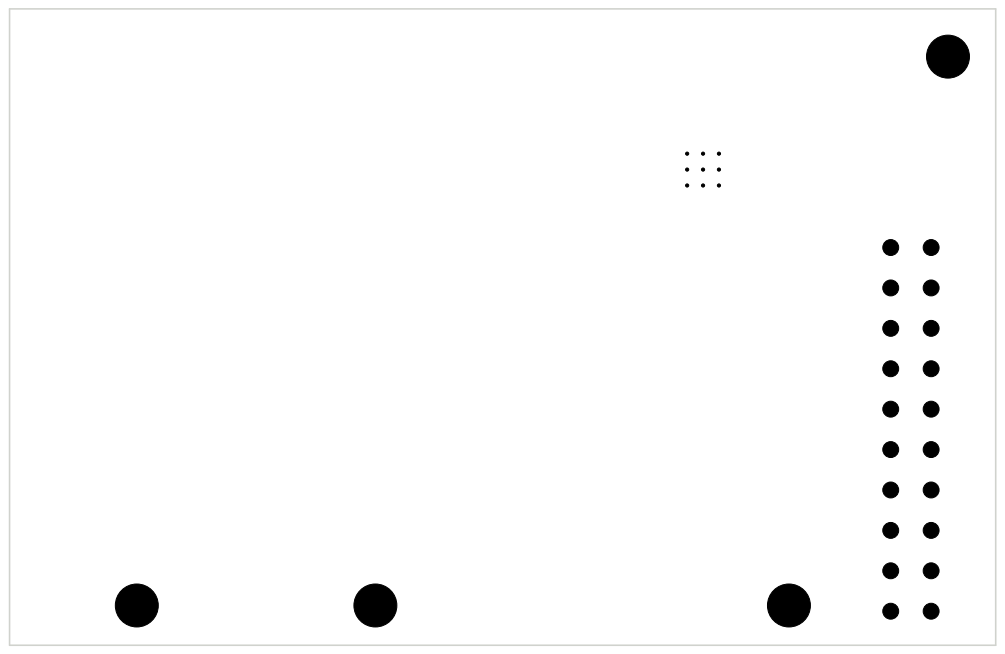
[picture p62: page 1]
