kpezeshki/esp32-s31-sdr/hw/board_b/fab/esp32sdr_b_routed-F_Cu.pdf

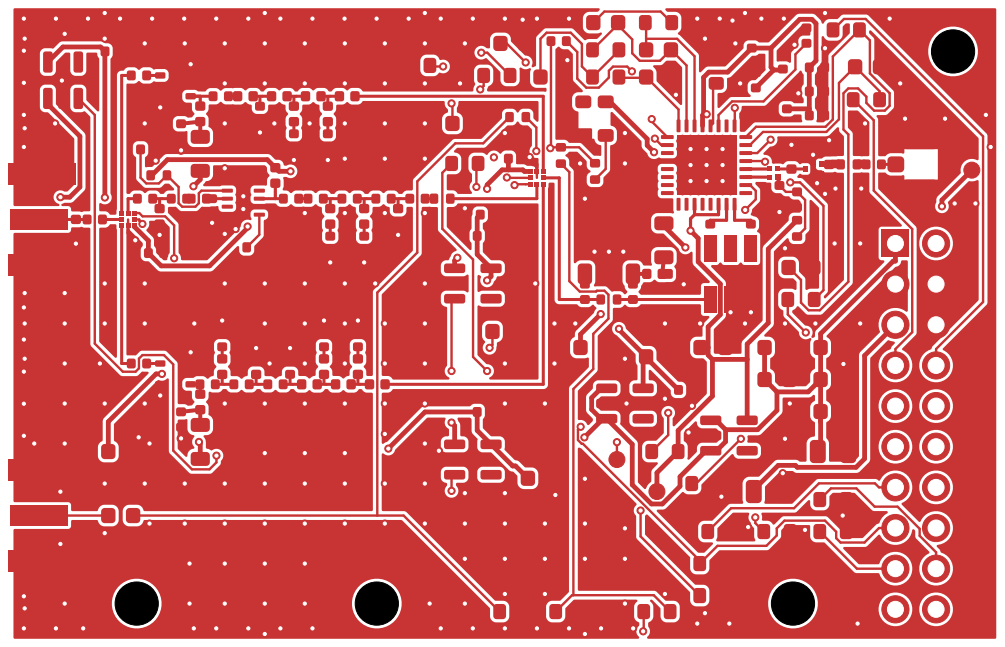
[picture p63: page 1]
