kpezeshki/esp32-s31-sdr/hw/board_b/fab/esp32sdr_b_routed-F_Silkscreen.pdf

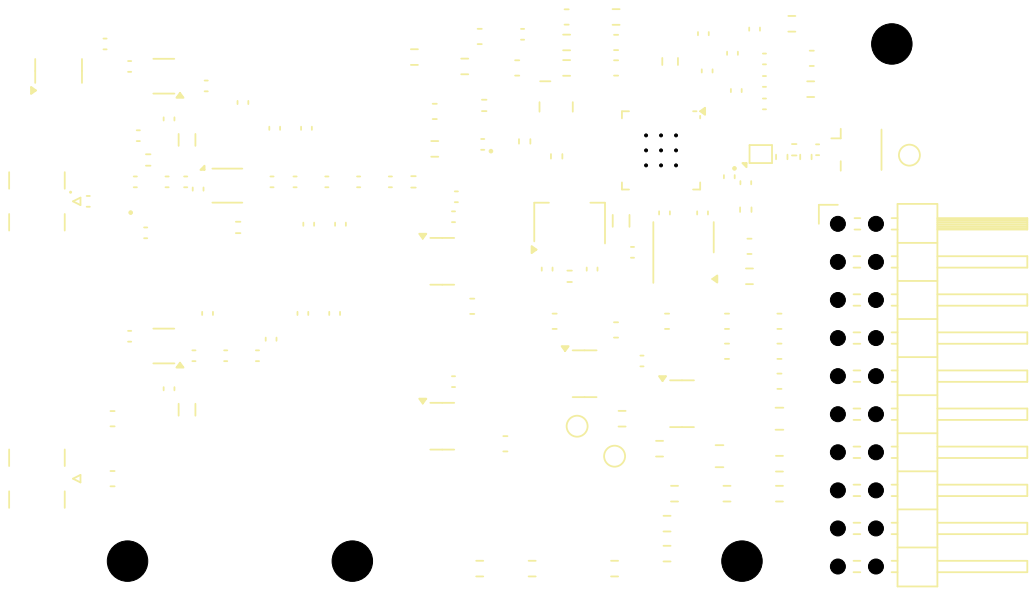
[picture p64: page 1]
