kpezeshki/esp32-s31-sdr/hw/board_b/fab/esp32sdr_b_routed-In1_Cu.pdf

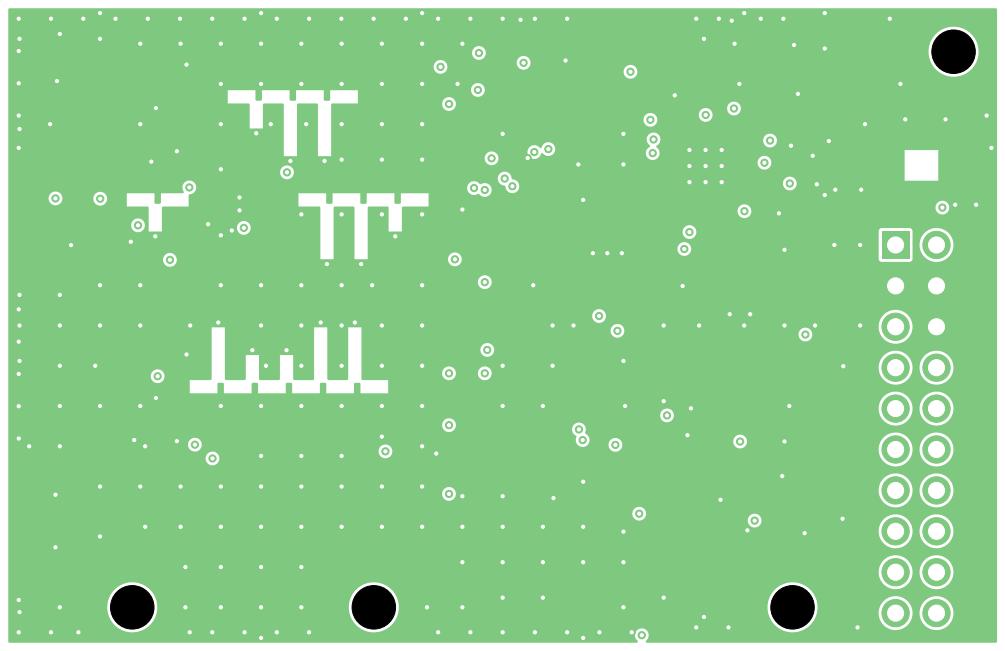
[picture p65: page 1]
