kpezeshki/esp32-s31-sdr/hw/board_b/fab/esp32sdr_b_routed-In2_Cu.pdf

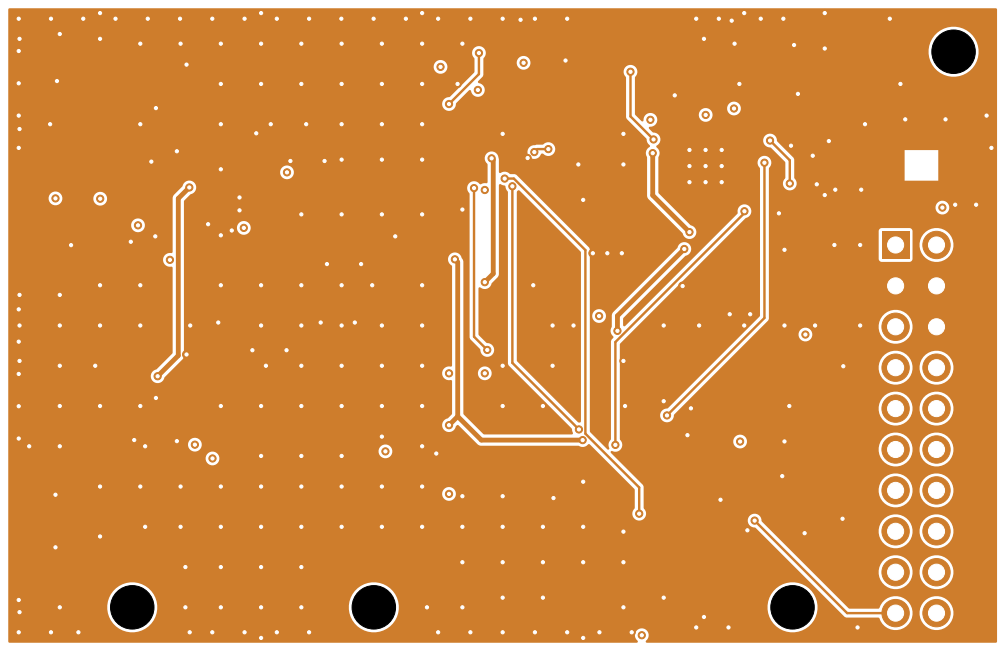
[picture p66: page 1]
