kpezeshki/esp32-s31-sdr/(list of files, drawings)

Other design files:
hw/fab/esp32_sdr.dsn
