kpezeshki/esp32-s31-sdr/hw/board_b/esp32sdr_b.kicad_pcb

## KiCad design hw/board_b/esp32sdr_b.kicad_pcb (2026-11-11)

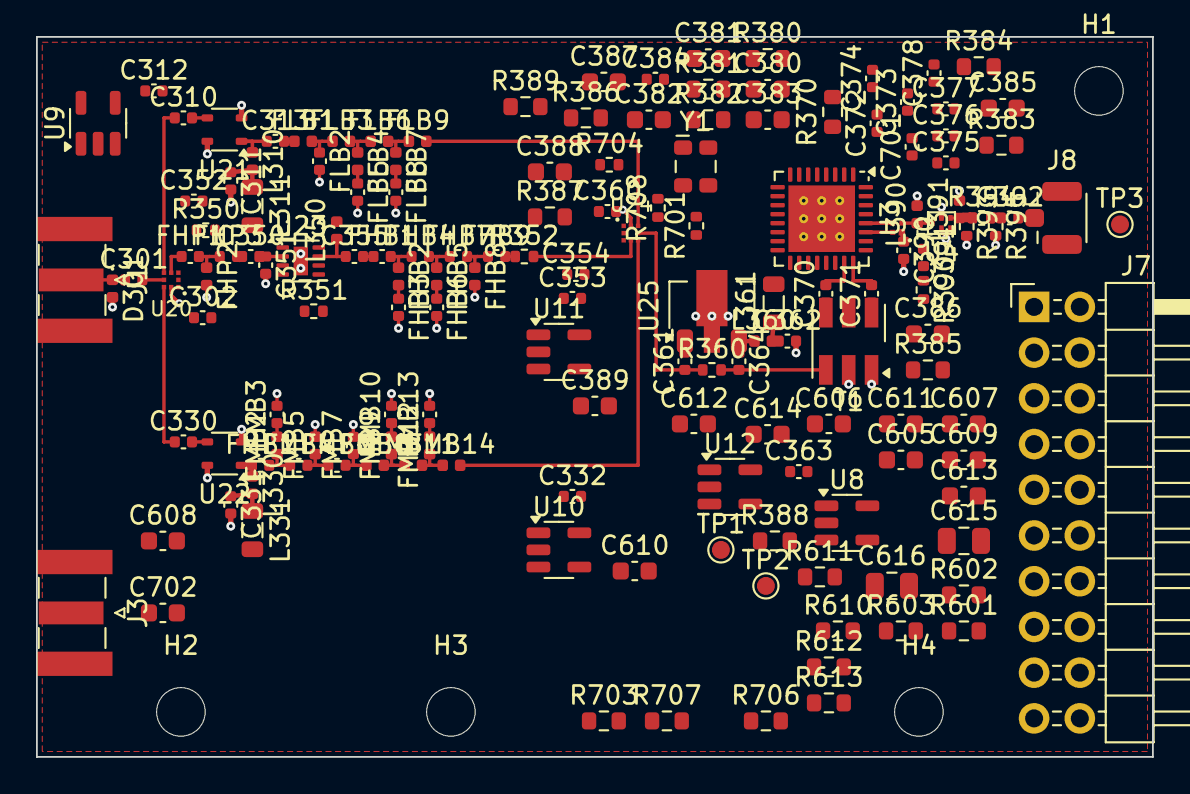
[picture p67: board esp32sdr_b.kicad_pcb from above]

Board: 4 copper layers, 62.0 x 40.0 mm, 160 parts (0 on the bottom side), 98 nets.

Parts:
C301, C310, C313, C330, C361, C364, C370, C371: 1nF; C_0402_1005Metric
C302, C312, C332, C360, C363, C373, C375, C377, C384, C391, C701: 100nF; C_0402_1005Metric
C311, C331, C352, C353, C362, C390: 100pF; C_0402_1005Metric
C350: 10pF; C_0402_1005Metric
C351: 0.2pF; C_0402_1005Metric
C354: 1uF; C_0402_1005Metric
C355: 5.6pF; C_0402_1005Metric
C372, C374, C376, C378, C392: 33pF; C_0402_1005Metric
C380: 8.2pF; C_0603_1608Metric
C381: 180pF; C_0603_1608Metric
C382, C383: 330pF; C_0603_1608Metric
C385, C386, C387, C388, C389: 33pF; C_0603_1608Metric
C605, C607, C609, C611, C613: 1uF; C_0603_1608Metric
C606, C608, C610, C612, C614: 4.7uF; C_0603_1608Metric
C615: 22uF; C_0805_2012Metric
C616: 10uF; C_0805_2012Metric
C702: 100nF; C_0603_1608Metric
D301: KLXES15AAA1; D_0402_1005Metric
FHB1: 2.4pF; C_0402_1005Metric
FHB2: 2nH; L_0402_1005Metric
FHB3: 3pF; C_0402_1005Metric
FHB4, FHB9: 1pF; C_0402_1005Metric
FHB5: 1.5nH; L_0402_1005Metric
FHB6: 4.7pF; C_0402_1005Metric
FHB7: 0.8pF; C_0402_1005Metric
FHB8: 1.3nH; L_0402_1005Metric
FHP1: 2.4pF; C_0402_1005Metric
FHP2: 2nH; L_0402_1005Metric
FHP3: 1.8pF; C_0402_1005Metric
FLB1, FLB4: 3.9nH; L_0402_1005Metric
FLB2: 2.4pF; C_0402_1005Metric
FLB3: 4.7nH; L_0402_1005Metric
FLB5, FLB8: 1.1pF; C_0402_1005Metric
FLB6: 3.3nH; L_0402_1005Metric
FLB7: 2.7nH; L_0402_1005Metric
FLB9: 1nH; L_0402_1005Metric
FMB1, FMB7: 1.8pF; C_0402_1005Metric
FMB2: 10nH; L_0402_1005Metric
FMB3: 1.1pF; C_0402_1005Metric
FMB4, FMB10: 0.5pF; C_0402_1005Metric
FMB5: 5.1nH; L_0402_1005Metric
FMB6, FMB13: 0.8pF; C_0402_1005Metric
FMB8, FMB11: 3.9nH; L_0402_1005Metric
FMB9: 6.8nH; L_0402_1005Metric
FMB12, FMB14: 3.3nH; L_0402_1005Metric
H1, H2, H3, H4: M2.5; MountingHole_2.7mm_M2.5
J1: SMA_MIX; SMA_Samtec_SMA-J-P-X-ST-EM1_EdgeMount
J3: SMA_REF; SMA_Samtec_SMA-J-P-X-ST-EM1_EdgeMount
J7: To base board; PinHeader_2x10_P2.54mm_Horizontal
J8: U.FL IF out; U.FL_Hirose_U.FL-R-SMT-1_Vertical
L310, L330: 33nH; L_0402_1005Metric
L311, L331, L361: 1uH; L_0805_2012Metric
L350: 18nH; L_0402_1005Metric
L360: 22nH; L_0402_1005Metric
L390, L391: 3.9nH; L_0402_1005Metric
R350: 4.7k; R_0402_1005Metric
R351: 22k; R_0402_1005Metric
R352, R360, R390, R701, R704, R708: 0; R_0402_1005Metric
R370: 51k; R_0603_1608Metric
R380: 22k; R_0603_1608Metric
R381, R382: 470; R_0603_1608Metric
R383, R384, R385, R386, R387, R706: 1k; R_0603_1608Metric
R388, R389: 4.7k; R_0603_1608Metric
R393, R395: 300; R_0402_1005Metric
R394: 18; R_0402_1005Metric
R601, R602, R603, R610, R611, R612, R613: 100k; R_0603_1608Metric
R703: 49.9; R_0603_1608Metric
R707: 390; R_0603_1608Metric
T1: H3-TCM2-63WX+; Mini-Circuits_DB1627
T2: BD2425N50200AHF; Anaren_Xinger_0404_BD2425
TP1: RFFC_LD; TestPoint_Pad_D1.0mm
TP2: 3V0_RF; TestPoint_Pad_D1.0mm
TP3: VGB; TestPoint_Pad_D1.0mm
U3: RFFC5072; QFN-32-1EP_5x5mm_P0.5mm_EP3.7x3.7mm_ThermalVias
U4: SAFEA2G45MC0F0AR00; Filter_1411-5_1.4x1.1mm
U8: TPS7A2030PDBVR; SOT-23-5
U9, U10, U11, U12: TPS7A2045PDBVR; SOT-23-5
U20, U24: BGS13SN8; Infineon_PG-TSNP-8-1_1.1x1.1mm_P0.4mm
U21, U22: PSA4-5043+; SOT-343_SC-70-4
U23: QPL9503; DFN-8-1EP_2x2mm_P0.5mm_EP0.8x1.6mm
U25: GVA-62+; SOT-89-3
Y1: TG2520SMN 40MHz; Oscillator_SMD_SeikoEpson_TG2520SMN-xxx-xxxxxx-4Pin_2.5x2.0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

Connections:
3V0_RF: C372.1, C373.1, C374.1, C375.1, C376.1, C377.1, C606.1, C701.1, R388.2, R390.1, TP2.1, U3.5, U3.19, U3.22, U8.5, Y1.4
3V3: C302.1, C360.1, C616.1, J7.5, U20.1, U24.1
5V0: C605.1, C607.1, C609.1, C611.1, C613.1, C615.1, J7.1, J7.2, U8.1, U8.3, U9.1, U10.1, U11.1, U12.1, U12.3
ESPCLK_DIV: R706.2, R707.1, R708.1
ESP_REFCLK: J7.20, R706.1
EXTREF_AC: C702.2, R703.1, R704.1
EXT_LO_DEC: C378.1, U3.3
EXT_REF: C702.1, J3.1
FHB_M1: FHB2.2, FHB3.1
FHB_M3: FHB5.2, FHB6.1
FHB_N1: FHB1.2, FHB2.1, FHB4.1
FHB_N2: FHB4.2, FHB5.1, FHB7.1
FHB_N3: FHB7.2, FHB8.1, FHB9.1
FHP_N1: FHP1.2, FHP2.1, FHP3.1
FLB_M3: FLB4.2, FLB5.1
FLB_M5: FLB7.2, FLB8.1
FLB_N1: FLB1.2, FLB2.1, FLB3.1
FLB_N2: FLB3.2, FLB4.1, FLB6.1
FLB_N3: FLB6.2, FLB7.1, FLB9.1
FMB_M1: FMB2.2, FMB3.1
FMB_M7: FMB9.2, FMB10.1
FMB_M9: FMB12.2, FMB13.1
FMB_N1: FMB1.2, FMB2.1, FMB4.1
FMB_N2: FMB4.2, FMB5.1, FMB6.1
FMB_N3: FMB6.2, FMB7.1, FMB8.1
FMB_N4: FMB8.2, FMB9.1, FMB11.1
FMB_N5: FMB11.2, FMB12.1, FMB14.1
GB_CHK: C362.1, L360.2, L361.1
GB_I: C361.2, U25.1
GB_O: C364.1, L360.1, U25.3
GND: C302.2, C311.2, C312.2, C331.2, C332.2, C351.2, C352.2, C353.2, C354.2, C360.2, C362.2, C363.2, C372.2, C373.2, C374.2, C375.2, C376.2, C377.2, C378.2, C382.2, C383.2, C385.2, C386.2, C387.2, C388.2, C389.2, C390.2, C391.2, C605.2, C606.2, C607.2, C608.2, C609.2, C610.2, C611.2, C612.2, C613.2, C614.2, C615.2, C616.2, C701.2, D301.2, FHB3.2, FHB6.2, FHB8.2, FHP2.2, FLB2.2, FLB5.2, FLB8.2, FMB3.2, FMB5.2, FMB7.2, FMB10.2, FMB13.2, J1.2, J3.2, J7.3, J7.4, J7.6, J8.2, L390.2, L391.2, R351.2, R370.2, R389.2, R393.2, R395.2, R601.2, R602.2, R603.2, R610.2, R611.2, R612.2, R613.2, R703.2, R707.2, T1.1, T1.2, U3.12, U3.33, U4.2, U4.3, U4.5, U8.2, U9.2, U10.2, U11.2, U12.2, U20.8, U21.2, U21.4, U22.2, U22.4, U23.4, U23.6, U23.9, U24.8, U25.2, Y1.2
HB_F_IN: C355.2, FHB1.1
HB_HPF_O: FHB9.2, R352.1
HB_IN: FHP1.1, U20.4
HB_LNA_I: C350.2, C351.1, U23.2
HB_LNA_O: C355.1, L350.1, U23.7
HB_OUT: R352.2, U24.4
HB_PRE_O: C350.1, FHP3.2
HB_SD: R351.1, U23.5
HB_VBIAS: C352.1, R350.2, U23.1
IF_CT: C390.1, C391.1, R390.2, T2.1
IF_OP_N: T2.4, U3.27
IF_OP_P: T2.3, U3.28
IF_OUT: C392.2, J8.1
IF_SAW_O: L391.1, R393.1, R394.1, U4.4
IF_SE: L390.1, T2.2, U4.1
LB_CHK: C311.1, L310.2, L311.1
LB_F_IN: C313.2, FLB1.1
LB_IN: C310.1, U20.5
LB_LNA_I: C310.2, U21.3
LB_LNA_O: C313.1, L310.1, U21.1
LB_OUT: FLB9.2, U24.7
LDO_EN_HB: J7.19, R603.1, U11.3
LDO_EN_LB: J7.17, R601.1, U9.3
LDO_EN_MB: J7.18, R602.1, U10.3
LF1: C380.1, R380.1, U3.6
LF2: C380.2, C381.2, R381.1, U3.7
LF3: C383.1, R382.2, U3.8
LF_A: C381.1, R380.2
LF_B: C382.1, R381.2, R382.1
MB_CHK: C331.1, L330.2, L331.1
MB_IN: C330.1, U20.7
MB_LNA_I: C330.2, U22.3
MB_LNA_O: FMB1.1, L330.1, U22.1
MB_OUT: FMB14.2, U24.5
MIX_DRV: C364.2, R360.2, T1.3
MIX_IN_N: C371.1, T1.6
MIX_IN_P: C370.1, T1.4
MIX_IPN: C371.2, U3.24
MIX_IPP: C370.2, U3.23
PAD_O: C392.1, R394.2, R395.1
REFCLK_RF: C384.1, R701.2, R704.2, R708.2
REF_IN: C384.2, U3.10
RFFC_ENBL: J7.10, R386.1
RFFC_ENBL_I: C388.1, R386.2, U3.1
RFFC_ENX: J7.9, R385.1
RFFC_ENX_I: C387.1, R385.2, U3.30
RFFC_LD: J7.12, TP1.1, U3.26
RFFC_MODE: R389.1, U3.9
RFFC_RESETX: J7.11, R387.1
RFFC_RESETX_I: C389.1, R387.2, R388.1, U3.29
RFFC_REXT: R370.1, U3.4
RFFC_SCLK: J7.7, R383.1
RFFC_SCLK_I: C385.1, R383.2, U3.31
RFFC_SDATA: J7.8, R384.1
RFFC_SDATA_I: C386.1, R384.2, U3.32
RF_IN_SMA: C301.1, D301.1, J1.1
SW1_COM: C301.2, U20.6
SW2_COM: C361.1, R360.1, U24.6
SW2_V1: J7.15, R612.1, U24.3
SW2_V2: J7.16, R613.1, U24.2
SW_V1: J7.13, R610.1, U20.3
SW_V2: J7.14, R611.1, U20.2
TCXO_OUT: R701.1, Y1.3
VGB: C363.1, C614.1, L361.2, TP3.1, U12.5
VLNA_HB: C353.1, C354.1, C612.1, L350.2, R350.1, U11.5
VLNA_LB: C312.1, C608.1, L311.2, U9.5
VLNA_MB: C332.1, C610.1, L331.2, U10.5
