kpezeshki/esp32-s31-sdr/hw/board_a/esp32sdr_a.kicad_pcb

## KiCad design hw/board_a/esp32sdr_a.kicad_pcb (2026-11-11)

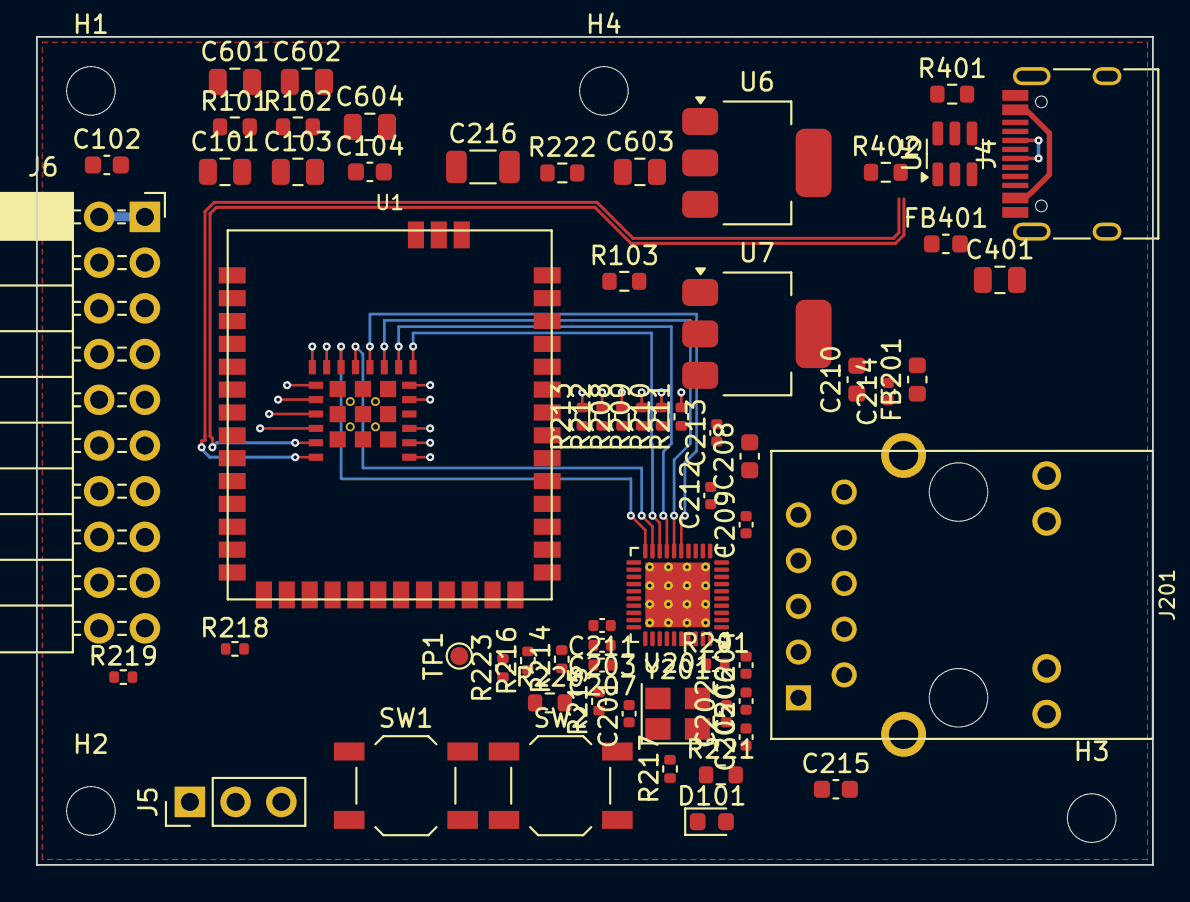
[picture p68: board esp32sdr_a.kicad_pcb from above]

Board: 4 copper layers, 62.0 x 46.0 mm, 67 parts (0 on the bottom side), 72 nets.

Parts:
C101, C401, C601, C603: 22uF; C_0805_2012Metric
C102: 100nF; C_0603_1608Metric
C103, C602, C604: 10uF; C_0805_2012Metric
C104: 1uF; C_0603_1608Metric
C201, C202: 15 pF 50V C0G; C_0402_1005Metric
C203, C204, C205, C206, C207, C209, C211, C212, C213, C214: 100 nF 16V; C_0402_1005Metric
C208, C210: 10 uF 10V; C_0603_1608Metric
C215: 100 nF 50V; C_0603_1608Metric
C216: 1 nF 2 kV; C_1206_3216Metric
D101: LED; LED_0603_1608Metric
FB201: 120 ohm @100 MHz, 2 A; L_0603_1608Metric
FB401: 120R@100MHz; L_0603_1608Metric
H1, H2, H3, H4: M2.5; MountingHole_2.7mm_M2.5
J4: USB-C; USB_C_Receptacle_HRO_TYPE-C-31-M-12
J5: UART; PinHeader_1x03_P2.54mm_Vertical
J6: To RF board; PinSocket_2x10_P2.54mm_Horizontal
J201: RJ45 1000BASE-T magjack, integrated magnetics + B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; RJ45_HanRun_HR911130C
R101, R102: 10k; R_0603_1608Metric
R103: 1k; R_0603_1608Metric
R201: 2.49k 1%; R_0402_1005Metric
R208, R209, R210, R211, R212, R213: 33R 1%; R_0402_1005Metric
R214, R215, R216, R217, R218, R219: 4.7k 1%; R_0402_1005Metric
R220, R221: 330R 1%; R_0603_1608Metric
R222: 0R; R_0603_1608Metric
R223: 0R; R_0402_1005Metric
R401, R402: 5.1k; R_0603_1608Metric
SW1: RESET; SW_SPST_TL3342
SW2: BOOT; SW_SPST_TL3342
TP1: GPIO60; TestPoint_Pad_D1.0mm
U1: ESP32-S31-WROOM-1U-N16R16V; Espressif_ESP32-S31-WROOM-1U
U5: USBLC6-2SC6; SOT-23-6
U6, U7: AMS1117-3.3; SOT-223-3_TabPin2
U201: YT8531DC-CA; QFN-40-1EP_5x5mm_P0.4mm_EP3.6x3.6mm_ThermalVias
Y201: 25 MHz, CL 12 pF, +/-10 ppm; Crystal_SMD_3225-4Pin_3.2x2.5mm

Connections:
3V3: C101.1, C102.1, C103.1, C601.1, J6.5, R101.1, R102.1, U1.2, U6.2
3V3_PHY: C603.1, FB201.1, U7.2
5V0: C401.1, C602.1, C604.1, FB401.2, J6.1, J6.2, U6.3, U7.3
BOOT: R102.2, SW2.1, SW2.2, U1.27
CC1: J4.A5, R401.1
CC2: J4.B5, R402.1
CHIP_PU: C104.1, R101.2, SW1.1, SW1.2, U1.3
ESP_REFCLK: J6.20, U1.35
ETH_INTN: R217.1, R223.1, U201.31
ETH_MDC: U1.7, U201.13
ETH_MDIO: R218.1, U1.10, U201.14
ETH_PHY_RST_N: R219.1, U1.11, U201.12
ETH_RXD0: R208.2, U1.53
ETH_RXD1: R209.2, U1.52
ETH_RXD2: R210.2, U1.51
ETH_RXD3: R211.2, U1.50
ETH_RX_CLK: R213.2, U1.48
ETH_RX_CTL: R212.2, U1.49
ETH_TXD0: U1.42, U201.18
ETH_TXD1: U1.43, U201.17
ETH_TXD2: U1.44, U201.16
ETH_TXD3: U1.45, U201.15
ETH_TX_CLK: U1.47, U201.20
ETH_TX_CTL: U1.46, U201.19
GND: C101.2, C102.2, C103.2, C104.2, C201.2, C202.2, C203.2, C204.2, C205.2, C206.2, C207.2, C208.2, C209.2, C210.2, C211.2, C212.2, C213.2, C214.2, C215.2, C216.2, C401.2, C601.2, C602.2, C603.2, C604.2, D101.1, J4.A1, J4.A12, J4.B1, J4.B12, J4.S1, J5.1, J6.3, J6.4, J6.6, J201.12, J201.13, R201.2, R214.2, R215.2, R222.2, R401.2, R402.2, U1.1, U1.40, U1.41, U1.62, U1.64, U5.2, U6.1, U7.1, U201.41, Y201.2, Y201.4
GND_CHASSIS: C216.1, J201.10, R222.1
GPIO60: TP1.1, U1.26
LDO_EN_HB: J6.19, U1.38
LDO_EN_LB: J6.17, U1.6
LDO_EN_MB: J6.18, U1.34
LED_A: D101.2, R103.2
LED_GRN_A: J201.11, R220.2
LED_STAT: R103.1, U1.39
LED_YEL_A: J201.14, R221.2
MAG_CT: C215.1, J201.1
MDI0_N: J201.3, U201.2
MDI0_P: J201.2, U201.1
MDI1_N: J201.7, U201.5
MDI1_P: J201.4, U201.4
MDI2_N: J201.6, U201.7
MDI2_P: J201.5, U201.6
MDI3_N: J201.9, U201.10
MDI3_P: J201.8, U201.9
PHY_3V3: C208.1, C209.1, C210.1, C211.1, C212.1, C213.1, C214.1, FB201.2, R216.2, R217.2, R218.2, R219.2, U201.11, U201.28, U201.29, U201.40
PHY_CFG_EXT: R216.1, U201.32
PHY_LED1: R215.1, R221.1, U201.33
PHY_LED2: R214.1, R220.1, U201.34
PHY_RBIAS: R201.1, U201.39
PHY_RXD0: R208.1, U201.25
PHY_RXD1: R209.1, U201.24
PHY_RXD2: R210.1, U201.23
PHY_RXD3: R211.1, U201.22
PHY_RX_CLK: R213.1, U201.27
PHY_RX_CTL: R212.1, U201.26
PHY_VDDL: C203.1, C204.1, C205.1, C206.1, C207.1, U201.3, U201.8, U201.21, U201.30, U201.38
PHY_XI: C201.1, U201.36, Y201.1
PHY_XO: C202.1, U201.37, Y201.3
RFFC_ENBL: J6.10, U1.56
RFFC_ENX: J6.9, U1.33
RFFC_LD: J6.12, U1.58
RFFC_RESETX: J6.11, U1.57
RFFC_SCLK: J6.7, U1.31
RFFC_SDATA: J6.8, U1.32
SW2_V1: J6.15, U1.60
SW2_V2: J6.16, U1.61
SW_V1: J6.13, U1.4
SW_V2: J6.14, U1.5
U0RXD: J5.3, U1.36
U0TXD: J5.2, U1.37
USB_DM: J4.A7, J4.B7, U1.54, U5.3, U5.4
USB_DP: J4.A6, J4.B6, U1.55, U5.1, U5.6
VBUS: FB401.1, J4.A4, J4.A9, J4.B4, J4.B9, U5.5
