kpezeshki/esp32-s31-sdr/(commit log)

2026-11-11 ESP32-S31 SDR: two-board design (analysis, EM-optimised filters, KiCad layouts, fab outputs, report)
    Board A (ESP32-S31-WROOM-1U + YT8531 GbE + USB-C) and Board B (wideband LNAs, lumped 0402
    band filters, RFFC5072 mixer, 2.44 GHz SAW IF), both routed and DRC-clean to JLC basic 4-layer
    rules. Design report in docs/report/.
    [BOM_A_DNP.csv, BOM_A_kit.csv, BOM_B_DNP.csv, BOM_B_HAND_LCSC.csv, BOM_B_JLC.csv, BOM_DNP.csv, BOM_FULL.csv, BOM_HAND_LCSC.csv]
2026-11-11 USB HS pair as coupled 90-ohm pair; 40 MHz reference stub removed; boards re-routed
    - Board A: USB 2.0 HS pair scripted as a coupled 0.17/0.11 mm pair over solid GND (DM/DP matched to 0.9 mm;
    was 13.5 mm skew); USB-C pad ties and GND bridges as post-route fixes; DRC clean
    - Board B: DNP reference-option links moved to the TCXO (REFCLK_RF 43 -> 13 mm); DRC clean
    - Refreshed fab outputs, renders and the report (docs/report)
    [BOM_B_DNP.csv, esp32sdr_a.kicad_pcb, esp32sdr_a_routed.kicad_pcb, esp32sdr_b.kicad_pcb, esp32sdr_b_routed.kicad_pcb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]
